arakawayao/digital-receiver/docs/engineering_design_v0.1.md

# 简易数字接收机初版工程设计说明

2026-10-04 源文件核对更正：当前 PLL 为 24 MHz ×5/÷3 / 40 MHz，根目录较新 EDA
放置 AD9235BRUZRL7-40；现有核心板桥接器为 USB 2.0 FX2。本文下列旧 10 MHz
实现描述失配，USB 3.0 仍是未落实的设计目标。当前事实和采样门槛以
[项目审阅结论](project_review_2026-10-04.md) 为准，未改变公共 IQ v1 契约或硬件工程。

版本：v0.3（两款 ADC 并列候选，型号与带通采样配置待定；沿用原文件路径）  
初版日期：2026-09-19；更新日期：2026-09-27  
架构确认日期：2026-09-27  
设计基线：SMA 单信号输入、12 位 ADC 射频带通采样（AD9235 或 ADC12020CIVYX/NOPB）、FPGA 数字下变频、USB 3.0 传输、上位机处理。

## 1. 目的、依据与设计状态

### 2026-09-29 实现增量

本次确定 FPGA 参考时钟为 24 MHz，计划 ADC 采样率为 10 MS/s。现有工程为
Quartus Prime 20.1.1 Lite / Cyclone IV E EP4CE6F17C8，替代下文早期 Artix 候选基线；
`adc_clk_gen` 使用 PLL ×5/÷12，尚未完成板级时钟验证。下文 19/20 MS/s 保留为数学算例。
10 MS/s 的实数采样折叠边界包括 90、95、100、105 MHz，完整占用频带须避开边界并留
保护带；固定此采样率不是已验证的全频段方案，也不能消除未知射频中心的歧义。

在当前计划速率下，原始 12 bit 数据为 120 Mbit/s（15 MB/s 紧凑排列，16 bit 容器为
20 MB/s），均未含协议开销；若后续保持 500 kS/s IQ，需总抽取 20 倍并先实现抗混叠滤波。
现有混频器在 10 MHz 捕获域工作，32 位 NCO，12 位实数输入，输出各 24 位/11 位小数的
I/Q 乘积。详细时序、数值范围和仿真入口见 [FPGA 模块说明](../main_project/fpga/README.md)。
仅采集和混频已通过独立 RTL 仿真，滤波/抽取、USB、上位机及综合上板仍未完成；
不修改既有归一化 IQ JSON 契约。下文未落实的模块继续作为设计计划。

### 方案背景

本文根据项目 README、项目规范及方案讨论，整理 PCB、FPGA、USB 传输和上位机设计。课程需求以根目录任务书为准；本文未重新核读原始 `.doc`，需求引用以 README 的整理为依据。ADC 保留两款并列候选，最终型号、原理图、RTL、软件及实物验证尚未完成。

2026-09-27 确认采用射频直接采样，每次从 SMA 输入单个 AM/FM 信号，使用带通采样降低速率。按最新更正，ADI `AD9235` 与 TI `ADC12020CIVYX/NOPB` 同时作为候选，撤回 ADC12020 单一选型结论；AD9235 的具体速率等级和封装尚未确定。输入经保护、预选滤波及驱动后进入 ADC，不设置模拟混频器或模拟中频；FPGA 数字下变频后经 USB 3.0 SuperSpeed 传输。10.7 MHz 模拟中频文档保留为未采用的历史备选，其中旧直采参数比较不代表本版。

本版采用带通采样，早期第一奈奎斯特区高速采样不是当前基线。ADC12020 最高 20 MS/s；AD9235 有 20/40/65 MSPS 速率等级，须按完整料号检查时钟范围。24/25 MS/s 不适用于 ADC12020 或 AD9235-20；对 AD9235-40/-65 也仅可在时钟、电气和带通采样条件验证后作为候选。单信号约束不自动解决未知 RF 中心频率的混叠歧义，需按第 3 节验证。

| 分类 | 内容 |
| --- | --- |
| 任务要求 | 88–108 MHz 输入；FPGA 采集、数字下变频和预处理后传输；上位机 AM/FM 识别、解调、放音、参数测量及结果管理；电路、PCB、3D 打印设计 |
| 已确定的方向 | SMA 每次单个信号、射频带通采样、12 位 ADC、核心板加扩展板、USB 3.0、SQL 记录管理 |
| 本版建议 | 可配置低抖动采样时钟、折叠频率映射与 I/Q 方向校正、USB 桥接控制器、IQ 文件加 SQL 元数据、电脑声卡输出 |
| 候选而非定型 | AD9235（速率等级/封装待定）与 ADC12020CIVYX/NOPB；Artix 核心板；19/20 MS/s 模型档位；500 kS/s IQ；每分量 16 bit；48 kHz 音频 |
| 待确认 | 实际时钟档位、调制带宽、射频频率识别策略、108 MHz 输入性能、其余器件、输入电平、工具版本及验收指标 |

器件资料来源：[ADI AD9235 产品页](https://www.analog.com/en/products/ad9235.html)、[TI ADC12020 产品页](https://www.ti.com/product/ADC12020)、[ADC12020 数据手册 Rev. B](https://www.ti.com/lit/ds/symlink/adc12020.pdf)。以下来自本对话已核对的官方产品信息，不代表已完成原理图设计或射频性能验证。

| 比较项 | AD9235 | ADC12020CIVYX/NOPB |
| --- | --- | --- |
| 状态 | 并列候选，完整料号待定 | 并列候选，料号明确但未定型 |
| 分辨率/通道 | 12 bit，单通道 | 12 bit，单通道 |
| 最高采样率 | 按等级为 20/40/65 MSPS，不是任意型号都能到 65 MSPS | 20 MS/s |
| 标称模拟输入带宽 | 500 MHz 差分输入带宽 | 100 MHz |
| 主供电 | 标称 3 V，官方范围 2.7–3.6 V | 5 V，容差和时序依手册 |
| 数字接口 | 并行输出，独立驱动电源支持 2.5/3.3 V 逻辑；码型依完整型号/配置核对 | 并行 CMOS/TTL，独立输出驱动电源，offset binary |
| 封装 | 28 引脚 TSSOP / 32 引脚 LFCSP 等选择，按料号确认 | 32 引脚 LQFP |
| 价格 | 用户反馈立创报价约 150 元起，未锁定等级和采购数量，不视为当前保证报价 | 以实际采购渠道、数量和报价为准，不预设更便宜 |
| 主要待验证项 | 具体等级、低采样率下 88–108 MHz 动态性能、驱动及成本 | 100–108 MHz 幅频/动态性能、供电与接口适配、成本 |

两者不默认引脚、封装、供电或时序兼容，也不要求首版 PCB 同时安装两颗 ADC。选型评审后按最终器件画板；如需兼容板，须另行明确需求和成本。各自的引脚、共模/满量程、最低时钟、占空比、输出延迟和建立保持须核对数据手册后再定。

**已知风险：ADC12020 标称 100 MHz 模拟带宽不是硬截止，也不保证 108 MHz 动态性能；AD9235 的 500 MHz 带宽同样不等于 108 MHz 有效精度保证。两者在 88–108 MHz 的幅频、SINAD、SFDR 及解调能力均待验证，不能用低输入频率 ENOB 代替。任务频段不自行缩减，不达标则记录并重新评审。**

目前已有离线 harness、IQ JSON 契约和合成样本，以及上文增量所列采集/混频 RTL；这些独立验证尚不能证明宽带 FM、硬件采集或实时音频可用，已有离线接口保持不变。

## 2. 系统总体架构

```text
单个受控 AM/FM 信号源（88–108 MHz）
      |
     SMA
      |
输入保护、匹配 -> 射频预选/抗混叠滤波 -> 衰减/增益 -> 差分 ADC 驱动
                                                            |
                                   候选 ADC（12 bit）<- 可配置低抖动采样时钟
                                                            |
                            FPGA：并行采集 -> 按折叠频率数字下变频
                                          -> 滤波/抽取、频谱方向校正
                                            -> FIFO/帧封装
                                                    |
                                      USB 3.0 桥接控制器及固件
                                                    |
                                                 USB 3.0
                                                    |
                       上位机接收、解析、连续性检查、有界队列分发
                              |               |               |
                         FFT/参数测量    AM/FM 识别与解调    IQ 分块文件
                              |               |               |
                         SQL 结果管理    音频重采样         SQL 文件索引
                                              |
                                           声卡 DAC
                                              |
                                         扬声器/耳机
```

示波器只作为可选调试测量设备，不在正式采集链路中；这是本版对早期“接示波器”表述的设计假设。若同时观察 SMA 信号，应使用适当功分器、耦合器或探测方式并计入损耗，避免直接并接两个 50 ohm 端接而改变负载。

本版只设计接收功能，原先“射频收发单元”收敛为射频接收前端。频段内的 AM 可由信号源产生；常见中波 AM 广播不在 88–108 MHz 范围内。FM 广播先实现单声道音频，立体声和 RDS 为扩展项。

本版正式输入假设是 SMA 每次一个目标信号。普通天线可能同时接收多个电台，不自动满足该假设；若恢复天线接收需求，必须重新验证模拟预选和混叠分离能力。

## 3. 采样、带宽与速率预算

### 3.1 单信号带通采样与频率歧义

采样率按单个信号的完整占用频带及折叠位置选取，不再要求高于两倍射频载波。ADC 模拟输入仍为 88–108 MHz，射频驱动、输入带宽与采样抖动要求不能按低基带频率替代。SMA 不会滤掉噪声或信号源谐波，模拟前端仍须控制其他可折叠输入。

设信号有效支撑区间为 `[fL, fH]`，包含调制边带与频率不确定性，`B = fH-fL`。理想带通采样区间可按 `2*fH/n <= Fs <= 2*fL/(n-1)`（整数 `n >= 2`）分析，并在两端留保护带。`Fs > 2*B` 只是必要的速率条件，不能保证频谱不会重叠。

折叠边界为 `k*Fs/2`。整个目标信号必须避开边界，不能只检查载波。定义 `m = floor(f_RF/Fs + 0.5)`、`f_signed = f_RF - m*Fs`，折叠后正频率为 `f_alias = abs(f_signed)`；在通带不跨边界时，`s = sign(f_signed)` 表示频谱方向。对有效半带宽 `H` 和保护余量 `G`，要求 `H+G < f_alias < Fs/2-H-G`。

以下只作模型算例，不是已选定硬件时钟。20 MS/s 是 ADC12020 与 AD9235-20 的规格上限示例，不是所有 AD9235 等级的上限。实际设定计入时钟容差；19 MS/s 也须按具体器件检查允许范围和时钟电气条件。

| RF 中心/MHz | Fs/MS/s | m | f_signed/MHz | f_alias/MHz | 处理 |
| --- | --- | --- | --- | --- | --- |
| 88 | 20 | 4 | +8 | 8 | 不翻转 |
| 95 | 20 | 5 | -5 | 5 | 校正频谱翻转 |
| 100 | 20 | 5 | 0 | 0 | 折叠边界，拒绝该配置 |
| 100 | 19 | 5 | +5 | 5 | 可进入带宽/保护带检查 |
| 108 | 20 | 5 | +8 | 8 | 映射可行，模拟性能仍待验证 |

固定 20 MS/s 无法保证任意 88–108 MHz 信号都可恢复；19/20 MS/s 两档也尚未被批准为全范围方案。需对实际信号带宽、频差、滤波过渡带和时钟误差扫描验证，非法配置明确拒绝，不使用有损折叠后的信号伪造有效解调。

**单信号仍有 RF 频率歧义。** 20 MS/s 时，88、92 和 108 MHz 均可映射到 8 MHz。已知粗略 RF 范围时，可由该范围确定候选区间，再测残余频偏；粗调输入不是测量结果。未知中心频率时，需不同采样率的测量交集、可调预选或其他独立信息判别，不能只凭单次 FFT 回填 RF 频率。

本版建议先评估多采样率候选集合匹配：按测得的别名频率和误差枚举 `m*Fs ± f_alias` 中落在 88–108 MHz 的候选，用其他采样率的结果筛选。只有唯一候选且稳定性检查通过，才输出有效中心频率；无候选/多候选均报告未确定。采样间信号频率和调制统计需足够稳定，不满足时该方法不能保证识别。19/20 MS/s 是否足以消歧须单独验证，不能把算法待实现当成系统已满足测频要求。

### 3.2 参数建议

| 参数 | 候选值/约定 | 定型条件 |
| --- | --- | --- |
| ADC 型号 | AD9235 或 ADC12020CIVYX/NOPB，并列候选 | 最终料号、封装、价格及 RF 性能待评审 |
| ADC 输入 | SMA 单个实数射频信号 | 输入电平、阻抗和保护门限待定 |
| ADC 采样率 | ADC12020 最高 20 MS/s；AD9235 依 20/40/65 等级 | 实际档位待定，19/20 MS/s 仅为模型算例 |
| ADC 分辨率/码型 | 两者均 12 bit；ADC12020 为 offset binary，AD9235 按型号配置核对 | 在采集入口统一补码；ENOB 和 108 MHz 性能待验证 |
| RF 调谐中心 | 88–108 MHz | 先明确折叠区间，NCO 使用别名频率而非直接填 RF |
| 复数基带采样率 | 候选 500 kS/s | 20/19 MS/s 示例分别抽取 40/38，系数待设计 |
| 初步基带通带 | 约 -100 至 +100 kHz | 仅作宽带 FM 预算起点，随频偏和测试信号调整 |
| 传输样本 | I、Q 各有符号 16 bit | 明确缩放、舍入及饱和 |
| 音频 | 48 kHz、单声道 | 需重采样和声卡时钟漂移处理 |

FM 带宽可先用 Carson 估计 `B ≈ 2 * (频偏 + 最高调制频率)` 并结合实测。例如 ±75 kHz 频偏和 15 kHz 调制对应约 180 kHz，只是论证示例，不是已确认指标。立体声复合基带、频率失配和滤波过渡带需要额外预算。

现有离线样本的 48 kS/s 复数基带和 2 kHz FM 频偏是算法小样本，不能直接验证这里的宽带 FM，也不能与候选 48 kHz 音频采样率混为一谈。

### 3.3 传输与存储预算

下表使用十进制 MB/GB，以 19/20 MS/s 模型档位举例，常规持续传输对象为抽取后的 IQ。20 MS/s 的预算不是所有 AD9235 等级的最坏情况；若选更高实际速率，按 `Fs*12/8`（紧凑码）或 `Fs*2`（16 bit 容器）重新计算原始字节率和缓存，并重算抽取，不能直接沿用本表。

| 数据 | 计算 | 有效负载速率 |
| --- | --- | --- |
| ADC 原始 12 bit，20 MS/s 示例 | 20e6 * 12 | 240 Mbit/s，即 30 MB/s |
| ADC 原始 16 bit 容器，20 MS/s 示例 | 20e6 * 16 | 320 Mbit/s，即 40 MB/s |
| ADC 原始 12 bit，19 MS/s 示例 | 19e6 * 12 | 228 Mbit/s，即 28.5 MB/s |
| 单通道复数 IQ | 500e3 * (16 + 16) | 16 Mbit/s，即 2 MB/s |
| IQ 连续一小时 | 2e6 * 3600 | 7.2 GB，不含帧头和文件开销 |
| 单声道 16 bit PCM | 48000 * 16 | 0.768 Mbit/s，即 96 kB/s |

USB 3.0 SuperSpeed 的 5 Gbit/s 是链路信号速率，8b/10b 编码后的理论上限为 4 Gbit/s，应用负载还受 USB 协议、桥接总线、固件、驱动和主机影响。降低 ADC 速率后，原始流仍需独立验证，不能只凭链路标称值保证持续上传。常规模式保持传输 IQ；原始快照/流的码型、协议和缓存未定义，不混入现有 IQ 帧。

每帧暂用 4096 个复数样本、16384 B 负载和 80 B 帧头，应用帧开销约 0.49%，数据速率约 2.010 MB/s，帧积累时间约 8.192 ms。建议实测持续吞吐至少留 25% 余量，即不低于约 2.513 MB/s，并单独测试停顿恢复。这是项目建议门槛，不是课程正式指标。

缓存按 `容量 >= 数据产生速率 * 允许停顿时间` 估算。2 MB/s 下吸收 100 ms 停顿至少需约 200 kB 样本空间，另加实现余量。约 256 KiB 可作为评估起点，但必须先核对 BRAM、桥接缓存和主机队列；更长停顿需更大缓存或明确丢样，不能靠平均吞吐掩盖。

## 4. PCB 与硬件设计

### 4.1 核心板与扩展板

核心板暂以 Artix 系列为候选，承担 FPGA、配置存储、JTAG 及已有电源；DDR 仅在缓存确有需要且核心板支持时采用。具体型号、封装、速度等级和工具版本未确定。

扩展板建议包括 SMA、射频前端、ADC、采样时钟、USB 桥接控制器、USB 连接器、局部供电、按键/开关和指示灯。若核心板已有其中部分功能，应调整归属避免重复设计。本版不配置以太网 PHY/RJ45、发射功放或模拟混频本振。

采购核心板前必须确认 ADC 的 12 路并行数据、时钟及控制信号能接入连接器，核对 Bank 电压、输入阈值、时钟引脚、板间延迟和走线条件。不能只按逻辑单元数量选板。

### 4.2 射频、ADC 与时钟

| 模块 | 设计要求 | 主要检查 |
| --- | --- | --- |
| SMA 与保护 | 候选 50 ohm 接口，评估保护器件寄生和限幅 | 输入匹配、最大安全输入、插损 |
| 预选/抗混叠滤波 | 覆盖目标及边带，抑制可混叠信号和强带外干扰 | 通带、阻带、端点及边带响应 |
| 衰减/增益 | SMA 单信号测试防过载，按输入范围决定增益；天线模式不作为当前基线 | 噪声、压缩、互调、削顶 |
| ADC 驱动 | 单端至差分、共模、满量程依器件资料设计 | 失真、摆幅、共模、带宽 |
| ADC | AD9235 / ADC12020CIVYX/NOPB 按候选分别核对等级、封装、接口及射频性能 | 外部已知输入、幅频、SINAD、SFDR、108 MHz 端点 |
| 采样时钟 | 可配置低抖动时钟、适当分配与端接，切换时禁止输出有效数据 | 实际档位、占空比、稳定、频率误差、杂散 |

ADC12020 使用 12 bit 并行 CMOS/TTL 输出，不采用 LVDS 或 JESD204 接口，也不假定存在 ADC 输出数据时钟或内建测试码。依据输入采样时钟、数据输出延迟和 FPGA 建立保持要求选择捕获边沿/相位，并建模 PCB 延迟。数字码测试由外部已知输入或仿真注入提供，具体校准方式待电路确定。

AD9235 也按并行接口评估，但单独核对其控制引脚、码型、输出时序和驱动电源，不能直接复制 ADC12020 的捕获约束。最终两种采集适配方案均向 DDC 提供统一有符号样本语义；未选型前可建立参数化模型，不制造未经核实的器件时序值。

ADC12020 按 5 V 主供电及独立 `V_DR` 设计；AD9235 按标称 3 V 主供电及其输出驱动电源设计。各自的电压范围、启动条件和 FPGA Bank 兼容性须依手册核对，不可混用，更不能把 5 V 数据直接接入 Artix。参考电压、差分满量程和共模分别核对，SMA 信号不能未经驱动/匹配直接套用 ADC 满量程。

抖动限制可用 `SNR_jitter = -20*log10(2*pi*f_in*t_jitter)` 估算。100 MHz 输入、1 ps 总 RMS 抖动对应约 64 dB，尚未计入 ADC 自身噪声；应分配时钟与 ADC 孔径抖动预算，不能用标称位数替代有效性能。

### 4.3 USB 3.0 子系统

建议独立 USB 3.0 桥接/设备控制器，FPGA 通过并行 FIFO 或等效本地接口发送数据。FX3 类方案可作为候选类别，尚未核实或指定型号。普通 FPGA GPIO 不能直接连接 SuperSpeed 差分线，USB 协议栈也不是 Artix 默认自带功能。

选型同步确认本地总线位宽/时钟/握手、电平、Bulk 端点、控制接口、固件及启动存储、主机驱动、合法 VID/PID 使用方式和持续吞吐。FPGA 至桥接器的本地带宽需要单独验算。

数据面采用 Bulk IN，控制面用控制传输或独立命令端点完成识别、配置、启停和状态回读；端点地址待器件确定。固件负责 DMA、缓冲、错误统计和 USB 复位处理，不能只完成设备枚举。

连接器待机械及供电方案确定。若用 USB-C，需正确设计 CC、角色、电流声明及插头翻转下的 SuperSpeed 走线/切换，不能简单并联双面高速引脚。线缆和连接器均需支持实际 SuperSpeed 链路。

### 4.4 电源、布线和结构

- 分别估算 FPGA、ADC、驱动、时钟、USB 控制器和前端功耗及启动时序。USB 总线或独立供电待定，不假定一个 USB 口足够供电；独立供电需处理 VBUS 检测和防倒灌。
- 射频、ADC 和时钟区域远离开关电源与 USB 高速区；保持连续参考平面，避免机械分割地平面导致高速回流跨缝。
- USB SuperSpeed 差分阻抗通常以 90 ohm 为目标，ADC 并行单端数据按器件要求；最终线宽、间距和时序容差由板厂叠层和器件指南计算，不猜定。
- ADC 采样时钟与并行数据、USB 差分对和板间连接分别设置约束，检查过孔、支路、参考层切换及连接器损耗。
- 按键建议用于复位及启停，开关用途待定；指示灯区分电源、配置就绪、USB、采集中和错误。控制模块统一处理防抖及主机命令优先关系。
- 预留测试点时避免高速长支路，执行原理图 ERC、PCB DRC，并记录豁免依据。
- 外壳核对 SMA/USB 插拔空间、核心板叠高、安装孔、散热和测试可达性，打印后实装验证。

## 5. FPGA 设计

### 5.1 模块划分

| 模块 | 主要职责 |
| --- | --- |
| 时钟与复位 | 各域时钟和同步释放复位，失锁时禁止输出有效数据 |
| ADC 采集 | 按候选的 12 路并行接口接收、捕获时序验证、流水线对齐及码型归一化 |
| 质量统计 | 过量程/削顶计数、采集错误及时钟状态 |
| NCO 与复数混频 | 别名频率调谐、相位推进、乘法、控制对齐及频谱方向校正 |
| 多级滤波抽取 | 抗混叠、带宽限制、速率降低和增益补偿 |
| 定点输出 | 缩放、舍入、16 bit 饱和及统计 |
| 缓冲与帧封装 | FIFO、样本索引、序号、状态和 CRC |
| USB 本地接口 | CDC、写入握手、流量控制和错误统计 |
| 控制寄存器 | 采样时钟配置、边界合法性、折叠区间/方向、启停、版本及状态回读 |

### 5.2 混频、滤波和定点

统一 `z[n] = I[n] + j*Q[n]`，正相位变化为正基带频率，与离线 IQ 契约一致。实数 ADC 输入采用：

```text
I_mix[n] =  x[n] * cos(phase[n])
Q_mix[n] = -x[n] * sin(phase[n])
phase[n+1] = phase[n] + 2*pi*f_NCO/Fs
```

NCO 使用目标 RF 的别名频率。正频率 DDC 后得到原始 I/Q，`s=+1` 时直接使用，`s=-1` 时在宽位宽域取共轭，再舍入/饱和，避免 int16 最小负数取负溢出。选择不跨折叠边界的整数 `m` 和方向 `s`，定义实际数字调谐对应的 `f_tuning = m*Fs + s*f_NCO`；校正后的频偏为 `f_RF - f_tuning`。不能将低速 NCO 值本身当作射频中心频率。

实数余弦混频的目标分量含 1/2 幅度因子，须纳入增益预算。I/Q 顺序、校正方向和缩放改变时同步模型与主机；频率区间未确定时不能把候选方向当成有效结果。

可先评估 32 bit 相位累加器，20 MS/s 示例的步进约 `Fs/2^32 = 0.00466 Hz`。这只是数字调谐分辨率，实际 RF 精度受折叠区间判别、时钟误差、校准及估计算法限制；RF 误差预算仍需考虑约 100 MHz 输入，不能按小的别名频率低估时钟影响。

若保持 500 kS/s IQ，20 MS/s 示例总抽取倍数为 40，19 MS/s 示例为 38；任意时钟不一定能用整数抽取得到相同输出率，需要约束档位或设计有理重采样。各档分别确定多级结构、通阻带、纹波、抑制度、位宽和滤波配置 ID，可比较 CIC、补偿 FIR 和多相 FIR，不能只验证倍率乘积。

CIC 的通带下垂、有限阻带和增长位宽需计算；每级抽取前抑制会折叠入最终有效通带的分量，末级滤波无法消除已经产生的混叠。滤波系数尚未确定。

ADC12020 输出为 12 bit offset binary：整数意义上 `signed_sample = unsigned_code - 2048`，范围为 -2048 至 2047；可翻转最高位后按有符号补码解释。AD9235 的实际码型在完整型号和配置明确后记录：若为 offset binary 则用相同转换；若为补码则直接有符号解释，不能重复偏移。两者在进入 DDC 前统一有符号语义，扩位明确符号扩展。乘法/累加器按最坏情况定宽，每个缩位点记录移位、舍入和饱和；USB I/Q 各 16 bit 是处理后容器，不表示 ADC 精度提高。

并行 ADC 按每个采样周期一个 12 bit 样本设计，DSP 时钟与流水线由资源/时序评估决定。不同采样档位均需独立检查时序约束、NCO 步进、抽取系数及样本索引，不继续沿用高速解串接口假设。性能以综合、实现时序及上板为准。

### 5.3 时钟域、反压和异常

采集域、DSP 域、USB 本地接口域依实际设计划分，多位数据跨域采用异步 FIFO 或握手，控制信号采用适当同步。流接口明确 `valid/ready`，停顿期间保持数据与控制稳定。

ADC 连续采样，不能因 USB 反压假定输入暂停。建议以完整 IQ 帧管理缓存，空间不足时丢弃新产生的完整帧，继续推进样本索引和生产序号并增加丢样计数；下一可交付帧报告间断/溢出。不能拼接部分新旧帧，桥接侧仅在确认有空间后接收数据。

时钟失锁、ADC 失步或严重采集错误时停止输出有效样本并保留状态，恢复后重新校准及建立新流。调谐、采样配置变化和重启也建立新 `stream_id`，滤波过渡期结束后再发送有效数据。

采样时钟切换顺序为停止旧流、修改时钟、确认稳定、复位/清空旧配置流水线和 FIFO、加载新 NCO/滤波/方向配置、回读后启动新流。时钟确认方式及等待时间依器件资料和实测确定。没有 ADC 内建锁定/错误指示的状态不得虚构为已检测，需说明由时钟芯片、FPGA 监测或软件判断的来源。

## 6. USB 应用协议草案

本节为待 FPGA/HOST 联合评审的线上协议提案，尚未实现。现有 `docs/iq_contract.md` 离线 JSON v1 不变。USB Bulk 读取边界不是应用帧边界，主机必须处理分片、合并和残留数据。

### 6.1 帧布局建议

固定 80 B 帧头，随后为 IQ 负载；多字节整数及浮点值采用小端，浮点采用 IEEE 754 binary64。负载为 `I0,Q0,I1,Q1,...`，每分量 `int16`，每复数样本 4 B。

| 偏移/B | 长度/B | 字段 | 语义 |
| --- | --- | --- | --- |
| 0 | 4 | magic | ASCII `IQS1` |
| 4 | 2 | version | 本草案为 1 |
| 6 | 2 | header_bytes | 本草案固定 80 |
| 8 | 4 | payload_bytes | 等于 `sample_count * 4` |
| 12 | 4 | flags | 间断、FIFO 溢出、削顶等，位定义待冻结 |
| 16 | 8 | stream_id | 主机分配，会话内不重复；新流重新开始索引 |
| 24 | 8 | sequence | 从 0 起的生产帧序号，被丢弃帧同样消耗序号 |
| 32 | 8 | first_sample_index | 首个样本的流内计划输出索引，丢样仍推进 |
| 40 | 8 | sample_rate_hz | 正有限 binary64，复数基带采样率，标称/校准来源另存配置 |
| 48 | 8 | tuning_center_hz | 有限 binary64，已确定折叠区间下的 RF 调谐中心，不是别名频率或测量结果 |
| 56 | 4 | config_id | 与该流不可变配置记录关联 |
| 60 | 2 | sample_format | 候选编码 1 表示归一化有符号 16 bit I/Q |
| 62 | 2 | channel_count | 本版固定 1 |
| 64 | 4 | sample_count | 正常 4096，停止时可发送非零短帧 |
| 68 | 4 | reserved | 置 0 |
| 72 | 4 | header_crc32 | 覆盖帧头字节 0–71 |
| 76 | 4 | payload_crc32 | 覆盖完整 IQ 负载 |

CRC 建议使用 CRC-32/ISO-HDLC，反射多项式 0xEDB88320，初值和最终异或均为 0xFFFFFFFF，`123456789` 检验值为 0xCBF43926。USB 已有链路检错，应用 CRC 用于封装、保存和回放检查；实现前冻结共用测试向量。

接收端限制最大 4096 个复数样本，先检查头部和长度，再接收/分配负载；拒绝未知版本、格式、非有限或非法数值。CRC 错误、帧序号或样本索引不连续均产生可见事件，重新同步不伪造连续数据。

16 bit 分量转离线浮点时采用 `value / 32768`，范围为 `[-1, 1)`，仅为数字归一化幅度；电压/功率解释需要模拟增益、满量程和校准信息。离线 JSON v1 只导出连续片段，不能把有缺口样本直接拼成一个 capture。

### 6.2 控制与生命周期

建议命令为 `GET_INFO`、`GET_STATUS`、`SET_CONFIG`、`START`、`STOP`，请求标识和明确应答用于确认执行结果。实际 NCO 频率、采样率、滤波、缩放、固件版本和错误计数可回读；本版不冻结端点地址和寄存器位定义。

控制面和持久化配置补充 ADC 完整型号/速率等级、输入码型、实际/标称 ADC 时钟及来源、RF 搜索范围、折叠整数 `m`、方向 `s`、别名 NCO、方向已校正标记、频率候选/确定状态和滤波配置 ID。80 B 帧布局与离线 JSON v1 不变；`sample_rate_hz` 仍是 IQ 速率，`tuning_center_hz` 仍是 RF 调谐中心。主机不得二次取共轭。未知 RF 的探测阶段数据另作待定分析，正式连续 IQ/JSON 输出前必须有明确 RF 映射；原始实数探测数据协议另行定义，不伪装成已确定 RF 的 IQ 帧。

先保存配置再启动采集；配置变化先结束旧流，新配置生效后建立新流。主机保存启动 UTC 时间和单调时钟参考，样本索引用于相对采集时间，不能把 USB 到达时间当作精确采样时刻。新流索引零点为滤波稳定后的首个计划有效样本。

USB 断连时结束当前流、取消传输并记录原因；重连重新核对设备和配置。检测实际协商速度，本版要求 SuperSpeed，降为 USB 2.0 默认拒绝启动并提示；后续如支持降级，需独立预算和验证。

## 7. 上位机设计

### 7.1 模块与技术栈候选

首版可评估 Python + NumPy/SciPy 算法、Qt/PySide 界面、SQLite 本地 SQL、USB 库或厂商 SDK 异步传输和成熟音频库。它们是候选依赖，尚未安装或写入项目；确认主机系统、驱动、许可证、分发和性能后再确定。现有标准库 harness 不因此增加依赖，PyTorch 不是必需条件。

| 模块 | 职责 |
| --- | --- |
| 设备接入 | 枚举、版本检查、配置、异步接收、取消及重连 |
| 协议解析 | 分片缓存、CRC/字段校验、流与缺口识别、I/Q 转换 |
| 数据分发 | 有界队列、DSP/记录/显示分发、水位和延迟统计 |
| 信号处理 | 通道滤波、FFT/PSD、识别、测频、解调和重采样 |
| 音频 | 回调、音量、静音、缓冲和时钟漂移控制 |
| 记录管理 | IQ 文件、SQL 事务、查询、分类、回放及导出 |
| 界面 | 设备状态、调谐、频谱、结果、录制和历史记录 |

USB、磁盘、DSP 和界面刷新分开调度，不能相互无限阻塞。音频回调避免访问数据库、磁盘和耗时计算，信号按块处理，不在 Python 层逐样本循环处理高速流。

### 7.2 FFT、中心频率与识别

FFT 使用窗函数、幅度归一化和可选平均，显示当前接收通道频谱。bin 间隔 `Fs_IQ/N` 不等于测量准确度。全频段同时显示/扫频属于扩展，不能把单通道频谱标成完整 88–108 MHz 实时频谱。

仅在折叠区间已确定且 FPGA 完成方向校正后，中心频率采用 `f_center_est = f_tuning + f_offset_est`。载波明显的 AM 可评估峰值插值或载波跟踪；FM 可结合占用频带中心、鉴频均值及观测条件估计。不能把最大 FFT 峰或用户粗调值直接当作 RF 测量结果。未消除歧义时报告未确定并保留候选，不强制生成有效 RF 数值；测量记录包含方法、输入先验、观察时长、有效性及校准信息。

先判断有无有效信号、削顶和带宽，再根据包络变化、瞬时频率变化及谱特征识别，允许 `AM`、`FM`、`unknown`、`no_signal`。低信噪比、未调制载波及混合信号可能无法可靠区分；保留不确定状态，不能读取样本真值标签完成判别。

### 7.3 解调与放音

- AM：常规带载波 AM 采用包络检测、去直流、音频低通和电平控制；抑制载波 AM、SSB 不在首版保证范围。
- FM：可用 `arg(z[n]*conj(z[n-1])) * Fs_IQ/(2*pi)` 鉴频，频偏加残余频差必须满足相位差不混叠条件；低幅度和无信号时抑制异常音频。
- 广播 FM 去加重常数依接收标准选择并保存，不能对所有信号无条件使用同一常数。单声道输出需滤除无用复合基带分量。
- 500 kS/s 至 48 kHz 可用分阶段或有理重采样，总比例 12/125，满足抗混叠；AM/FM 各自设置合适音频带宽。
- ADC 和声卡时钟独立，会造成长期缓冲漂移，应根据水位反馈做小幅自适应重采样或其他经验证的速率匹配，不能只设置相同名义采样率。
- 丢样、重调谐或无信号时重置相关滤波/鉴频状态，静音或淡入淡出，并保留事件，不能跨缺口按相邻样本鉴频。

数字音频交给电脑声卡 DAC 转为模拟信号，由扬声器、耳机或有源音箱输出。麦克风是输入器件；扩展板本版无需额外音频 DAC。

### 7.4 IQ 文件与 SQL 记录

采用“按块保存 IQ 二进制文件 + SQLite 元数据及索引”，保留 SQL 需求，但不逐样本写 SQL 行，以减少事务开销和存储放大。波形文件可保存带版本、索引和 CRC 的应用帧，另存完整配置，并支持离线回放。

| 逻辑表 | 建议字段内容 |
| --- | --- |
| captures | 采集 ID、UTC 起止时间、设备/固件/软件版本、结束原因 |
| stream_configs | 流标识、ADC 型号、ADC/IQ 速率、RF 调谐、折叠区间/方向、NCO、先验/确定状态、滤波、位宽、缩放、增益、校准 |
| segments | 文件位置、字节偏移、起止样本索引、样本数、连续性与校验 |
| measurements | 流及样本区间、中心频率及单位、调制类型、有效性、算法版本 |
| events | 断连、丢样、FIFO 溢出、削顶、磁盘异常及对应索引/时间 |

按时间、中心频率、调制类型检索分类，支持测量结果和音频导出。SQL 使用参数化查询，旧记录保留原配置；实际表结构、外键、索引和迁移版本待实现时定义。

按大小或时间切文件，写入成功后提交对应索引，关闭时执行必要持久化；崩溃恢复检查未完成片段和数据库/文件一致性。录制前检查空间并配置保留策略，默认不自动删除历史数据。

显示队列满可丢过时刷新；DSP 为恢复实时性丢积压数据时需报告缺口并重置状态；录制队列或磁盘异常时停止该次录制并记录原因，不能静默丢块仍称完整波形。严格无丢样模式中，任一丢样应使该次采集失败。

## 8. 验证计划与交付门槛

以下均待执行，本次文档编写没有完成相应功能验证。

| 阶段 | 验证内容 | 证据 |
| --- | --- | --- |
| 需求/预算 | 带宽、电平、干扰、成本及功耗 | 器件资料、预算、未决项 |
| 浮点模型 | 单个 RF AM/FM 的带通采样、正负频偏、边界碰撞、不同采样率及 RF 消歧，另测噪声/谐波 | 频率映射、共轭校正、非法配置拒绝和有效测频结果 |
| 定点模型 | 按候选码型配置检查 12 bit 转换、符号扩展、最小负数共轭、量化和饱和 | ADC12020 的 offset binary 边界及 AD9235 实际配置对应向量 |
| RTL 仿真 | 并行 ADC 模型、复位、有效间断、反压、FIFO 满空、时钟/滤波配置切换 | 捕获时序、流水线对齐、丢帧/索引结果 |
| USB/主机 | 分片/合帧、非法长度、CRC、断连、复位、慢消费者 | 协议向量、持续吞吐、水位、恢复日志 |
| 综合实现 | 真实器件、时钟和接口约束 | 工具/IP 版本、资源、CDC 与时序报告 |
| PCB | ERC/DRC、叠层、阻抗、供电和连接器 | 源工程、BOM、制造输出及豁免依据 |
| 上板 | 按最终候选核对主/输出供电、FPGA 电平、时钟、已知 ADC 输入、USB 和采样 | 电压/电流、幅频、捕获时序、SINAD/SFDR，重点记录 100–108 MHz |
| 系统 | SMA 单个信号覆盖 88/108 MHz 及代表点 AM/FM，含未知 RF 和折叠边界 | RF 消歧、测量、音频、丢样、回放及 SQL 查询记录 |
| 长时运行 | USB/磁盘停顿、声卡漂移、热稳定、断连恢复 | 延迟、水位、错误、运行时长和温度 |
| 结构 | PCB、线缆与打印件实装 | 间隙、可达性、散热检查 |

频率精度、最低输入电平、最大无损输入、识别准确率、音频质量、延迟和连续运行时间尚无正式阈值，应在采购前补齐。能发声不等于参数验收完成，离线 harness 通过不能替代 RTL、时序或系统验证。

现有入口为 `python -B -m harness.runner run --jobs 3`；后续只有真实可运行的检查才加入 `harness/tasks.json`。当前协议草案不改变离线 JSON v1 和已有样本参数。

## 9. 实施顺序与未决事项

1. 确认预算、可用仪器、输入电平和 AM/FM 测试范围，评审候选参数。
2. 比较 AD9235 完整料号与 ADC12020CIVYX/NOPB 的报价和 RF 性能，再联合选择 ADC、Artix 核心板、时钟及 USB 桥接器，核对供电/时序。
3. 建立单信号带通采样、边界拒绝、方向校正和 RF 消歧模型，再冻结时钟档位、滤波、定点及 USB 应用协议。
4. 用模拟数据贯通 FPGA 封装、USB 固件、主机接收及回放，再接 ADC/DDC，各阶段独立留证。
5. 完成原理图、PCB、供电/时钟/采集联调，接入识别、解调、音频和记录管理。
6. 完成外壳、系统测试及课程交付，按实测修订设计。

五人分工沿用工作计划：HW 负责选型/原理图/PCB；FPGA-A 负责采集、CDC、封装及 USB 桥接固件集成；FPGA-B 负责 DDC 和定点参考模型；HOST 负责上位机；INT 负责公共契约、结构和验收协调。人员待指定，目录归属继续遵循 `docs/work_plan.md`，USB 固件文件归属在实际建目录前由 INT 与 FPGA-A 明确。

| 未决事项 | 影响 | 决策依据 |
| --- | --- | --- |
| 两款 ADC 的最终选型与核心板型号 | 108 MHz 性能、速率等级、供电/并行时序、成本 | AD9235/ADC12020 资料与实测、实际报价、核心板原理图 |
| 输入范围和干扰条件 | 保护、增益、衰减、滤波 | 信号源、天线环境及验收条件 |
| USB 桥接器/连接器/主机平台 | 驱动、固件、电平、供电、布线 | SDK/接口资料和持续吞吐实测 |
| 采样档位、RF 消歧和校准 | 是否可恢复完整边带、是否可唯一测频 | 带宽/边界扫描、多率候选集合、时钟及高频实测 |
| 通道带宽和滤波 | 资源、音质、邻道抑制 | 调制参数及模型 |
| 缓存和记录策略 | 丢样、成本、时延 | 停顿测试、BRAM/存储预算 |
| 叠层、散热和供电 | 可制造性、完整性、便携性 | 板厂参数、功耗、结构 |
| 正式指标与交付格式 | 课程验收 | 补充规范及评审结论 |

后续调整采样率、I/Q 格式或协议时，同步更新 FPGA、USB 固件、上位机、参考向量和文档，不仅修改单端。

## 10. 后续 Harness 工作入口

后续对话先读取本方案、`docs/work_plan.md`、`docs/iq_contract.md` 和 `harness/tasks.json`。AD9235 与 ADC12020CIVYX/NOPB 均为候选，W-009 未完成，W-005 需分别核对接口时序。模型的器件身份、速率等级/上限、实际时钟和码型应参数化，不能把 ADC12020 当唯一硬件。现有 JSON 描述连续归一化基带 IQ，不是原始 RF 数据，不静默修改该契约。

建议优先补充以下真实模型/测试，完成后再按已有工作包和 writes 规则注册 harness；本次未新增可执行检查，也未运行硬件验证：

1. 参数化 RF 合成与带通采样，检查完整边带、保护带及候选器件/等级的时钟上限。19/20 MS/s 仅为样例；ADC12020 和 AD9235-20 拒绝超过 20 MS/s，AD9235-40/-65 按对应等级独立校验，不全局禁止或允许 24/25 MS/s。最低频率/占空比等未核实参数标待定。
2. 同别名不同 RF 的歧义用例、多采样率匹配、频率不稳定及不能唯一判定的错误路径；频率识别不得读取样本真值标签。
3. 上下折叠方向、正负频偏、AM/FM 解调极性与 RF 元数据；覆盖折叠到直流/Nyquist 附近必须拒绝的情况。
4. ADC12020 的 12 bit offset binary 0/2047/2048/4095 边界，以及 AD9235 最终码型配置对应转换；共同检查符号扩展、共轭、饱和和按实际档位的抽取/重采样，不把未确认 AD9235 码型写成器件事实。
5. 时钟切换的新流/配置同步、USB 反压/缺口和上位机回放，实际 RTL/USB 入口就绪后再注册对应检查。

离线模型只能验证数学和接口逻辑，不能证明任一候选在 108 MHz 的实际性能，也不能替代时钟、PCB 和实时音频验证。正式验收指标仍待确认。
