arakawayao/digital-receiver/main_project/host/docs/FM_ANTENNA_AUDIO.md

# 天线 FM 播放诊断

后续用户排查：停止接收后播放视频也有嗡声，Windows 24 位输出有杂音、16 位无此现象。
因此下文 WAV 听感不能单独作为射频干扰证据；不依据该听感判定 LNA 故障或增加陷波器。

2026-10-26。对象：手动 103.7 MHz，天线经 88–108 MHz 滤波器与约 46 dB LNA 接入 ADC。
用户另报告 93.4 MHz 类似现象，但本次没有收到该频道的数据。

## 实际采集证据

用户采集位于 `D:/class_project/main_project/`，目录分别为：

- `capture_20261026_164238_735271`，去加重关闭，约 3.976 秒。
- `capture_20261026_165140_813586`，75 µs，约 4.015 秒。
- `capture_20261026_165226_885213`，50 µs，约 4.016 秒。

三份均为 USB 手动 103.7 MHz，用户确认都经过 LNA、停止后保存；去加重改变后仍听到嗡声。
保存时间与最后有效帧时间的差异不能当作运行中断流证据。

三份保存的 I/Q 索引连续，元数据记录 CRC、序号间断、FPGA/主机丢样和削顶帧均为 0；
独立按 40 ms 分块识别分别有 99/100/100 块，全部 FM。保存音频未发现反复长段静音。
这些结论只覆盖已保存窗口，不排除其他时刻识别跳变或模拟前端过载。

第一份主要音频峰约 196/330 Hz，随时间变化，不能认定为 50/100 Hz 工频。
50/75 µs 两份录到不同时刻节目，不能用相互频谱差异作去加重的受控比较。
用户确认 WAV 也有嗡声，说明该现象不只发生在实时扬声器缓冲。
在没有节目参照或前端对照前，不强制滤掉这些频率，以免损伤语音和音乐。

旧进程音频计数跨采集累计；例如 1816 欠载、999 溢出不能写成本次 48 秒内的次数。
元数据中的音频设备异常也需通过新会话的具体回调状态复核。

摘要与同一份 I/Q 解调的 0/50 µs WAV 对照在 `evidence/fm_audio_20261026/`。

## 音频长时间播放修正（2026-10-27）

用户实测日志显示仅音频欠载/溢出增长，USB CRC、I/Q 连续性和 DSP 丢弃没有增长。
这将问题范围收敛到输出设备回调调度和音频有界队列，不归因于 RF 或 USB。

Windows 默认 MME 设备实测回调可能约每 40 ms 成批到达，虽然程序按 20 ms 请求 960 点；
旧 120 ms 预缓冲和 250 ms 容量遇到长时间调度抖动时可能先回调空窗欠载，再在处理线程追赶时溢出。
新版默认设备选择优先使用与系统默认输出同名且支持 48 kHz 的 Windows WASAPI，
打开失败才回退系统默认设备；用户在设备下拉框中明确选择的设备不自动替换。
队列会按实际设备 latency 配置预缓冲 `max(120 ms, latency+80 ms)`，容量为预缓冲加
`max(250 ms, latency+120 ms)`；仍是有界队列，不伪造样本。

日志新增实际设备、Host API、延迟、预缓冲/容量，以及交付最大间隔、回调最大间隔、
回调耗时、丢弃点数、欠缺点数和清空原因。保存的 integrity.stats.audio_diagnostics 同样保留这些字段。
因此后续长测可区分设备回调批处理、DSP 交付停顿、分类切换清空与真实输出欠载。

## 原有软件修改

- 音频预缓冲曾从 40 ms 改为 120 ms；当前按输出设备延迟动态配置，容量保持有界。
  40 ms 原门限只有一个 DSP 批次，容易受调度抖动影响。真实断流仍计欠载，未补造音频。
- 每次采集开始重置音频计数；数据间断清缓存时仍保留本次计数。
- 元数据记录预缓冲、计数范围、扬声器启用状态与设备回调原始状态。
- 异常时限频记录欠载、溢出、设备状态、剩余缓冲和队列/回调诊断；GUI 不执行 USB/音频阻塞操作。
- 不修改 FPGA、射频链路、分类门限或解调音频频率响应。

针对确定性 60 ms 音频交付停顿，动态缓冲压力测试无欠载/溢出；
测试同时检查真实长断流仍触发欠载和重新预缓冲。完整上位机回归需以当前测试结果为准；
离线通过不代表实机播放已修复。

## 待实测

完全退出旧进程，从 `start_host.bat` 重启，日志应包含“音频缓冲 r2”。
先用手动 103.7 MHz、50 µs 去加重连续接收，运行中保存并比较本次音频计数及听感。
再旁路 LNA 或降低增益，保持频道及其他条件，记录电平、是否能听清语音与嗡声变化。
旁路后若信号过弱，不应据此直接判定 LNA 过载。
补采 93.4 MHz。嗡声根因、两频道实际连续放音和全频段验收仍未完成。
