arakawayao/digital-receiver/main_project/host/ads807/assets/receiver.png

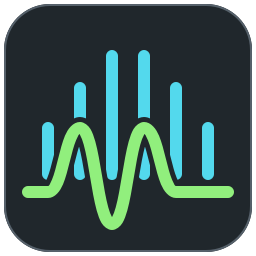
main_project/host/ads807/assets/receiver.png
