arakawayao/digital-receiver/(list of files, cad)

Other CAD files:
main_project/fpga/receiver/stp3.stp
main_project/fpga/receiver/receiver56.stp
