arakawayao/digital-receiver/main_project/host/tools/requirements-build.txt

# Build-time only; the receiver runtime dependencies remain unchanged.
pyinstaller==6.16.0
pyinstaller-hooks-contrib==2026.9
altgraph==0.17.5
packaging==26.3
pefile==2023.2.7
pywin32-ctypes==0.2.3
setuptools==84.2.1
