arakawayao/digital-receiver/main_project/fpga/receiver/validation/live_adc/receiver56_live_20261015_212018.csv

sample_index | time_from_window_start_s | i | q | envelope | recovered_message_normalized | rf_estimate_hz
145441650 | 0.000000000 | 6493 | 9525 | 11527.561494 | 0.86530463 | 93000000
145441660 | 0.000020000 | 4943 | 7127 | 8673.371778 | -0.32375937 | 93000000
145441670 | 0.000040000 | 5508 | 8663 | 10265.750484 | 0.33963037 | 93000000
145441680 | 0.000060000 | 3286 | 5065 | 6037.550911 | -1.42185025 | 93000000
145441690 | 0.000080000 | 4236 | 6389 | 7665.703947 | -0.74355681 | 93000000
145441700 | 0.000100000 | 3303 | 4901 | 5910.127748 | -1.47493513 | 93000000
145441710 | 0.000120000 | 5605 | 8138 | 9881.450754 | 0.17952995 | 93000000
145441720 | 0.000140000 | 7205 | 10326 | 12591.199347 | 1.30841935 | 93000000
145441730 | 0.000160000 | 5896 | 8693 | 10503.859529 | 0.43882732 | 93000000
145441740 | 0.000180000 | 6857 | 9731 | 11904.234961 | 1.02222792 | 93000000
145441750 | 0.000200000 | 6473 | 9626 | 11599.982974 | 0.89547563 | 93000000
145441760 | 0.000220000 | 4966 | 7449 | 8952.583817 | -0.20743880 | 93000000
145441770 | 0.000240000 | 5640 | 8650 | 10326.282003 | 0.36484799 | 93000000
145441780 | 0.000260000 | 3338 | 4984 | 5998.541489 | -1.43810170 | 93000000
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
