arakawayao/digital-receiver/docs/project_history.md

# 历史 README 归档

归档日期：2026-10-28。以下保存整理前的根 README，包含本地已有的历史标记。
其中的“当前”、路径、器件候选和验证结果只代表各条目的记录时点，不作为现行配置。
正文内链接沿用当时相对根目录的写法；当前入口与状态以仓库根 README 为准。

# 简易数字接收机

本项目对应 2026 年秋季“工程教育（高级）”课程的简易数字接收机课题。目标是基于软件无线电架构，用 FPGA 完成信号采集、数字下变频和预处理后的数据传输，在上位机完成 AM/FM 识别、解调、实时放音及测量结果管理，并完成相关电路和结构设计。

## GitHub 源码交付入口（2026-10-28）

- 当前 FPGA 工程：[ADS807E 两模式工程](main_project/fpga/receiver_ads807_dual/README.md)，入口为 `receiver_ads807_dual.qpf`。
- 当前上位机：[独立上位机工程](main_project/host/README.md)，从其目录运行 `python -B -m ads807`。
- PCB 可编辑工程位于 `main_project/pcb/`；保留现有两份源工程，最终硬件基线需由设计者核对。
- 源码仓库排除本机缓存、编译数据库、发布程序、原始采集数据和大体积运行产物；保留 RTL、必要 IP 文件、约束、脚本、测试、接口文档及关键验证摘要。
- 部分旧源码仍被参考模型、回放或历史测试引用，因此保留必要依赖。交付范围、环境要求和已知历史缺项见 [源码交付说明](docs/source_delivery.md)。

下方进展与早期方案包含历史记录；与上述入口冲突的旧路径不作为当前启动入口。已有仿真或联调记录不代表完成系统验收。

设计应兼顾价格低廉和便于携带。需求来源为项目根目录的 `工程教育（高级）任务书（2026秋).doc`；本说明用于整理项目要求和开发入口，不替代原始任务书。

## 当前状态(历史记录)

2026-10-20 上位机工程已集中到 [host目录](host/README.md)：应用、共享Python协议、历史工具、
测试和默认产物均在目录内；从host执行 `python -B -m ads807`，可单独复制交付。
FPGA旧Python位置保留兼容转发，实际实现只维护在host，外层harness已更新测试与产物路径。

2026-10-20 当前新增独立 [ADS807E两模式工程](main_project/fpga/receiver_ads807_dual/README.md)，
直接复用 `receiver_ads807` 原工程采集/DSP，器件为用户确认的EP4CE6F17C8。
只保留FPGA自动估频（默认）和上位机手动载频；不包含主机快照搜索。
43.5MS/s采样、500kS/s I/Q；根目录桌面上位机已切换新工程协议模块。
补齐ADC12位/OTR/CLK物理引脚后Quartus map/fit/已约束路径多工况STA通过，6178/6272 LE、
169002/276480 RAM位，逻辑余量仅94 LE；ADC板级I/O时序仍待验证。
上位机78项回归与4种合成GUI场景通过；ADC12位、OTR和时钟已按用户P3接线顺序
配齐物理引脚，无ADC虚拟端口。已下载新工程SOF，ADC未接入时完成60秒USB控制测试：
440条命令ACK符合预期，无回传CRC错误或帧序号间断；未进行真实射频或持续数据吞吐验证。
当前验证与重建入口以新工程文档为准；下列三模式及ROM实板测试为历史独立流程。

2026-10-20 新增 [EP4CE6 三模式可视化实板测试](main_project/fpga/receiver_ads807/TRI_BOARD_TEST.md)：
自动搜索、FPGA 自主和手动模式分别配置，计划覆盖 AM/FM、800/80 码幅度及每组 30 秒接收。
自动/手动的 EP4CE6 构建、时序及引脚级仿真已通过；上位机页面已接入真实 USB 测试入口。
重新上电恢复后继续测试，已修复空 FIFO 触发提前封帧并增加可选异步 USB 接收。
一轮矩阵 11/12 组各 30 秒通过，末组因上位机队列溢出失败；调整测量/FFT 更新率后，
手动 FM/80 完成 60 秒零异常复测。最新矩阵自动 AM/800、FM/800 各 60 秒通过，
第三组烧录前数据 USB 再次无法枚举，已立即停测等待重新上电；长期稳定性尚未确认。

2026-10-19 用户确认测试板 FPGA 为 **EP4CE6F17C8**，ADC 尚未焊好，先进行内部 RAM
回放的 USB→FPGA DSP→USB 测试。新增独立 [43.5 MHz 回放工程与操作说明](main_project/fpga/receiver_ads807/USB_REPLAY.md)，
复用 ADS807 单模式 DSP，输出 FCR1 v2，可由现有桌面上位机文件回放分析。
三模式工程此前占用 7535 LE，超过 EP4CE6 的 6272 LE，不能直接用于本板；
下列 EP4CE10 工程目标不再视为已确认实物型号。已通过USB-Blaster下载新SOF，
AM/FM实板每轮512帧、57344对I/Q、CRC和丢样均为0；重新上电后FM→AM→FM连续三轮通过。
此前曾有首条STOP等待ACK超时，重新下载SOF未恢复，重新上电后恢复，根因仍待查。
构建/仿真与实际USB结果分别记录，短时采集不代表长期稳定性验收。
该回放工程 AM/FM 引脚级仿真、9项软件检查、EP4CE6 完整编译及已约束时序已通过，
具体证据与未通过的技能样式门禁见 [回放验证记录](main_project/fpga/receiver_ads807/REPLAY_VALIDATION.md)。

2026-10-18 本轮工作入口为 [ADS807E 三模式 FPGA 工程](main_project/fpga/receiver_ads807_tri/README.md)
与根目录 [PyQt6 上位机](host/ads807/README.md)。采样率 43.5 MS/s，I/Q 500 kS/s；
支持上位机快照自动搜索、原 FPGA 自主估频和手动载频三种模式，使用 TCM1/TRI1 双向协议。
现有桌面工作台已适配并保留识别、解调、音频和记录功能；旧 FCR1 文件可回放。
新工程 ADC 引脚仍为虚拟，FPGA 目标器件和新 ADC 板级时序待实物核对；
离线仿真、软件回归和已有 FPGA 构建记录不代表真实 USB、射频或端到端系统验收通过。
以下 56 MHz 工程及更早方案为历史记录，不作为 ADS807E 新工程的配置依据。

2026-10-04用户最新更正已优先应用于FPGA：**ADC固定56MHz，由FPGA PLL提供；
FPGA自主估计载波并设置DDC，上位机不下发调频配置，接收I/Q后仍识别AM/FM、
解调和放音。** 当前工程为`main_project/fpga/receiver/receiver56.qpf`，说明及最新
验证见[FPGA当前工程](main_project/fpga/receiver/README.md)。旧32/40MHz及上位机
RCF1调频方案移入`receiver/legacy_32_40/`，下文旧采样方案属于历史记录。
自主检测器和56MHz模块ModelSim已通过；Quartus56综合/布局布线/已约束路径多角
时序通过；自动ADC→USB全链路68完整帧的载荷/CRC及恢复检查通过。ADC完整料号/接线与上板仍未确认，
旧AD9235-40记录不能直接作为56MHz硬件定案。新增56MHz验证任务已注册至harness。
旧adc-capture-tests/ddc-mixer-tests因依赖已退役源码，已从当前harness任务清单退出；
历史记录保留，其验证职责由receiver56-module-tests及自主全链路任务承担。

用户补充的实时要求为锁定后持续处理、USB正常接收时不丢样；新增
`receiver56-realtime-tests`逐拍检查ADC、混频、抽取和正常USB连续性。
实际连续6ms正常接收仿真：335990个ADC时钟全部采集/混频，26完整帧载荷/CRC一致，零丢样。
此前全链故障测试的预期丢样不能作为无丢样通过。2231μs波形是首次未锁定时的
复位零值；实际混频乘积和频谱独立复核通过，对照图及结果见当前FPGA验证记录。

2026-10-04 已核读任务书、实际源码/配置和主要板卡资料，结论见
[项目方案与文件审阅](docs/project_review_2026-10-04.md)。新增
`python -B -m harness.dialog` 验证对话框，支持任务选择、依赖、后台执行、取消、
日志及历史摘要。本次完整 harness 为 5 项通过、2 项因仿真器不在 PATH 而失败；
整机仍未完成。实际 PLL 文件已为 24 MHz ×5/÷3 / 40 MHz，根目录最新 EDA ADC
页放置 AD9235BRUZRL7-40；均未实测。现有核心板 FX2 是 USB 2.0，与 USB 3.0
设计目标有差距。固定 40 MS/s 在 100 MHz 仍有折叠边界，双档采样模型待验证。
本次审阅优先于下列历史记录，保留候选器件与硬件验证的未定状态。

以下为 2026-09-29 及之前的历史进展，其中 10 MHz PLL 描述已被上述源文件核对更正。

2026-09-29 DDC 增量：参考时钟确定为 24 MHz，计划 ADC 采样率为 10 MS/s；
现有 `adc_clk_gen` PLL 配置为 ×5/÷12。新增 `ddc_mixer`（32 位 NCO、12 位输入、
24 位 I/Q 乘积），通过独立 RTL 数值及时序仿真，入口为 harness 的 `ddc-mixer-tests`。
采集和混频计划共用 10 MHz 捕获域，低通/抽取与顶层集成未完成。固定 10 MS/s 在
90、95、100、105 MHz 有折叠边界，完整信号频带需避开并留保护带；全频段可恢复性尚未解决。

项目已有离线 harness、IQ 数据契约和确定性 AM/FM/静默样本。2026-09-29 新增 `main_project/fpga/srcs/adc_capture.v`，完成并行采集及码型转换的独立 RTL 仿真，接口与运行入口见 [FPGA 模块说明](main_project/fpga/README.md)。当前 Quartus 工程配置为 Cyclone IV E EP4CE6F17C8，与早期 Artix 候选不同；完整接收机、时钟/引脚约束和系统联调尚未完成。已确定 SMA 单信号带通采样及 USB 3.0，12 位 ADC 保留 AD9235 和 ADC12020CIVYX/NOPB 两款候选，最终硬件配套仍待确认。

当前方案见 [工程设计说明 v0.3](docs/engineering_design_v0.1.md)（沿用原文件路径），覆盖 PCB、FPGA、USB 与上位机。AD9235 的速率等级为 20/40/65 MSPS，具体等级和封装待定；ADC12020CIVYX/NOPB 最高 20 MS/s。两者的实际时钟、输入动态性能、码型/接口和采购成本需分别评估。ADC12020 标称模拟带宽为 100 MHz，AD9235 为 500 MHz；均不能用标称带宽代替 108 MHz 动态性能验证。

2026-09-27 已确认单信号射频带通采样，按最新更正撤回 ADC12020 单一选型，两款 ADC 并列比较。实际采样率按候选完整料号校验：24/25 MS/s 不适用于 ADC12020 或 AD9235-20，对 AD9235-40/-65 也须通过时钟和采样条件论证。[10.7 MHz 模拟中频设计说明 v0.1](docs/engineering_design_if10_7_v0.1.md) 保留为未采用的历史备选。

早期记录中的 `test.py` 是尚不完整的 PyTorch 脚本，与本课题关系未确认；2026-10-04
目录索引未发现该文件。不能据旧记录引入 PyTorch 或将其作为接收机入口。

编写本说明时，当前目录尚未初始化为 Git 仓库。

## 任务要求与验收方向

下表“任务书要求”为原文内容的整理，“后续验证方向”为项目建议，具体指标与验收条件仍需细化。

| 项目 | 任务书要求 | 后续验证方向 |
| --- | --- | --- |
| 接收频段 | 信号载频输入频率范围 88 MHz 至 108 MHz | 覆盖频段端点及代表性频点，检查采集和调谐结果 |
| FPGA 处理 | 信号采集、数字下变频及预处理后的数据传输 | 检查采样、频率搬移、滤波/抽取及传输连续性 |
| 调制处理 | 上位机支持 AM、FM 等类型的识别和解调，实时放音 | 输入已知 AM/FM 信号，核对识别结果并验证持续音频输出 |
| 参数测量 | 测量信号中心频率、AM/FM 调制方式等参数 | 与信号源设定值或可靠参考结果比较 |
| 结果管理 | 便于查找与分类 | 验证测量记录的保存、检索和分类 |
| 工程设计 | 按规范设计 3D 打印、电路原理图、PCB | 核对源工程、规则检查、制造输出与样机装配 |
| 设计取向 | 价格低廉、便于携带 | 结合 BOM、样机尺寸、供电和装配情况说明 |

扩展功能可自由发挥，任务书说明将根据复杂和难易程度评分。基本功能优先，扩展范围应另行明确。

## 系统职责

当前设计方向及功能分工如下，器件和具体实现参数待定：

```text
SMA 输入单个 88 MHz 至 108 MHz AM/FM 信号
    -> 射频预选滤波/驱动 -> AD9235 或 ADC12020（带通采样，不设模拟混频）
    -> FPGA：并行采集 -> 别名频率数字下变频 -> 滤波/抽取、方向校正 -> 帧封装
    -> USB 3.0 桥接与数据传输
    -> 上位机：AM/FM 识别与解调 -> 实时音频输出
              中心频率等参数测量 -> 测量结果管理
```

当前不要求同时接收整个 20 MHz 频段。带通采样需让单个信号的完整边带避开折叠边界；固定 20 MS/s 对 100 MHz 中心信号存在边带重叠，不能作为全范围通用配置。未知 RF 中心频率还需多采样率或其他信息消歧，单次 FFT 的别名频率不是唯一 RF 测量结果。19/20 MS/s 仅为模型档位示例，前端、时钟和性能均需验证。

## 当前目录

```text
class_project/
    工程教育（高级）任务书（2026秋).doc   原始任务书
    AGENTS.md                              项目工作规范
    README.md                              项目说明
    harness/                               DAG 命令调度器、验证清单与 Tkinter 对话框
    reference/                             离线 IQ 契约与合成信号样本
    tests/                                 Harness、契约和信号样本测试
    docs/                                  工作包拆解和接口说明
    .gitignore                             本地运行产物忽略规则
    main_project/fpga/                     现有 Quartus、采集/混频 RTL 和 PLL
    main_project/circuit/                  ADS 工程骨架
    main_project/pcb/                      早期 EDA 工程
    ProPrj_*.epro2                         根目录较新 EDA 设计实例
    ETree_FCore2S_Board/                   板卡资料、USB2.0 示例与工具
    .vscode/                               编辑器配置
```

后续按工作包建立 `host/`、`hardware/` 和 `mechanical/`；现有 FPGA 源文件保留在
`main_project/fpga/`，新增模块先明确独占文件归属。规划目录不代表已实现。

## 待确认事项

- 课程正式工程规范及报告、源工程、制造文件和样机的提交要求。
- AD9235（等级/封装待定）与 ADC12020CIVYX/NOPB 的最终选型、报价、各自驱动/供电/码型/接口，以及 FPGA、前端、设备和预算。
- SMA 单个 AM/FM 信号的来源、输入电平、调制参数、有效带宽，以及 RF 中心频率先验/自动消歧要求。
- 两款候选在 88–108 MHz 的实际幅频和动态性能，尤其 ADC12020 超过标称 100 MHz 模拟带宽的端点；按速率等级确定时钟档位及容差。
- 采样率、抽取配置、定点位宽、USB 3.0 桥接接口、应用帧协议及实测吞吐预算。
- 中心频率测量精度、调制识别评价条件、音频质量、实时延迟与连续运行时长等验收指标。
- 上位机运行平台、技术栈、音频输出方式和记录存储方式。
- PCB 制造约束、外壳尺寸、打印与装配条件，以及开发工具版本。

任务书未给出这些具体数值或选型，不应将假定方案作为已确认要求。

## 开发与运行

目前没有可直接运行的接收机应用。离线 harness 使用 Python 3.11 或更新版本，仅依赖标准库，无需安装 PyTorch。不要以运行 `test.py` 作为项目功能验收。

在项目根目录执行：

```powershell
python -B -m harness.runner list
python -B -m harness.dialog
python -B -m harness.runner run --jobs 3
python -B -m harness.runner run --jobs 2 --task generate-fixtures
```

`--task` 可重复指定，自动包含所需依赖。运行器执行任务清单中的本地命令，不会启动新的 AI 会话。无前置依赖的检查可并行运行，样本生成等待 IQ 契约和信号测试成功；失败会阻止依赖任务，同时保留无关任务的执行结果。

日志和每次运行的 `summary.json` 保存至 `.harness/runs/` 下的独立目录，合成数据保存至 `.harness/fixtures/`。退出码 0 表示所选任务全部通过，1 表示运行失败或被依赖阻塞，2 表示参数或配置错误，130 表示用户中断。文件归属声明用于提前检查写入冲突，不是安全沙箱。

每个项目同时允许一个 harness 运行，由该运行内部的 `--jobs` 控制并发，避免两个调度器同时覆盖共享样本。`--output-dir` 只能指向项目 `.harness/` 下的子目录。异常断电或强制结束调度器可能留下 `.harness/run.lock`；先确认旧调度器及其子进程均已结束，再删除空锁目录恢复运行，不要在运行期间清锁。

并行工作包及交付门槛见 `docs/work_plan.md`，IQ 格式和测试参数见 `docs/iq_contract.md`。离线 JSON 格式只是模块协作基线，不是已确定的 FPGA 硬件传输协议。

后续 harness 工作先读取工程设计说明第 10 节，按两款候选及速率等级配置采样上限、实际时钟和码型，补充带通采样、折叠边界、RF 消歧、方向校正及 12 bit 转换测试。上述检查尚未实现或注册，本次文档更新不改变已有 harness 和离线 IQ 契约。

建立实际工程时，应在对应目录说明工具版本、依赖、入口、构建或仿真步骤、测试数据和结果位置，并同步更新本节。开发前阅读 `AGENTS.md`，遵循全局及项目级规范。

项目推进流程：

1. 补齐课程规范和验收指标，完成器件与采样方案论证。
2. 定义采样率、数据格式、处理链路和传输协议，建立 AM/FM 算法参考模型。
3. 实现并验证 FPGA 采集、数字下变频、预处理和传输模块。
4. 实现上位机接收、识别、解调、放音和测量记录管理。
5. 完成电路、PCB 与结构设计，开展硬件联调、系统验收和报告整理。

以上是后续工作顺序建议，不表示相关功能已实现；硬件与算法工作可在接口明确后并行开展。

## 团队分工

任务书要求团队人数为 5 人，参考分工如下，实际人员尚未指定。

| 工作 | 人数 |
| --- | --- |
| 硬件电路设计制作 | 1 |
| FPGA 软件编程 | 2 |
| 计算机软件编程 | 1 |
| 报告及系统集成样机制作 | 1 |

## 验证与交付记录

当前验证范围包括调度器、验证对话框后端、离线 IQ 和合成样本；采集/混频已有历史
独立 RTL 仿真记录，本次因 PATH 缺仿真器未能重验。每次结果以日志和 `summary.json`
为准。生产解调算法、综合实现时序、硬件测量、实时音频和系统验收尚未完成。

后续验证应记录配置、输入信号、操作步骤、预期与实际结果，并保留必要的日志、波形、测量记录和音频证据。仿真通过、时序通过和实物实时放音应分别说明。

预期需形成 FPGA 与上位机源工程、原理图与 PCB 源工程、3D 打印设计、系统测试记录及课程报告；具体交付格式和清单以补充取得的课程正式规范为准。
