arakawayao/digital-receiver/main_project/fpga/receiver/legacy_32_40/HISTORY.md

# 已退役的32/40MHz与上位机调频方案

本目录仅保存历史入口和说明，不能直接作为当前工程构建。
2026-10-04用户明确ADC固定56MHz由FPGA PLL提供，且频率识别/DDC配置由FPGA自主完成。
旧RCF1/EP6调谐路径与32/40档均被取代。当前工程入口是上级receiver56.qpf；
当前测试、构建和已完成状态以上级README.md、VALIDATION.md为准。
本目录历史README/VALIDATION中的“通过”不表示56MHz自主接收机已通过。
