arakawayao/digital-receiver/main_project/fpga/receiver/ip/rx_fifo.v

//dcfifo_mixed_widths CBX_SINGLE_OUTPUT_FILE="ON" DEVICE_FAMILY="Cyclone IV E" LPM_NUMWORDS=512 LPM_SHOWAHEAD="ON" LPM_WIDTH=97 LPM_WIDTH_R=97 LPM_WIDTHU=9 LPM_WIDTHU_R=9 OVERFLOW_CHECKING="ON" RDSYNC_DELAYPIPE=4 READ_ACLR_SYNCH="ON" UNDERFLOW_CHECKING="ON" USE_EAB="ON" WRITE_ACLR_SYNCH="ON" WRSYNC_DELAYPIPE=4 aclr data q rdclk rdempty rdreq wrclk wrfull wrreq ALTERA_INTERNAL_OPTIONS=AUTO_SHIFT_REGISTER_RECOGNITION=OFF
//VERSION_BEGIN 18.1 cbx_a_gray2bin 2018:09:12:13:04:24:SJ cbx_a_graycounter 2018:09:12:13:04:24:SJ cbx_altdpram 2018:09:12:13:04:24:SJ cbx_altera_counter 2018:09:12:13:04:24:SJ cbx_altera_gray_counter 2018:09:12:13:04:24:SJ cbx_altera_syncram 2018:09:12:13:04:24:SJ cbx_altera_syncram_nd_impl 2018:09:12:13:04:24:SJ cbx_altsyncram 2018:09:12:13:04:24:SJ cbx_cycloneii 2018:09:12:13:04:24:SJ cbx_dcfifo 2018:09:12:13:04:24:SJ cbx_fifo_common 2018:09:12:13:04:24:SJ cbx_lpm_add_sub 2018:09:12:13:04:24:SJ cbx_lpm_compare 2018:09:12:13:04:24:SJ cbx_lpm_counter 2018:09:12:13:04:24:SJ cbx_lpm_decode 2018:09:12:13:04:24:SJ cbx_lpm_mux 2018:09:12:13:04:24:SJ cbx_mgl 2018:09:12:13:10:36:SJ cbx_nadder 2018:09:12:13:04:24:SJ cbx_scfifo 2018:09:12:13:04:24:SJ cbx_stratix 2018:09:12:13:04:24:SJ cbx_stratixii 2018:09:12:13:04:24:SJ cbx_stratixiii 2018:09:12:13:04:24:SJ cbx_stratixv 2018:09:12:13:04:24:SJ cbx_util_mgl 2018:09:12:13:04:24:SJ  VERSION_END
// synthesis VERILOG_INPUT_VERSION VERILOG_2001
// altera message_off 10463



// Copyright (C) 2018  Intel Corporation. All rights reserved.
//  Your use of Intel Corporation's design tools, logic functions 
//  and other software and tools, and its AMPP partner logic 
//  functions, and any output files from any of the foregoing 
//  (including device programming or simulation files), and any 
//  associated documentation or information are expressly subject 
//  to the terms and conditions of the Intel Program License 
//  Subscription Agreement, the Intel Quartus Prime License Agreement,
//  the Intel FPGA IP License Agreement, or other applicable license
//  agreement, including, without limitation, that your use is for
//  the sole purpose of programming logic devices manufactured by
//  Intel and sold by Intel or its authorized distributors.  Please
//  refer to the applicable agreement for further details.




//a_graycounter CBX_SINGLE_OUTPUT_FILE="ON" DEVICE_FAMILY="Cyclone IV E" PVALUE=1 WIDTH=10 aclr clock cnt_en q
//VERSION_BEGIN 18.1 cbx_a_gray2bin 2018:09:12:13:04:24:SJ cbx_a_graycounter 2018:09:12:13:04:24:SJ cbx_cycloneii 2018:09:12:13:04:24:SJ cbx_mgl 2018:09:12:13:10:36:SJ cbx_stratix 2018:09:12:13:04:24:SJ cbx_stratixii 2018:09:12:13:04:24:SJ  VERSION_END

//synthesis_resources = reg 14 
//synopsys translate_off
`timescale 1 ps / 1 ps
//synopsys translate_on
(* ALTERA_ATTRIBUTE = {"{-to counter5a[0]} POWER_UP_LEVEL=HIGH"} *)
module  rx_fifo_a_graycounter_gs9
	( 
	aclr,
	clock,
	cnt_en,
	q) /* synthesis synthesis_clearbox=1 */;
	input   aclr;
	input   clock;
	input   cnt_en;
	output   [9:0]  q;
`ifndef ALTERA_RESERVED_QIS
// synopsys translate_off
`endif
	tri0   aclr;
	tri1   cnt_en;
`ifndef ALTERA_RESERVED_QIS
// synopsys translate_on
`endif

	reg	[9:0]	counter5a;
	(* ALTERA_ATTRIBUTE = {"POWER_UP_LEVEL=HIGH"} *)
	reg	parity6;
	reg	[2:0]	sub_parity7a;
	wire  [9:0]  cntr_cout;
	wire  parity_cout;
	wire sclr;
	wire updown;

	// synopsys translate_off
	initial
		counter5a[0:0] = {1{1'b1}};
	// synopsys translate_on
	always @ ( posedge clock or  posedge aclr)
		if (aclr == 1'b1) counter5a[0:0] <= {1{1'b1}};
		else
			if (sclr == 1'b1) counter5a[0:0] <= 1'b0;
			else  counter5a[0:0] <= ((cnt_en & (counter5a[0:0] ^ (~ parity_cout))) | ((~ cnt_en) & counter5a[0:0]));
	// synopsys translate_off
	initial
		counter5a[1:1] = 0;
	// synopsys translate_on
	always @ ( posedge clock or  posedge aclr)
		if (aclr == 1'b1) counter5a[1:1] <= 1'b0;
		else
			if (sclr == 1'b1) counter5a[1:1] <= 1'b0;
			else  counter5a[1:1] <= (counter5a[1:1] ^ (counter5a[0:0] & cntr_cout[0]));
	// synopsys translate_off
	initial
		counter5a[2:2] = 0;
	// synopsys translate_on
	always @ ( posedge clock or  posedge aclr)
		if (aclr == 1'b1) counter5a[2:2] <= 1'b0;
		else
			if (sclr == 1'b1) counter5a[2:2] <= 1'b0;
			else  counter5a[2:2] <= (counter5a[2:2] ^ (counter5a[1:1] & cntr_cout[1]));
	// synopsys translate_off
	initial
		counter5a[3:3] = 0;
	// synopsys translate_on
	always @ ( posedge clock or  posedge aclr)
		if (aclr == 1'b1) counter5a[3:3] <= 1'b0;
		else
			if (sclr == 1'b1) counter5a[3:3] <= 1'b0;
			else  counter5a[3:3] <= (counter5a[3:3] ^ (counter5a[2:2] & cntr_cout[2]));
	// synopsys translate_off
	initial
		counter5a[4:4] = 0;
	// synopsys translate_on
	always @ ( posedge clock or  posedge aclr)
		if (aclr == 1'b1) counter5a[4:4] <= 1'b0;
		else
			if (sclr == 1'b1) counter5a[4:4] <= 1'b0;
			else  counter5a[4:4] <= (counter5a[4:4] ^ (counter5a[3:3] & cntr_cout[3]));
	// synopsys translate_off
	initial
		counter5a[5:5] = 0;
	// synopsys translate_on
	always @ ( posedge clock or  posedge aclr)
		if (aclr == 1'b1) counter5a[5:5] <= 1'b0;
		else
			if (sclr == 1'b1) counter5a[5:5] <= 1'b0;
			else  counter5a[5:5] <= (counter5a[5:5] ^ (counter5a[4:4] & cntr_cout[4]));
	// synopsys translate_off
	initial
		counter5a[6:6] = 0;
	// synopsys translate_on
	always @ ( posedge clock or  posedge aclr)
		if (aclr == 1'b1) counter5a[6:6] <= 1'b0;
		else
			if (sclr == 1'b1) counter5a[6:6] <= 1'b0;
			else  counter5a[6:6] <= (counter5a[6:6] ^ (counter5a[5:5] & cntr_cout[5]));
	// synopsys translate_off
	initial
		counter5a[7:7] = 0;
	// synopsys translate_on
	always @ ( posedge clock or  posedge aclr)
		if (aclr == 1'b1) counter5a[7:7] <= 1'b0;
		else
			if (sclr == 1'b1) counter5a[7:7] <= 1'b0;
			else  counter5a[7:7] <= (counter5a[7:7] ^ (counter5a[6:6] & cntr_cout[6]));
	// synopsys translate_off
	initial
		counter5a[8:8] = 0;
	// synopsys translate_on
	always @ ( posedge clock or  posedge aclr)
		if (aclr == 1'b1) counter5a[8:8] <= 1'b0;
		else
			if (sclr == 1'b1) counter5a[8:8] <= 1'b0;
			else  counter5a[8:8] <= (counter5a[8:8] ^ (counter5a[7:7] & cntr_cout[7]));
	// synopsys translate_off
	initial
		counter5a[9:9] = 0;
	// synopsys translate_on
	always @ ( posedge clock or  posedge aclr)
		if (aclr == 1'b1) counter5a[9:9] <= 1'b0;
		else
			if (sclr == 1'b1) counter5a[9:9] <= 1'b0;
			else  counter5a[9:9] <= (counter5a[9:9] ^ cntr_cout[8]);
	// synopsys translate_off
	initial
		parity6 = {1{1'b1}};
	// synopsys translate_on
	always @ ( posedge clock or  posedge aclr)
		if (aclr == 1'b1) parity6 <= {1{1'b1}};
		else
			if (sclr == 1'b1) parity6 <= 1'b0;
			else  parity6 <= ((cnt_en & ((sub_parity7a[0] ^ sub_parity7a[1]) ^ sub_parity7a[2])) | ((~ cnt_en) & parity6));
	// synopsys translate_off
	initial
		sub_parity7a[0:0] = 0;
	// synopsys translate_on
	always @ ( posedge clock or  posedge aclr)
		if (aclr == 1'b1) sub_parity7a[0:0] <= 1'b0;
		else
			if (sclr == 1'b1) sub_parity7a[0:0] <= 1'b0;
			else  sub_parity7a[0:0] <= ((cnt_en & (((counter5a[0] ^ counter5a[1]) ^ counter5a[2]) ^ counter5a[3])) | ((~ cnt_en) & sub_parity7a[0:0]));
	// synopsys translate_off
	initial
		sub_parity7a[1:1] = 0;
	// synopsys translate_on
	always @ ( posedge clock or  posedge aclr)
		if (aclr == 1'b1) sub_parity7a[1:1] <= 1'b0;
		else
			if (sclr == 1'b1) sub_parity7a[1:1] <= 1'b0;
			else  sub_parity7a[1:1] <= ((cnt_en & (((counter5a[4] ^ counter5a[5]) ^ counter5a[6]) ^ counter5a[7])) | ((~ cnt_en) & sub_parity7a[1:1]));
	// synopsys translate_off
	initial
		sub_parity7a[2:2] = 0;
	// synopsys translate_on
	always @ ( posedge clock or  posedge aclr)
		if (aclr == 1'b1) sub_parity7a[2:2] <= 1'b0;
		else
			if (sclr == 1'b1) sub_parity7a[2:2] <= 1'b0;
			else  sub_parity7a[2:2] <= ((cnt_en & (counter5a[8] ^ counter5a[9])) | ((~ cnt_en) & sub_parity7a[2:2]));
	assign
		cntr_cout = {1'b0, (cntr_cout[7] & (~ counter5a[7:7])), (cntr_cout[6] & (~ counter5a[6:6])), (cntr_cout[5] & (~ counter5a[5:5])), (cntr_cout[4] & (~ counter5a[4:4])), (cntr_cout[3] & (~ counter5a[3:3])), (cntr_cout[2] & (~ counter5a[2:2])), (cntr_cout[1] & (~ counter5a[1:1])), (cntr_cout[0] & (~ counter5a[0:0])), (cnt_en & parity_cout)},
		parity_cout = (((~ parity6) ^ updown) & cnt_en),
		q = counter5a,
		sclr = 1'b0,
		updown = 1'b1;
endmodule //rx_fifo_a_graycounter_gs9


//a_graycounter CBX_SINGLE_OUTPUT_FILE="ON" DEVICE_FAMILY="Cyclone IV E" PVALUE=1 WIDTH=10 aclr clock cnt_en q ALTERA_INTERNAL_OPTIONS=suppress_da_rule_internal=S102
//VERSION_BEGIN 18.1 cbx_a_gray2bin 2018:09:12:13:04:24:SJ cbx_a_graycounter 2018:09:12:13:04:24:SJ cbx_cycloneii 2018:09:12:13:04:24:SJ cbx_mgl 2018:09:12:13:10:36:SJ cbx_stratix 2018:09:12:13:04:24:SJ cbx_stratixii 2018:09:12:13:04:24:SJ  VERSION_END

//synthesis_resources = reg 14 
//synopsys translate_off
`timescale 1 ps / 1 ps
//synopsys translate_on
(* ALTERA_ATTRIBUTE = {"suppress_da_rule_internal=S102;{-to counter8a[0]} POWER_UP_LEVEL=HIGH"} *)
module  rx_fifo_a_graycounter_caf
	( 
	aclr,
	clock,
	cnt_en,
	q) /* synthesis synthesis_clearbox=1 */;
	input   aclr;
	input   clock;
	input   cnt_en;
	output   [9:0]  q;
`ifndef ALTERA_RESERVED_QIS
// synopsys translate_off
`endif
	tri0   aclr;
	tri1   cnt_en;
`ifndef ALTERA_RESERVED_QIS
// synopsys translate_on
`endif

	reg	[9:0]	counter8a;
	(* ALTERA_ATTRIBUTE = {"POWER_UP_LEVEL=HIGH"} *)
	reg	parity9;
	reg	[2:0]	sub_parity10a;
	wire  [9:0]  cntr_cout;
	wire  parity_cout;
	wire sclr;
	wire updown;

	// synopsys translate_off
	initial
		counter8a[0:0] = {1{1'b1}};
	// synopsys translate_on
	always @ ( posedge clock or  posedge aclr)
		if (aclr == 1'b1) counter8a[0:0] <= {1{1'b1}};
		else
			if (sclr == 1'b1) counter8a[0:0] <= 1'b0;
			else  counter8a[0:0] <= ((cnt_en & (counter8a[0:0] ^ (~ parity_cout))) | ((~ cnt_en) & counter8a[0:0]));
	// synopsys translate_off
	initial
		counter8a[1:1] = 0;
	// synopsys translate_on
	always @ ( posedge clock or  posedge aclr)
		if (aclr == 1'b1) counter8a[1:1] <= 1'b0;
		else
			if (sclr == 1'b1) counter8a[1:1] <= 1'b0;
			else  counter8a[1:1] <= (counter8a[1:1] ^ (counter8a[0:0] & cntr_cout[0]));
	// synopsys translate_off
	initial
		counter8a[2:2] = 0;
	// synopsys translate_on
	always @ ( posedge clock or  posedge aclr)
		if (aclr == 1'b1) counter8a[2:2] <= 1'b0;
		else
			if (sclr == 1'b1) counter8a[2:2] <= 1'b0;
			else  counter8a[2:2] <= (counter8a[2:2] ^ (counter8a[1:1] & cntr_cout[1]));
	// synopsys translate_off
	initial
		counter8a[3:3] = 0;
	// synopsys translate_on
	always @ ( posedge clock or  posedge aclr)
		if (aclr == 1'b1) counter8a[3:3] <= 1'b0;
		else
			if (sclr == 1'b1) counter8a[3:3] <= 1'b0;
			else  counter8a[3:3] <= (counter8a[3:3] ^ (counter8a[2:2] & cntr_cout[2]));
	// synopsys translate_off
	initial
		counter8a[4:4] = 0;
	// synopsys translate_on
	always @ ( posedge clock or  posedge aclr)
		if (aclr == 1'b1) counter8a[4:4] <= 1'b0;
		else
			if (sclr == 1'b1) counter8a[4:4] <= 1'b0;
			else  counter8a[4:4] <= (counter8a[4:4] ^ (counter8a[3:3] & cntr_cout[3]));
	// synopsys translate_off
	initial
		counter8a[5:5] = 0;
	// synopsys translate_on
	always @ ( posedge clock or  posedge aclr)
		if (aclr == 1'b1) counter8a[5:5] <= 1'b0;
		else
			if (sclr == 1'b1) counter8a[5:5] <= 1'b0;
			else  counter8a[5:5] <= (counter8a[5:5] ^ (counter8a[4:4] & cntr_cout[4]));
	// synopsys translate_off
	initial
		counter8a[6:6] = 0;
	// synopsys translate_on
	always @ ( posedge clock or  posedge aclr)
		if (aclr == 1'b1) counter8a[6:6] <= 1'b0;
		else
			if (sclr == 1'b1) counter8a[6:6] <= 1'b0;
			else  counter8a[6:6] <= (counter8a[6:6] ^ (counter8a[5:5] & cntr_cout[5]));
	// synopsys translate_off
	initial
		counter8a[7:7] = 0;
	// synopsys translate_on
	always @ ( posedge clock or  posedge aclr)
		if (aclr == 1'b1) counter8a[7:7] <= 1'b0;
		else
			if (sclr == 1'b1) counter8a[7:7] <= 1'b0;
			else  counter8a[7:7] <= (counter8a[7:7] ^ (counter8a[6:6] & cntr_cout[6]));
	// synopsys translate_off
	initial
		counter8a[8:8] = 0;
	// synopsys translate_on
	always @ ( posedge clock or  posedge aclr)
		if (aclr == 1'b1) counter8a[8:8] <= 1'b0;
		else
			if (sclr == 1'b1) counter8a[8:8] <= 1'b0;
			else  counter8a[8:8] <= (counter8a[8:8] ^ (counter8a[7:7] & cntr_cout[7]));
	// synopsys translate_off
	initial
		counter8a[9:9] = 0;
	// synopsys translate_on
	always @ ( posedge clock or  posedge aclr)
		if (aclr == 1'b1) counter8a[9:9] <= 1'b0;
		else
			if (sclr == 1'b1) counter8a[9:9] <= 1'b0;
			else  counter8a[9:9] <= (counter8a[9:9] ^ cntr_cout[8]);
	// synopsys translate_off
	initial
		parity9 = {1{1'b1}};
	// synopsys translate_on
	always @ ( posedge clock or  posedge aclr)
		if (aclr == 1'b1) parity9 <= {1{1'b1}};
		else
			if (sclr == 1'b1) parity9 <= 1'b0;
			else  parity9 <= ((cnt_en & ((sub_parity10a[0] ^ sub_parity10a[1]) ^ sub_parity10a[2])) | ((~ cnt_en) & parity9));
	// synopsys translate_off
	initial
		sub_parity10a[0:0] = 0;
	// synopsys translate_on
	always @ ( posedge clock or  posedge aclr)
		if (aclr == 1'b1) sub_parity10a[0:0] <= 1'b0;
		else
			if (sclr == 1'b1) sub_parity10a[0:0] <= 1'b0;
			else  sub_parity10a[0:0] <= ((cnt_en & (((counter8a[0] ^ counter8a[1]) ^ counter8a[2]) ^ counter8a[3])) | ((~ cnt_en) & sub_parity10a[0:0]));
	// synopsys translate_off
	initial
		sub_parity10a[1:1] = 0;
	// synopsys translate_on
	always @ ( posedge clock or  posedge aclr)
		if (aclr == 1'b1) sub_parity10a[1:1] <= 1'b0;
		else
			if (sclr == 1'b1) sub_parity10a[1:1] <= 1'b0;
			else  sub_parity10a[1:1] <= ((cnt_en & (((counter8a[4] ^ counter8a[5]) ^ counter8a[6]) ^ counter8a[7])) | ((~ cnt_en) & sub_parity10a[1:1]));
	// synopsys translate_off
	initial
		sub_parity10a[2:2] = 0;
	// synopsys translate_on
	always @ ( posedge clock or  posedge aclr)
		if (aclr == 1'b1) sub_parity10a[2:2] <= 1'b0;
		else
			if (sclr == 1'b1) sub_parity10a[2:2] <= 1'b0;
			else  sub_parity10a[2:2] <= ((cnt_en & (counter8a[8] ^ counter8a[9])) | ((~ cnt_en) & sub_parity10a[2:2]));
	assign
		cntr_cout = {1'b0, (cntr_cout[7] & (~ counter8a[7:7])), (cntr_cout[6] & (~ counter8a[6:6])), (cntr_cout[5] & (~ counter8a[5:5])), (cntr_cout[4] & (~ counter8a[4:4])), (cntr_cout[3] & (~ counter8a[3:3])), (cntr_cout[2] & (~ counter8a[2:2])), (cntr_cout[1] & (~ counter8a[1:1])), (cntr_cout[0] & (~ counter8a[0:0])), (cnt_en & parity_cout)},
		parity_cout = (((~ parity9) ^ updown) & cnt_en),
		q = counter8a,
		sclr = 1'b0,
		updown = 1'b1;
endmodule //rx_fifo_a_graycounter_caf


//altsyncram ADDRESS_ACLR_B="CLEAR1" ADDRESS_REG_B="CLOCK1" CBX_SINGLE_OUTPUT_FILE="ON" CLOCK_ENABLE_INPUT_B="BYPASS" DEVICE_FAMILY="Cyclone IV E" ENABLE_ECC="FALSE" OPERATION_MODE="DUAL_PORT" OUTDATA_REG_B="UNREGISTERED" WIDTH_A=97 WIDTH_B=97 WIDTH_BYTEENA_A=1 WIDTH_ECCSTATUS=2 WIDTHAD_A=9 WIDTHAD_B=9 aclr1 address_a address_b addressstall_b clock0 clock1 data_a q_b wren_a
//VERSION_BEGIN 18.1 cbx_altera_syncram_nd_impl 2018:09:12:13:04:24:SJ cbx_altsyncram 2018:09:12:13:04:24:SJ cbx_cycloneii 2018:09:12:13:04:24:SJ cbx_lpm_add_sub 2018:09:12:13:04:24:SJ cbx_lpm_compare 2018:09:12:13:04:24:SJ cbx_lpm_decode 2018:09:12:13:04:24:SJ cbx_lpm_mux 2018:09:12:13:04:24:SJ cbx_mgl 2018:09:12:13:10:36:SJ cbx_nadder 2018:09:12:13:04:24:SJ cbx_stratix 2018:09:12:13:04:24:SJ cbx_stratixii 2018:09:12:13:04:24:SJ cbx_stratixiii 2018:09:12:13:04:24:SJ cbx_stratixv 2018:09:12:13:04:24:SJ cbx_util_mgl 2018:09:12:13:04:24:SJ  VERSION_END

//synthesis_resources = M9K 6 
//synopsys translate_off
`timescale 1 ps / 1 ps
//synopsys translate_on
(* ALTERA_ATTRIBUTE = {"OPTIMIZE_POWER_DURING_SYNTHESIS=NORMAL_COMPILATION"} *)
module  rx_fifo_altsyncram_f821
	( 
	aclr1,
	address_a,
	address_b,
	addressstall_b,
	clock0,
	clock1,
	data_a,
	q_b,
	wren_a) /* synthesis synthesis_clearbox=1 */;
	input   aclr1;
	input   [8:0]  address_a;
	input   [8:0]  address_b;
	input   addressstall_b;
	input   clock0;
	input   clock1;
	input   [96:0]  data_a;
	output   [96:0]  q_b;
	input   wren_a;
`ifndef ALTERA_RESERVED_QIS
// synopsys translate_off
`endif
	tri0   aclr1;
	tri1   [8:0]  address_b;
	tri0   addressstall_b;
	tri1   clock0;
	tri1   clock1;
	tri1   [96:0]  data_a;
	tri0   wren_a;
`ifndef ALTERA_RESERVED_QIS
// synopsys translate_on
`endif

	wire  [0:0]   wire_ram_block11a_0portbdataout;
	wire  [0:0]   wire_ram_block11a_1portbdataout;
	wire  [0:0]   wire_ram_block11a_2portbdataout;
	wire  [0:0]   wire_ram_block11a_3portbdataout;
	wire  [0:0]   wire_ram_block11a_4portbdataout;
	wire  [0:0]   wire_ram_block11a_5portbdataout;
	wire  [0:0]   wire_ram_block11a_6portbdataout;
	wire  [0:0]   wire_ram_block11a_7portbdataout;
	wire  [0:0]   wire_ram_block11a_8portbdataout;
	wire  [0:0]   wire_ram_block11a_9portbdataout;
	wire  [0:0]   wire_ram_block11a_10portbdataout;
	wire  [0:0]   wire_ram_block11a_11portbdataout;
	wire  [0:0]   wire_ram_block11a_12portbdataout;
	wire  [0:0]   wire_ram_block11a_13portbdataout;
	wire  [0:0]   wire_ram_block11a_14portbdataout;
	wire  [0:0]   wire_ram_block11a_15portbdataout;
	wire  [0:0]   wire_ram_block11a_16portbdataout;
	wire  [0:0]   wire_ram_block11a_17portbdataout;
	wire  [0:0]   wire_ram_block11a_18portbdataout;
	wire  [0:0]   wire_ram_block11a_19portbdataout;
	wire  [0:0]   wire_ram_block11a_20portbdataout;
	wire  [0:0]   wire_ram_block11a_21portbdataout;
	wire  [0:0]   wire_ram_block11a_22portbdataout;
	wire  [0:0]   wire_ram_block11a_23portbdataout;
	wire  [0:0]   wire_ram_block11a_24portbdataout;
	wire  [0:0]   wire_ram_block11a_25portbdataout;
	wire  [0:0]   wire_ram_block11a_26portbdataout;
	wire  [0:0]   wire_ram_block11a_27portbdataout;
	wire  [0:0]   wire_ram_block11a_28portbdataout;
	wire  [0:0]   wire_ram_block11a_29portbdataout;
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
	wire  [0:0]   wire_ram_block11a_93portbdataout;
	wire  [0:0]   wire_ram_block11a_94portbdataout;
	wire  [0:0]   wire_ram_block11a_95portbdataout;
	wire  [0:0]   wire_ram_block11a_96portbdataout;
	wire  [8:0]  address_a_wire;
	wire  [8:0]  address_b_wire;

	cycloneive_ram_block   ram_block11a_0
	( 
	.clk0(clock0),
	.clk1(clock1),
	.clr1(aclr1),
	.ena0(wren_a),
	.portaaddr({address_a_wire[8:0]}),
	.portadatain({data_a[0]}),
	.portadataout(),
	.portawe(wren_a),
	.portbaddr({address_b_wire[8:0]}),
	.portbaddrstall(addressstall_b),
	.portbdataout(wire_ram_block11a_0portbdataout[0:0]),
	.portbre(1'b1)
	`ifndef FORMAL_VERIFICATION
	// synopsys translate_off
	`endif
	,
	.clr0(1'b0),
	.ena1(1'b1),
	.ena2(1'b1),
	.ena3(1'b1),
	.portaaddrstall(1'b0),
	.portabyteenamasks({1{1'b1}}),
	.portare(1'b1),
	.portbbyteenamasks({1{1'b1}}),
	.portbdatain({1{1'b0}}),
	.portbwe(1'b0)
	`ifndef FORMAL_VERIFICATION
	// synopsys translate_on
	`endif
	// synopsys translate_off
	,
	.devclrn(1'b1),
	.devpor(1'b1)
	// synopsys translate_on
	);
	defparam
		ram_block11a_0.clk0_core_clock_enable = "ena0",
		ram_block11a_0.clk0_input_clock_enable = "none",
		ram_block11a_0.clk1_core_clock_enable = "none",
		ram_block11a_0.clk1_input_clock_enable = "none",
		ram_block11a_0.connectivity_checking = "OFF",
		ram_block11a_0.logical_ram_name = "ALTSYNCRAM",
		ram_block11a_0.mixed_port_feed_through_mode = "dont_care",
		ram_block11a_0.operation_mode = "dual_port",
		ram_block11a_0.port_a_address_width = 9,
		ram_block11a_0.port_a_data_width = 1,
		ram_block11a_0.port_a_first_address = 0,
		ram_block11a_0.port_a_first_bit_number = 0,
		ram_block11a_0.port_a_last_address = 511,
		ram_block11a_0.port_a_logical_ram_depth = 512,
		ram_block11a_0.port_a_logical_ram_width = 97,
		ram_block11a_0.port_b_address_clear = "clear1",
		ram_block11a_0.port_b_address_clock = "clock1",
		ram_block11a_0.port_b_address_width = 9,
		ram_block11a_0.port_b_data_out_clear = "none",
		ram_block11a_0.port_b_data_width = 1,
		ram_block11a_0.port_b_first_address = 0,
		ram_block11a_0.port_b_first_bit_number = 0,
		ram_block11a_0.port_b_last_address = 511,
		ram_block11a_0.port_b_logical_ram_depth = 512,
		ram_block11a_0.port_b_logical_ram_width = 97,
		ram_block11a_0.port_b_read_enable_clock = "clock1",
		ram_block11a_0.ram_block_type = "AUTO",
		ram_block11a_0.lpm_type = "cycloneive_ram_block";
	cycloneive_ram_block   ram_block11a_1
	( 
	.clk0(clock0),
	.clk1(clock1),
	.clr1(aclr1),
	.ena0(wren_a),
	.portaaddr({address_a_wire[8:0]}),
	.portadatain({data_a[1]}),
	.portadataout(),
	.portawe(wren_a),
	.portbaddr({address_b_wire[8:0]}),
	.portbaddrstall(addressstall_b),
	.portbdataout(wire_ram_block11a_1portbdataout[0:0]),
	.portbre(1'b1)
	`ifndef FORMAL_VERIFICATION
	// synopsys translate_off
	`endif
	,
	.clr0(1'b0),
	.ena1(1'b1),
	.ena2(1'b1),
	.ena3(1'b1),
	.portaaddrstall(1'b0),
	.portabyteenamasks({1{1'b1}}),
	.portare(1'b1),
	.portbbyteenamasks({1{1'b1}}),
	.portbdatain({1{1'b0}}),
	.portbwe(1'b0)
	`ifndef FORMAL_VERIFICATION
	// synopsys translate_on
	`endif
	// synopsys translate_off
	,
	.devclrn(1'b1),
	.devpor(1'b1)
	// synopsys translate_on
	);
	defparam
		ram_block11a_1.clk0_core_clock_enable = "ena0",
		ram_block11a_1.clk0_input_clock_enable = "none",
		ram_block11a_1.clk1_core_clock_enable = "none",
		ram_block11a_1.clk1_input_clock_enable = "none",
		ram_block11a_1.connectivity_checking = "OFF",
		ram_block11a_1.logical_ram_name = "ALTSYNCRAM",
		ram_block11a_1.mixed_port_feed_through_mode = "dont_care",
		ram_block11a_1.operation_mode = "dual_port",
		ram_block11a_1.port_a_address_width = 9,
		ram_block11a_1.port_a_data_width = 1,
		ram_block11a_1.port_a_first_address = 0,
		ram_block11a_1.port_a_first_bit_number = 1,
		ram_block11a_1.port_a_last_address = 511,
		ram_block11a_1.port_a_logical_ram_depth = 512,
		ram_block11a_1.port_a_logical_ram_width = 97,
		ram_block11a_1.port_b_address_clear = "clear1",
		ram_block11a_1.port_b_address_clock = "clock1",
		ram_block11a_1.port_b_address_width = 9,
		ram_block11a_1.port_b_data_out_clear = "none",
		ram_block11a_1.port_b_data_width = 1,
		ram_block11a_1.port_b_first_address = 0,
		ram_block11a_1.port_b_first_bit_number = 1,
		ram_block11a_1.port_b_last_address = 511,
		ram_block11a_1.port_b_logical_ram_depth = 512,
		ram_block11a_1.port_b_logical_ram_width = 97,
		ram_block11a_1.port_b_read_enable_clock = "clock1",
		ram_block11a_1.ram_block_type = "AUTO",
		ram_block11a_1.lpm_type = "cycloneive_ram_block";
	cycloneive_ram_block   ram_block11a_2
	( 
	.clk0(clock0),
	.clk1(clock1),
	.clr1(aclr1),
	.ena0(wren_a),
	.portaaddr({address_a_wire[8:0]}),
	.portadatain({data_a[2]}),
	.portadataout(),
	.portawe(wren_a),
	.portbaddr({address_b_wire[8:0]}),
	.portbaddrstall(addressstall_b),
	.portbdataout(wire_ram_block11a_2portbdataout[0:0]),
	.portbre(1'b1)
	`ifndef FORMAL_VERIFICATION
	// synopsys translate_off
	`endif
	,
	.clr0(1'b0),
	.ena1(1'b1),
	.ena2(1'b1),
	.ena3(1'b1),
	.portaaddrstall(1'b0),
	.portabyteenamasks({1{1'b1}}),
	.portare(1'b1),
	.portbbyteenamasks({1{1'b1}}),
	.portbdatain({1{1'b0}}),
	.portbwe(1'b0)
	`ifndef FORMAL_VERIFICATION
	// synopsys translate_on
	`endif
	// synopsys translate_off
	,
	.devclrn(1'b1),
	.devpor(1'b1)
	// synopsys translate_on
	);
	defparam
		ram_block11a_2.clk0_core_clock_enable = "ena0",
		ram_block11a_2.clk0_input_clock_enable = "none",
		ram_block11a_2.clk1_core_clock_enable = "none",
		ram_block11a_2.clk1_input_clock_enable = "none",
		ram_block11a_2.connectivity_checking = "OFF",
		ram_block11a_2.logical_ram_name = "ALTSYNCRAM",
		ram_block11a_2.mixed_port_feed_through_mode = "dont_care",
		ram_block11a_2.operation_mode = "dual_port",
		ram_block11a_2.port_a_address_width = 9,
		ram_block11a_2.port_a_data_width = 1,
		ram_block11a_2.port_a_first_address = 0,
		ram_block11a_2.port_a_first_bit_number = 2,
		ram_block11a_2.port_a_last_address = 511,
		ram_block11a_2.port_a_logical_ram_depth = 512,
		ram_block11a_2.port_a_logical_ram_width = 97,
		ram_block11a_2.port_b_address_clear = "clear1",
		ram_block11a_2.port_b_address_clock = "clock1",
		ram_block11a_2.port_b_address_width = 9,
		ram_block11a_2.port_b_data_out_clear = "none",
		ram_block11a_2.port_b_data_width = 1,
		ram_block11a_2.port_b_first_address = 0,
		ram_block11a_2.port_b_first_bit_number = 2,
		ram_block11a_2.port_b_last_address = 511,
		ram_block11a_2.port_b_logical_ram_depth = 512,
		ram_block11a_2.port_b_logical_ram_width = 97,
		ram_block11a_2.port_b_read_enable_clock = "clock1",
		ram_block11a_2.ram_block_type = "AUTO",
		ram_block11a_2.lpm_type = "cycloneive_ram_block";
	cycloneive_ram_block   ram_block11a_3
	( 
	.clk0(clock0),
	.clk1(clock1),
	.clr1(aclr1),
	.ena0(wren_a),
	.portaaddr({address_a_wire[8:0]}),
	.portadatain({data_a[3]}),
	.portadataout(),
	.portawe(wren_a),
	.portbaddr({address_b_wire[8:0]}),
	.portbaddrstall(addressstall_b),
	.portbdataout(wire_ram_block11a_3portbdataout[0:0]),
	.portbre(1'b1)
	`ifndef FORMAL_VERIFICATION
	// synopsys translate_off
	`endif
	,
	.clr0(1'b0),
	.ena1(1'b1),
	.ena2(1'b1),
	.ena3(1'b1),
	.portaaddrstall(1'b0),
	.portabyteenamasks({1{1'b1}}),
	.portare(1'b1),
	.portbbyteenamasks({1{1'b1}}),
	.portbdatain({1{1'b0}}),
	.portbwe(1'b0)
	`ifndef FORMAL_VERIFICATION
	// synopsys translate_on
	`endif
	// synopsys translate_off
	,
	.devclrn(1'b1),
	.devpor(1'b1)
	// synopsys translate_on
	);
	defparam
		ram_block11a_3.clk0_core_clock_enable = "ena0",
		ram_block11a_3.clk0_input_clock_enable = "none",
		ram_block11a_3.clk1_core_clock_enable = "none",
		ram_block11a_3.clk1_input_clock_enable = "none",
		ram_block11a_3.connectivity_checking = "OFF",
		ram_block11a_3.logical_ram_name = "ALTSYNCRAM",
		ram_block11a_3.mixed_port_feed_through_mode = "dont_care",
		ram_block11a_3.operation_mode = "dual_port",
		ram_block11a_3.port_a_address_width = 9,
		ram_block11a_3.port_a_data_width = 1,
		ram_block11a_3.port_a_first_address = 0,
		ram_block11a_3.port_a_first_bit_number = 3,
		ram_block11a_3.port_a_last_address = 511,
		ram_block11a_3.port_a_logical_ram_depth = 512,
		ram_block11a_3.port_a_logical_ram_width = 97,
		ram_block11a_3.port_b_address_clear = "clear1",
		ram_block11a_3.port_b_address_clock = "clock1",
		ram_block11a_3.port_b_address_width = 9,
		ram_block11a_3.port_b_data_out_clear = "none",
		ram_block11a_3.port_b_data_width = 1,
		ram_block11a_3.port_b_first_address = 0,
		ram_block11a_3.port_b_first_bit_number = 3,
		ram_block11a_3.port_b_last_address = 511,
		ram_block11a_3.port_b_logical_ram_depth = 512,
		ram_block11a_3.port_b_logical_ram_width = 97,
		ram_block11a_3.port_b_read_enable_clock = "clock1",
		ram_block11a_3.ram_block_type = "AUTO",
		ram_block11a_3.lpm_type = "cycloneive_ram_block";
	cycloneive_ram_block   ram_block11a_4
	( 
	.clk0(clock0),
	.clk1(clock1),
	.clr1(aclr1),
	.ena0(wren_a),
	.portaaddr({address_a_wire[8:0]}),
	.portadatain({data_a[4]}),
	.portadataout(),
	.portawe(wren_a),
	.portbaddr({address_b_wire[8:0]}),
	.portbaddrstall(addressstall_b),
	.portbdataout(wire_ram_block11a_4portbdataout[0:0]),
	.portbre(1'b1)
	`ifndef FORMAL_VERIFICATION
	// synopsys translate_off
	`endif
	,
	.clr0(1'b0),
	.ena1(1'b1),
	.ena2(1'b1),
	.ena3(1'b1),
	.portaaddrstall(1'b0),
	.portabyteenamasks({1{1'b1}}),
	.portare(1'b1),
	.portbbyteenamasks({1{1'b1}}),
	.portbdatain({1{1'b0}}),
	.portbwe(1'b0)
	`ifndef FORMAL_VERIFICATION
	// synopsys translate_on
	`endif
	// synopsys translate_off
	,
	.devclrn(1'b1),
	.devpor(1'b1)
	// synopsys translate_on
	);
	defparam
		ram_block11a_4.clk0_core_clock_enable = "ena0",
		ram_block11a_4.clk0_input_clock_enable = "none",
		ram_block11a_4.clk1_core_clock_enable = "none",
		ram_block11a_4.clk1_input_clock_enable = "none",
		ram_block11a_4.connectivity_checking = "OFF",
		ram_block11a_4.logical_ram_name = "ALTSYNCRAM",
		ram_block11a_4.mixed_port_feed_through_mode = "dont_care",
		ram_block11a_4.operation_mode = "dual_port",
		ram_block11a_4.port_a_address_width = 9,
		ram_block11a_4.port_a_data_width = 1,
		ram_block11a_4.port_a_first_address = 0,
		ram_block11a_4.port_a_first_bit_number = 4,
		ram_block11a_4.port_a_last_address = 511,
		ram_block11a_4.port_a_logical_ram_depth = 512,
		ram_block11a_4.port_a_logical_ram_width = 97,
		ram_block11a_4.port_b_address_clear = "clear1",
		ram_block11a_4.port_b_address_clock = "clock1",
		ram_block11a_4.port_b_address_width = 9,
		ram_block11a_4.port_b_data_out_clear = "none",
		ram_block11a_4.port_b_data_width = 1,
		ram_block11a_4.port_b_first_address = 0,
		ram_block11a_4.port_b_first_bit_number = 4,
		ram_block11a_4.port_b_last_address = 511,
		ram_block11a_4.port_b_logical_ram_depth = 512,
		ram_block11a_4.port_b_logical_ram_width = 97,
		ram_block11a_4.port_b_read_enable_clock = "clock1",
		ram_block11a_4.ram_block_type = "AUTO",
		ram_block11a_4.lpm_type = "cycloneive_ram_block";
	cycloneive_ram_block   ram_block11a_5
	( 
	.clk0(clock0),
	.clk1(clock1),
	.clr1(aclr1),
	.ena0(wren_a),
	.portaaddr({address_a_wire[8:0]}),
	.portadatain({data_a[5]}),
	.portadataout(),
	.portawe(wren_a),
	.portbaddr({address_b_wire[8:0]}),
	.portbaddrstall(addressstall_b),
	.portbdataout(wire_ram_block11a_5portbdataout[0:0]),
	.portbre(1'b1)
	`ifndef FORMAL_VERIFICATION
	// synopsys translate_off
	`endif
	,
	.clr0(1'b0),
	.ena1(1'b1),
	.ena2(1'b1),
	.ena3(1'b1),
	.portaaddrstall(1'b0),
	.portabyteenamasks({1{1'b1}}),
	.portare(1'b1),
	.portbbyteenamasks({1{1'b1}}),
	.portbdatain({1{1'b0}}),
	.portbwe(1'b0)
	`ifndef FORMAL_VERIFICATION
	// synopsys translate_on
	`endif
	// synopsys translate_off
	,
	.devclrn(1'b1),
	.devpor(1'b1)
	// synopsys translate_on
	);
	defparam
		ram_block11a_5.clk0_core_clock_enable = "ena0",
		ram_block11a_5.clk0_input_clock_enable = "none",
		ram_block11a_5.clk1_core_clock_enable = "none",
		ram_block11a_5.clk1_input_clock_enable = "none",
		ram_block11a_5.connectivity_checking = "OFF",
		ram_block11a_5.logical_ram_name = "ALTSYNCRAM",
		ram_block11a_5.mixed_port_feed_through_mode = "dont_care",
		ram_block11a_5.operation_mode = "dual_port",
		ram_block11a_5.port_a_address_width = 9,
		ram_block11a_5.port_a_data_width = 1,
		ram_block11a_5.port_a_first_address = 0,
		ram_block11a_5.port_a_first_bit_number = 5,
		ram_block11a_5.port_a_last_address = 511,
		ram_block11a_5.port_a_logical_ram_depth = 512,
		ram_block11a_5.port_a_logical_ram_width = 97,
		ram_block11a_5.port_b_address_clear = "clear1",
		ram_block11a_5.port_b_address_clock = "clock1",
		ram_block11a_5.port_b_address_width = 9,
		ram_block11a_5.port_b_data_out_clear = "none",
		ram_block11a_5.port_b_data_width = 1,
		ram_block11a_5.port_b_first_address = 0,
		ram_block11a_5.port_b_first_bit_number = 5,
		ram_block11a_5.port_b_last_address = 511,
		ram_block11a_5.port_b_logical_ram_depth = 512,
		ram_block11a_5.port_b_logical_ram_width = 97,
		ram_block11a_5.port_b_read_enable_clock = "clock1",
		ram_block11a_5.ram_block_type = "AUTO",
		ram_block11a_5.lpm_type = "cycloneive_ram_block";
	cycloneive_ram_block   ram_block11a_6
	( 
	.clk0(clock0),
	.clk1(clock1),
	.clr1(aclr1),
	.ena0(wren_a),
	.portaaddr({address_a_wire[8:0]}),
	.portadatain({data_a[6]}),
	.portadataout(),
	.portawe(wren_a),
	.portbaddr({address_b_wire[8:0]}),
	.portbaddrstall(addressstall_b),
	.portbdataout(wire_ram_block11a_6portbdataout[0:0]),
	.portbre(1'b1)
	`ifndef FORMAL_VERIFICATION
	// synopsys translate_off
	`endif
	,
	.clr0(1'b0),
	.ena1(1'b1),
	.ena2(1'b1),
	.ena3(1'b1),
	.portaaddrstall(1'b0),
	.portabyteenamasks({1{1'b1}}),
	.portare(1'b1),
	.portbbyteenamasks({1{1'b1}}),
	.portbdatain({1{1'b0}}),
	.portbwe(1'b0)
	`ifndef FORMAL_VERIFICATION
	// synopsys translate_on
	`endif
	// synopsys translate_off
	,
	.devclrn(1'b1),
	.devpor(1'b1)
	// synopsys translate_on
	);
	defparam
		ram_block11a_6.clk0_core_clock_enable = "ena0",
		ram_block11a_6.clk0_input_clock_enable = "none",
		ram_block11a_6.clk1_core_clock_enable = "none",
		ram_block11a_6.clk1_input_clock_enable = "none",
		ram_block11a_6.connectivity_checking = "OFF",
		ram_block11a_6.logical_ram_name = "ALTSYNCRAM",
		ram_block11a_6.mixed_port_feed_through_mode = "dont_care",
		ram_block11a_6.operation_mode = "dual_port",
		ram_block11a_6.port_a_address_width = 9,
		ram_block11a_6.port_a_data_width = 1,
		ram_block11a_6.port_a_first_address = 0,
		ram_block11a_6.port_a_first_bit_number = 6,
		ram_block11a_6.port_a_last_address = 511,
		ram_block11a_6.port_a_logical_ram_depth = 512,
		ram_block11a_6.port_a_logical_ram_width = 97,
		ram_block11a_6.port_b_address_clear = "clear1",
		ram_block11a_6.port_b_address_clock = "clock1",
		ram_block11a_6.port_b_address_width = 9,
		ram_block11a_6.port_b_data_out_clear = "none",
		ram_block11a_6.port_b_data_width = 1,
		ram_block11a_6.port_b_first_address = 0,
		ram_block11a_6.port_b_first_bit_number = 6,
		ram_block11a_6.port_b_last_address = 511,
		ram_block11a_6.port_b_logical_ram_depth = 512,
		ram_block11a_6.port_b_logical_ram_width = 97,
		ram_block11a_6.port_b_read_enable_clock = "clock1",
		ram_block11a_6.ram_block_type = "AUTO",
		ram_block11a_6.lpm_type = "cycloneive_ram_block";
	cycloneive_ram_block   ram_block11a_7
	( 
	.clk0(clock0),
	.clk1(clock1),
	.clr1(aclr1),
	.ena0(wren_a),
	.portaaddr({address_a_wire[8:0]}),
	.portadatain({data_a[7]}),
	.portadataout(),
	.portawe(wren_a),
	.portbaddr({address_b_wire[8:0]}),
	.portbaddrstall(addressstall_b),
	.portbdataout(wire_ram_block11a_7portbdataout[0:0]),
	.portbre(1'b1)
	`ifndef FORMAL_VERIFICATION
	// synopsys translate_off
	`endif
	,
	.clr0(1'b0),
	.ena1(1'b1),
	.ena2(1'b1),
	.ena3(1'b1),
	.portaaddrstall(1'b0),
	.portabyteenamasks({1{1'b1}}),
	.portare(1'b1),
	.portbbyteenamasks({1{1'b1}}),
	.portbdatain({1{1'b0}}),
	.portbwe(1'b0)
	`ifndef FORMAL_VERIFICATION
	// synopsys translate_on
	`endif
	// synopsys translate_off
	,
	.devclrn(1'b1),
	.devpor(1'b1)
	// synopsys translate_on
	);
	defparam
		ram_block11a_7.clk0_core_clock_enable = "ena0",
		ram_block11a_7.clk0_input_clock_enable = "none",
		ram_block11a_7.clk1_core_clock_enable = "none",
		ram_block11a_7.clk1_input_clock_enable = "none",
		ram_block11a_7.connectivity_checking = "OFF",
		ram_block11a_7.logical_ram_name = "ALTSYNCRAM",
		ram_block11a_7.mixed_port_feed_through_mode = "dont_care",
		ram_block11a_7.operation_mode = "dual_port",
		ram_block11a_7.port_a_address_width = 9,
		ram_block11a_7.port_a_data_width = 1,
		ram_block11a_7.port_a_first_address = 0,
		ram_block11a_7.port_a_first_bit_number = 7,
		ram_block11a_7.port_a_last_address = 511,
		ram_block11a_7.port_a_logical_ram_depth = 512,
		ram_block11a_7.port_a_logical_ram_width = 97,
		ram_block11a_7.port_b_address_clear = "clear1",
		ram_block11a_7.port_b_address_clock = "clock1",
		ram_block11a_7.port_b_address_width = 9,
		ram_block11a_7.port_b_data_out_clear = "none",
		ram_block11a_7.port_b_data_width = 1,
		ram_block11a_7.port_b_first_address = 0,
		ram_block11a_7.port_b_first_bit_number = 7,
		ram_block11a_7.port_b_last_address = 511,
		ram_block11a_7.port_b_logical_ram_depth = 512,
		ram_block11a_7.port_b_logical_ram_width = 97,
		ram_block11a_7.port_b_read_enable_clock = "clock1",
		ram_block11a_7.ram_block_type = "AUTO",
		ram_block11a_7.lpm_type = "cycloneive_ram_block";
	cycloneive_ram_block   ram_block11a_8
	( 
	.clk0(clock0),
	.clk1(clock1),
	.clr1(aclr1),
	.ena0(wren_a),
	.portaaddr({address_a_wire[8:0]}),
	.portadatain({data_a[8]}),
	.portadataout(),
	.portawe(wren_a),
	.portbaddr({address_b_wire[8:0]}),
	.portbaddrstall(addressstall_b),
	.portbdataout(wire_ram_block11a_8portbdataout[0:0]),
	.portbre(1'b1)
	`ifndef FORMAL_VERIFICATION
	// synopsys translate_off
	`endif
	,
	.clr0(1'b0),
	.ena1(1'b1),
	.ena2(1'b1),
	.ena3(1'b1),
	.portaaddrstall(1'b0),
	.portabyteenamasks({1{1'b1}}),
	.portare(1'b1),
	.portbbyteenamasks({1{1'b1}}),
	.portbdatain({1{1'b0}}),
	.portbwe(1'b0)
	`ifndef FORMAL_VERIFICATION
	// synopsys translate_on
	`endif
	// synopsys translate_off
	,
	.devclrn(1'b1),
	.devpor(1'b1)
	// synopsys translate_on
	);
	defparam
		ram_block11a_8.clk0_core_clock_enable = "ena0",
		ram_block11a_8.clk0_input_clock_enable = "none",
		ram_block11a_8.clk1_core_clock_enable = "none",
		ram_block11a_8.clk1_input_clock_enable = "none",
		ram_block11a_8.connectivity_checking = "OFF",
		ram_block11a_8.logical_ram_name = "ALTSYNCRAM",
		ram_block11a_8.mixed_port_feed_through_mode = "dont_care",
		ram_block11a_8.operation_mode = "dual_port",
		ram_block11a_8.port_a_address_width = 9,
		ram_block11a_8.port_a_data_width = 1,
		ram_block11a_8.port_a_first_address = 0,
		ram_block11a_8.port_a_first_bit_number = 8,
		ram_block11a_8.port_a_last_address = 511,
		ram_block11a_8.port_a_logical_ram_depth = 512,
		ram_block11a_8.port_a_logical_ram_width = 97,
		ram_block11a_8.port_b_address_clear = "clear1",
		ram_block11a_8.port_b_address_clock = "clock1",
		ram_block11a_8.port_b_address_width = 9,
		ram_block11a_8.port_b_data_out_clear = "none",
		ram_block11a_8.port_b_data_width = 1,
		ram_block11a_8.port_b_first_address = 0,
		ram_block11a_8.port_b_first_bit_number = 8,
		ram_block11a_8.port_b_last_address = 511,
		ram_block11a_8.port_b_logical_ram_depth = 512,
		ram_block11a_8.port_b_logical_ram_width = 97,
		ram_block11a_8.port_b_read_enable_clock = "clock1",
		ram_block11a_8.ram_block_type = "AUTO",
		ram_block11a_8.lpm_type = "cycloneive_ram_block";
	cycloneive_ram_block   ram_block11a_9
	( 
	.clk0(clock0),
	.clk1(clock1),
	.clr1(aclr1),
	.ena0(wren_a),
	.portaaddr({address_a_wire[8:0]}),
	.portadatain({data_a[9]}),
	.portadataout(),
	.portawe(wren_a),
	.portbaddr({address_b_wire[8:0]}),
	.portbaddrstall(addressstall_b),
	.portbdataout(wire_ram_block11a_9portbdataout[0:0]),
	.portbre(1'b1)
	`ifndef FORMAL_VERIFICATION
	// synopsys translate_off
	`endif
	,
	.clr0(1'b0),
	.ena1(1'b1),
	.ena2(1'b1),
	.ena3(1'b1),
	.portaaddrstall(1'b0),
	.portabyteenamasks({1{1'b1}}),
	.portare(1'b1),
	.portbbyteenamasks({1{1'b1}}),
	.portbdatain({1{1'b0}}),
	.portbwe(1'b0)
	`ifndef FORMAL_VERIFICATION
	// synopsys translate_on
	`endif
	// synopsys translate_off
	,
	.devclrn(1'b1),
	.devpor(1'b1)
	// synopsys translate_on
	);
	defparam
		ram_block11a_9.clk0_core_clock_enable = "ena0",
		ram_block11a_9.clk0_input_clock_enable = "none",
		ram_block11a_9.clk1_core_clock_enable = "none",
		ram_block11a_9.clk1_input_clock_enable = "none",
		ram_block11a_9.connectivity_checking = "OFF",
		ram_block11a_9.logical_ram_name = "ALTSYNCRAM",
		ram_block11a_9.mixed_port_feed_through_mode = "dont_care",
		ram_block11a_9.operation_mode = "dual_port",
		ram_block11a_9.port_a_address_width = 9,
		ram_block11a_9.port_a_data_width = 1,
		ram_block11a_9.port_a_first_address = 0,
		ram_block11a_9.port_a_first_bit_number = 9,
		ram_block11a_9.port_a_last_address = 511,
		ram_block11a_9.port_a_logical_ram_depth = 512,
		ram_block11a_9.port_a_logical_ram_width = 97,
		ram_block11a_9.port_b_address_clear = "clear1",
		ram_block11a_9.port_b_address_clock = "clock1",
		ram_block11a_9.port_b_address_width = 9,
		ram_block11a_9.port_b_data_out_clear = "none",
		ram_block11a_9.port_b_data_width = 1,
		ram_block11a_9.port_b_first_address = 0,
		ram_block11a_9.port_b_first_bit_number = 9,
		ram_block11a_9.port_b_last_address = 511,
		ram_block11a_9.port_b_logical_ram_depth = 512,
		ram_block11a_9.port_b_logical_ram_width = 97,
		ram_block11a_9.port_b_read_enable_clock = "clock1",
		ram_block11a_9.ram_block_type = "AUTO",
		ram_block11a_9.lpm_type = "cycloneive_ram_block";
	cycloneive_ram_block   ram_block11a_10
	( 
	.clk0(clock0),
	.clk1(clock1),
	.clr1(aclr1),
	.ena0(wren_a),
	.portaaddr({address_a_wire[8:0]}),
	.portadatain({data_a[10]}),
	.portadataout(),
	.portawe(wren_a),
	.portbaddr({address_b_wire[8:0]}),
	.portbaddrstall(addressstall_b),
	.portbdataout(wire_ram_block11a_10portbdataout[0:0]),
	.portbre(1'b1)
	`ifndef FORMAL_VERIFICATION
	// synopsys translate_off
	`endif
	,
	.clr0(1'b0),
	.ena1(1'b1),
	.ena2(1'b1),
	.ena3(1'b1),
	.portaaddrstall(1'b0),
	.portabyteenamasks({1{1'b1}}),
	.portare(1'b1),
	.portbbyteenamasks({1{1'b1}}),
	.portbdatain({1{1'b0}}),
	.portbwe(1'b0)
	`ifndef FORMAL_VERIFICATION
	// synopsys translate_on
	`endif
	// synopsys translate_off
	,
	.devclrn(1'b1),
	.devpor(1'b1)
	// synopsys translate_on
	);
	defparam
		ram_block11a_10.clk0_core_clock_enable = "ena0",
		ram_block11a_10.clk0_input_clock_enable = "none",
		ram_block11a_10.clk1_core_clock_enable = "none",
		ram_block11a_10.clk1_input_clock_enable = "none",
		ram_block11a_10.connectivity_checking = "OFF",
		ram_block11a_10.logical_ram_name = "ALTSYNCRAM",
		ram_block11a_10.mixed_port_feed_through_mode = "dont_care",
		ram_block11a_10.operation_mode = "dual_port",
		ram_block11a_10.port_a_address_width = 9,
		ram_block11a_10.port_a_data_width = 1,
		ram_block11a_10.port_a_first_address = 0,
		ram_block11a_10.port_a_first_bit_number = 10,
		ram_block11a_10.port_a_last_address = 511,
		ram_block11a_10.port_a_logical_ram_depth = 512,
		ram_block11a_10.port_a_logical_ram_width = 97,
		ram_block11a_10.port_b_address_clear = "clear1",
		ram_block11a_10.port_b_address_clock = "clock1",
		ram_block11a_10.port_b_address_width = 9,
		ram_block11a_10.port_b_data_out_clear = "none",
		ram_block11a_10.port_b_data_width = 1,
		ram_block11a_10.port_b_first_address = 0,
		ram_block11a_10.port_b_first_bit_number = 10,
		ram_block11a_10.port_b_last_address = 511,
		ram_block11a_10.port_b_logical_ram_depth = 512,
		ram_block11a_10.port_b_logical_ram_width = 97,
		ram_block11a_10.port_b_read_enable_clock = "clock1",
		ram_block11a_10.ram_block_type = "AUTO",
		ram_block11a_10.lpm_type = "cycloneive_ram_block";
	cycloneive_ram_block   ram_block11a_11
	( 
	.clk0(clock0),
	.clk1(clock1),
	.clr1(aclr1),
	.ena0(wren_a),
	.portaaddr({address_a_wire[8:0]}),
	.portadatain({data_a[11]}),
	.portadataout(),
	.portawe(wren_a),
	.portbaddr({address_b_wire[8:0]}),
	.portbaddrstall(addressstall_b),
	.portbdataout(wire_ram_block11a_11portbdataout[0:0]),
	.portbre(1'b1)
	`ifndef FORMAL_VERIFICATION
	// synopsys translate_off
	`endif
	,
	.clr0(1'b0),
	.ena1(1'b1),
	.ena2(1'b1),
	.ena3(1'b1),
	.portaaddrstall(1'b0),
	.portabyteenamasks({1{1'b1}}),
	.portare(1'b1),
	.portbbyteenamasks({1{1'b1}}),
	.portbdatain({1{1'b0}}),
	.portbwe(1'b0)
	`ifndef FORMAL_VERIFICATION
	// synopsys translate_on
	`endif
	// synopsys translate_off
	,
	.devclrn(1'b1),
	.devpor(1'b1)
	// synopsys translate_on
	);
	defparam
		ram_block11a_11.clk0_core_clock_enable = "ena0",
		ram_block11a_11.clk0_input_clock_enable = "none",
		ram_block11a_11.clk1_core_clock_enable = "none",
		ram_block11a_11.clk1_input_clock_enable = "none",
		ram_block11a_11.connectivity_checking = "OFF",
		ram_block11a_11.logical_ram_name = "ALTSYNCRAM",
		ram_block11a_11.mixed_port_feed_through_mode = "dont_care",
		ram_block11a_11.operation_mode = "dual_port",
		ram_block11a_11.port_a_address_width = 9,
		ram_block11a_11.port_a_data_width = 1,
		ram_block11a_11.port_a_first_address = 0,
		ram_block11a_11.port_a_first_bit_number = 11,
		ram_block11a_11.port_a_last_address = 511,
		ram_block11a_11.port_a_logical_ram_depth = 512,
		ram_block11a_11.port_a_logical_ram_width = 97,
		ram_block11a_11.port_b_address_clear = "clear1",
		ram_block11a_11.port_b_address_clock = "clock1",
		ram_block11a_11.port_b_address_width = 9,
		ram_block11a_11.port_b_data_out_clear = "none",
		ram_block11a_11.port_b_data_width = 1,
		ram_block11a_11.port_b_first_address = 0,
		ram_block11a_11.port_b_first_bit_number = 11,
		ram_block11a_11.port_b_last_address = 511,
		ram_block11a_11.port_b_logical_ram_depth = 512,
		ram_block11a_11.port_b_logical_ram_width = 97,
		ram_block11a_11.port_b_read_enable_clock = "clock1",
		ram_block11a_11.ram_block_type = "AUTO",
		ram_block11a_11.lpm_type = "cycloneive_ram_block";
	cycloneive_ram_block   ram_block11a_12
	( 
	.clk0(clock0),
	.clk1(clock1),
	.clr1(aclr1),
	.ena0(wren_a),
	.portaaddr({address_a_wire[8:0]}),
	.portadatain({data_a[12]}),
	.portadataout(),
	.portawe(wren_a),
	.portbaddr({address_b_wire[8:0]}),
	.portbaddrstall(addressstall_b),
	.portbdataout(wire_ram_block11a_12portbdataout[0:0]),
	.portbre(1'b1)
	`ifndef FORMAL_VERIFICATION
	// synopsys translate_off
	`endif
	,
	.clr0(1'b0),
	.ena1(1'b1),
	.ena2(1'b1),
	.ena3(1'b1),
	.portaaddrstall(1'b0),
	.portabyteenamasks({1{1'b1}}),
	.portare(1'b1),
	.portbbyteenamasks({1{1'b1}}),
	.portbdatain({1{1'b0}}),
	.portbwe(1'b0)
	`ifndef FORMAL_VERIFICATION
	// synopsys translate_on
	`endif
	// synopsys translate_off
	,
	.devclrn(1'b1),
	.devpor(1'b1)
	// synopsys translate_on
	);
	defparam
		ram_block11a_12.clk0_core_clock_enable = "ena0",
		ram_block11a_12.clk0_input_clock_enable = "none",
		ram_block11a_12.clk1_core_clock_enable = "none",
		ram_block11a_12.clk1_input_clock_enable = "none",
		ram_block11a_12.connectivity_checking = "OFF",
		ram_block11a_12.logical_ram_name = "ALTSYNCRAM",
		ram_block11a_12.mixed_port_feed_through_mode = "dont_care",
		ram_block11a_12.operation_mode = "dual_port",
		ram_block11a_12.port_a_address_width = 9,
		ram_block11a_12.port_a_data_width = 1,
		ram_block11a_12.port_a_first_address = 0,
		ram_block11a_12.port_a_first_bit_number = 12,
		ram_block11a_12.port_a_last_address = 511,
		ram_block11a_12.port_a_logical_ram_depth = 512,
		ram_block11a_12.port_a_logical_ram_width = 97,
		ram_block11a_12.port_b_address_clear = "clear1",
		ram_block11a_12.port_b_address_clock = "clock1",
		ram_block11a_12.port_b_address_width = 9,
		ram_block11a_12.port_b_data_out_clear = "none",
		ram_block11a_12.port_b_data_width = 1,
		ram_block11a_12.port_b_first_address = 0,
		ram_block11a_12.port_b_first_bit_number = 12,
		ram_block11a_12.port_b_last_address = 511,
		ram_block11a_12.port_b_logical_ram_depth = 512,
		ram_block11a_12.port_b_logical_ram_width = 97,
		ram_block11a_12.port_b_read_enable_clock = "clock1",
		ram_block11a_12.ram_block_type = "AUTO",
		ram_block11a_12.lpm_type = "cycloneive_ram_block";
	cycloneive_ram_block   ram_block11a_13
	( 
	.clk0(clock0),
	.clk1(clock1),
	.clr1(aclr1),
	.ena0(wren_a),
	.portaaddr({address_a_wire[8:0]}),
	.portadatain({data_a[13]}),
	.portadataout(),
	.portawe(wren_a),
	.portbaddr({address_b_wire[8:0]}),
	.portbaddrstall(addressstall_b),
	.portbdataout(wire_ram_block11a_13portbdataout[0:0]),
	.portbre(1'b1)
	`ifndef FORMAL_VERIFICATION
	// synopsys translate_off
	`endif
	,
	.clr0(1'b0),
	.ena1(1'b1),
	.ena2(1'b1),
	.ena3(1'b1),
	.portaaddrstall(1'b0),
	.portabyteenamasks({1{1'b1}}),
	.portare(1'b1),
	.portbbyteenamasks({1{1'b1}}),
	.portbdatain({1{1'b0}}),
	.portbwe(1'b0)
	`ifndef FORMAL_VERIFICATION
	// synopsys translate_on
	`endif
	// synopsys translate_off
	,
	.devclrn(1'b1),
	.devpor(1'b1)
	// synopsys translate_on
	);
	defparam
		ram_block11a_13.clk0_core_clock_enable = "ena0",
		ram_block11a_13.clk0_input_clock_enable = "none",
		ram_block11a_13.clk1_core_clock_enable = "none",
		ram_block11a_13.clk1_input_clock_enable = "none",
		ram_block11a_13.connectivity_checking = "OFF",
		ram_block11a_13.logical_ram_name = "ALTSYNCRAM",
		ram_block11a_13.mixed_port_feed_through_mode = "dont_care",
		ram_block11a_13.operation_mode = "dual_port",
		ram_block11a_13.port_a_address_width = 9,
		ram_block11a_13.port_a_data_width = 1,
		ram_block11a_13.port_a_first_address = 0,
		ram_block11a_13.port_a_first_bit_number = 13,
		ram_block11a_13.port_a_last_address = 511,
		ram_block11a_13.port_a_logical_ram_depth = 512,
		ram_block11a_13.port_a_logical_ram_width = 97,
		ram_block11a_13.port_b_address_clear = "clear1",
		ram_block11a_13.port_b_address_clock = "clock1",
		ram_block11a_13.port_b_address_width = 9,
		ram_block11a_13.port_b_data_out_clear = "none",
		ram_block11a_13.port_b_data_width = 1,
		ram_block11a_13.port_b_first_address = 0,
		ram_block11a_13.port_b_first_bit_number = 13,
		ram_block11a_13.port_b_last_address = 511,
		ram_block11a_13.port_b_logical_ram_depth = 512,
		ram_block11a_13.port_b_logical_ram_width = 97,
		ram_block11a_13.port_b_read_enable_clock = "clock1",
		ram_block11a_13.ram_block_type = "AUTO",
		ram_block11a_13.lpm_type = "cycloneive_ram_block";
	cycloneive_ram_block   ram_block11a_14
	( 
	.clk0(clock0),
	.clk1(clock1),
	.clr1(aclr1),
	.ena0(wren_a),
	.portaaddr({address_a_wire[8:0]}),
	.portadatain({data_a[14]}),
	.portadataout(),
	.portawe(wren_a),
	.portbaddr({address_b_wire[8:0]}),
	.portbaddrstall(addressstall_b),
	.portbdataout(wire_ram_block11a_14portbdataout[0:0]),
	.portbre(1'b1)
	`ifndef FORMAL_VERIFICATION
	// synopsys translate_off
	`endif
	,
	.clr0(1'b0),
	.ena1(1'b1),
	.ena2(1'b1),
	.ena3(1'b1),
	.portaaddrstall(1'b0),
	.portabyteenamasks({1{1'b1}}),
	.portare(1'b1),
	.portbbyteenamasks({1{1'b1}}),
	.portbdatain({1{1'b0}}),
	.portbwe(1'b0)
	`ifndef FORMAL_VERIFICATION
	// synopsys translate_on
	`endif
	// synopsys translate_off
	,
	.devclrn(1'b1),
	.devpor(1'b1)
	// synopsys translate_on
	);
	defparam
		ram_block11a_14.clk0_core_clock_enable = "ena0",
		ram_block11a_14.clk0_input_clock_enable = "none",
		ram_block11a_14.clk1_core_clock_enable = "none",
		ram_block11a_14.clk1_input_clock_enable = "none",
		ram_block11a_14.connectivity_checking = "OFF",
		ram_block11a_14.logical_ram_name = "ALTSYNCRAM",
		ram_block11a_14.mixed_port_feed_through_mode = "dont_care",
		ram_block11a_14.operation_mode = "dual_port",
		ram_block11a_14.port_a_address_width = 9,
		ram_block11a_14.port_a_data_width = 1,
		ram_block11a_14.port_a_first_address = 0,
		ram_block11a_14.port_a_first_bit_number = 14,
		ram_block11a_14.port_a_last_address = 511,
		ram_block11a_14.port_a_logical_ram_depth = 512,
		ram_block11a_14.port_a_logical_ram_width = 97,
		ram_block11a_14.port_b_address_clear = "clear1",
		ram_block11a_14.port_b_address_clock = "clock1",
		ram_block11a_14.port_b_address_width = 9,
		ram_block11a_14.port_b_data_out_clear = "none",
		ram_block11a_14.port_b_data_width = 1,
		ram_block11a_14.port_b_first_address = 0,
		ram_block11a_14.port_b_first_bit_number = 14,
		ram_block11a_14.port_b_last_address = 511,
		ram_block11a_14.port_b_logical_ram_depth = 512,
		ram_block11a_14.port_b_logical_ram_width = 97,
		ram_block11a_14.port_b_read_enable_clock = "clock1",
		ram_block11a_14.ram_block_type = "AUTO",
		ram_block11a_14.lpm_type = "cycloneive_ram_block";
	cycloneive_ram_block   ram_block11a_15
	( 
	.clk0(clock0),
	.clk1(clock1),
	.clr1(aclr1),
	.ena0(wren_a),
	.portaaddr({address_a_wire[8:0]}),
	.portadatain({data_a[15]}),
	.portadataout(),
	.portawe(wren_a),
	.portbaddr({address_b_wire[8:0]}),
	.portbaddrstall(addressstall_b),
	.portbdataout(wire_ram_block11a_15portbdataout[0:0]),
	.portbre(1'b1)
	`ifndef FORMAL_VERIFICATION
	// synopsys translate_off
	`endif
	,
	.clr0(1'b0),
	.ena1(1'b1),
	.ena2(1'b1),
	.ena3(1'b1),
	.portaaddrstall(1'b0),
	.portabyteenamasks({1{1'b1}}),
	.portare(1'b1),
	.portbbyteenamasks({1{1'b1}}),
	.portbdatain({1{1'b0}}),
	.portbwe(1'b0)
	`ifndef FORMAL_VERIFICATION
	// synopsys translate_on
	`endif
	// synopsys translate_off
	,
	.devclrn(1'b1),
	.devpor(1'b1)
	// synopsys translate_on
	);
	defparam
		ram_block11a_15.clk0_core_clock_enable = "ena0",
		ram_block11a_15.clk0_input_clock_enable = "none",
		ram_block11a_15.clk1_core_clock_enable = "none",
		ram_block11a_15.clk1_input_clock_enable = "none",
		ram_block11a_15.connectivity_checking = "OFF",
		ram_block11a_15.logical_ram_name = "ALTSYNCRAM",
		ram_block11a_15.mixed_port_feed_through_mode = "dont_care",
		ram_block11a_15.operation_mode = "dual_port",
		ram_block11a_15.port_a_address_width = 9,
		ram_block11a_15.port_a_data_width = 1,
		ram_block11a_15.port_a_first_address = 0,
		ram_block11a_15.port_a_first_bit_number = 15,
		ram_block11a_15.port_a_last_address = 511,
		ram_block11a_15.port_a_logical_ram_depth = 512,
		ram_block11a_15.port_a_logical_ram_width = 97,
		ram_block11a_15.port_b_address_clear = "clear1",
		ram_block11a_15.port_b_address_clock = "clock1",
		ram_block11a_15.port_b_address_width = 9,
		ram_block11a_15.port_b_data_out_clear = "none",
		ram_block11a_15.port_b_data_width = 1,
		ram_block11a_15.port_b_first_address = 0,
		ram_block11a_15.port_b_first_bit_number = 15,
		ram_block11a_15.port_b_last_address = 511,
		ram_block11a_15.port_b_logical_ram_depth = 512,
		ram_block11a_15.port_b_logical_ram_width = 97,
		ram_block11a_15.port_b_read_enable_clock = "clock1",
		ram_block11a_15.ram_block_type = "AUTO",
		ram_block11a_15.lpm_type = "cycloneive_ram_block";
	cycloneive_ram_block   ram_block11a_16
	( 
	.clk0(clock0),
	.clk1(clock1),
	.clr1(aclr1),
	.ena0(wren_a),
	.portaaddr({address_a_wire[8:0]}),
	.portadatain({data_a[16]}),
	.portadataout(),
	.portawe(wren_a),
	.portbaddr({address_b_wire[8:0]}),
	.portbaddrstall(addressstall_b),
	.portbdataout(wire_ram_block11a_16portbdataout[0:0]),
	.portbre(1'b1)
	`ifndef FORMAL_VERIFICATION
	// synopsys translate_off
	`endif
	,
	.clr0(1'b0),
	.ena1(1'b1),
	.ena2(1'b1),
	.ena3(1'b1),
	.portaaddrstall(1'b0),
	.portabyteenamasks({1{1'b1}}),
	.portare(1'b1),
	.portbbyteenamasks({1{1'b1}}),
	.portbdatain({1{1'b0}}),
	.portbwe(1'b0)
	`ifndef FORMAL_VERIFICATION
	// synopsys translate_on
	`endif
	// synopsys translate_off
	,
	.devclrn(1'b1),
	.devpor(1'b1)
	// synopsys translate_on
	);
	defparam
		ram_block11a_16.clk0_core_clock_enable = "ena0",
		ram_block11a_16.clk0_input_clock_enable = "none",
		ram_block11a_16.clk1_core_clock_enable = "none",
		ram_block11a_16.clk1_input_clock_enable = "none",
		ram_block11a_16.connectivity_checking = "OFF",
		ram_block11a_16.logical_ram_name = "ALTSYNCRAM",
		ram_block11a_16.mixed_port_feed_through_mode = "dont_care",
		ram_block11a_16.operation_mode = "dual_port",
		ram_block11a_16.port_a_address_width = 9,
		ram_block11a_16.port_a_data_width = 1,
		ram_block11a_16.port_a_first_address = 0,
		ram_block11a_16.port_a_first_bit_number = 16,
		ram_block11a_16.port_a_last_address = 511,
		ram_block11a_16.port_a_logical_ram_depth = 512,
		ram_block11a_16.port_a_logical_ram_width = 97,
		ram_block11a_16.port_b_address_clear = "clear1",
		ram_block11a_16.port_b_address_clock = "clock1",
		ram_block11a_16.port_b_address_width = 9,
		ram_block11a_16.port_b_data_out_clear = "none",
		ram_block11a_16.port_b_data_width = 1,
		ram_block11a_16.port_b_first_address = 0,
		ram_block11a_16.port_b_first_bit_number = 16,
		ram_block11a_16.port_b_last_address = 511,
		ram_block11a_16.port_b_logical_ram_depth = 512,
		ram_block11a_16.port_b_logical_ram_width = 97,
		ram_block11a_16.port_b_read_enable_clock = "clock1",
		ram_block11a_16.ram_block_type = "AUTO",
		ram_block11a_16.lpm_type = "cycloneive_ram_block";
	cycloneive_ram_block   ram_block11a_17
	( 
	.clk0(clock0),
	.clk1(clock1),
	.clr1(aclr1),
	.ena0(wren_a),
	.portaaddr({address_a_wire[8:0]}),
	.portadatain({data_a[17]}),
	.portadataout(),
	.portawe(wren_a),
	.portbaddr({address_b_wire[8:0]}),
	.portbaddrstall(addressstall_b),
	.portbdataout(wire_ram_block11a_17portbdataout[0:0]),
	.portbre(1'b1)
	`ifndef FORMAL_VERIFICATION
	// synopsys translate_off
	`endif
	,
	.clr0(1'b0),
	.ena1(1'b1),
	.ena2(1'b1),
	.ena3(1'b1),
	.portaaddrstall(1'b0),
	.portabyteenamasks({1{1'b1}}),
	.portare(1'b1),
	.portbbyteenamasks({1{1'b1}}),
	.portbdatain({1{1'b0}}),
	.portbwe(1'b0)
	`ifndef FORMAL_VERIFICATION
	// synopsys translate_on
	`endif
	// synopsys translate_off
	,
	.devclrn(1'b1),
	.devpor(1'b1)
	// synopsys translate_on
	);
	defparam
		ram_block11a_17.clk0_core_clock_enable = "ena0",
		ram_block11a_17.clk0_input_clock_enable = "none",
		ram_block11a_17.clk1_core_clock_enable = "none",
		ram_block11a_17.clk1_input_clock_enable = "none",
		ram_block11a_17.connectivity_checking = "OFF",
		ram_block11a_17.logical_ram_name = "ALTSYNCRAM",
		ram_block11a_17.mixed_port_feed_through_mode = "dont_care",
		ram_block11a_17.operation_mode = "dual_port",
		ram_block11a_17.port_a_address_width = 9,
		ram_block11a_17.port_a_data_width = 1,
		ram_block11a_17.port_a_first_address = 0,
		ram_block11a_17.port_a_first_bit_number = 17,
		ram_block11a_17.port_a_last_address = 511,
		ram_block11a_17.port_a_logical_ram_depth = 512,
		ram_block11a_17.port_a_logical_ram_width = 97,
		ram_block11a_17.port_b_address_clear = "clear1",
		ram_block11a_17.port_b_address_clock = "clock1",
		ram_block11a_17.port_b_address_width = 9,
		ram_block11a_17.port_b_data_out_clear = "none",
		ram_block11a_17.port_b_data_width = 1,
		ram_block11a_17.port_b_first_address = 0,
		ram_block11a_17.port_b_first_bit_number = 17,
		ram_block11a_17.port_b_last_address = 511,
		ram_block11a_17.port_b_logical_ram_depth = 512,
		ram_block11a_17.port_b_logical_ram_width = 97,
		ram_block11a_17.port_b_read_enable_clock = "clock1",
		ram_block11a_17.ram_block_type = "AUTO",
		ram_block11a_17.lpm_type = "cycloneive_ram_block";
	cycloneive_ram_block   ram_block11a_18
	( 
	.clk0(clock0),
	.clk1(clock1),
	.clr1(aclr1),
	.ena0(wren_a),
	.portaaddr({address_a_wire[8:0]}),
	.portadatain({data_a[18]}),
	.portadataout(),
	.portawe(wren_a),
	.portbaddr({address_b_wire[8:0]}),
	.portbaddrstall(addressstall_b),
	.portbdataout(wire_ram_block11a_18portbdataout[0:0]),
	.portbre(1'b1)
	`ifndef FORMAL_VERIFICATION
	// synopsys translate_off
	`endif
	,
	.clr0(1'b0),
	.ena1(1'b1),
	.ena2(1'b1),
	.ena3(1'b1),
	.portaaddrstall(1'b0),
	.portabyteenamasks({1{1'b1}}),
	.portare(1'b1),
	.portbbyteenamasks({1{1'b1}}),
	.portbdatain({1{1'b0}}),
	.portbwe(1'b0)
	`ifndef FORMAL_VERIFICATION
	// synopsys translate_on
	`endif
	// synopsys translate_off
	,
	.devclrn(1'b1),
	.devpor(1'b1)
	// synopsys translate_on
	);
	defparam
		ram_block11a_18.clk0_core_clock_enable = "ena0",
		ram_block11a_18.clk0_input_clock_enable = "none",
		ram_block11a_18.clk1_core_clock_enable = "none",
		ram_block11a_18.clk1_input_clock_enable = "none",
		ram_block11a_18.connectivity_checking = "OFF",
		ram_block11a_18.logical_ram_name = "ALTSYNCRAM",
		ram_block11a_18.mixed_port_feed_through_mode = "dont_care",
		ram_block11a_18.operation_mode = "dual_port",
		ram_block11a_18.port_a_address_width = 9,
		ram_block11a_18.port_a_data_width = 1,
		ram_block11a_18.port_a_first_address = 0,
		ram_block11a_18.port_a_first_bit_number = 18,
		ram_block11a_18.port_a_last_address = 511,
		ram_block11a_18.port_a_logical_ram_depth = 512,
		ram_block11a_18.port_a_logical_ram_width = 97,
		ram_block11a_18.port_b_address_clear = "clear1",
		ram_block11a_18.port_b_address_clock = "clock1",
		ram_block11a_18.port_b_address_width = 9,
		ram_block11a_18.port_b_data_out_clear = "none",
		ram_block11a_18.port_b_data_width = 1,
		ram_block11a_18.port_b_first_address = 0,
		ram_block11a_18.port_b_first_bit_number = 18,
		ram_block11a_18.port_b_last_address = 511,
		ram_block11a_18.port_b_logical_ram_depth = 512,
		ram_block11a_18.port_b_logical_ram_width = 97,
		ram_block11a_18.port_b_read_enable_clock = "clock1",
		ram_block11a_18.ram_block_type = "AUTO",
		ram_block11a_18.lpm_type = "cycloneive_ram_block";
	cycloneive_ram_block   ram_block11a_19
	( 
	.clk0(clock0),
	.clk1(clock1),
	.clr1(aclr1),
	.ena0(wren_a),
	.portaaddr({address_a_wire[8:0]}),
	.portadatain({data_a[19]}),
	.portadataout(),
	.portawe(wren_a),
	.portbaddr({address_b_wire[8:0]}),
	.portbaddrstall(addressstall_b),
	.portbdataout(wire_ram_block11a_19portbdataout[0:0]),
	.portbre(1'b1)
	`ifndef FORMAL_VERIFICATION
	// synopsys translate_off
	`endif
	,
	.clr0(1'b0),
	.ena1(1'b1),
	.ena2(1'b1),
	.ena3(1'b1),
	.portaaddrstall(1'b0),
	.portabyteenamasks({1{1'b1}}),
	.portare(1'b1),
	.portbbyteenamasks({1{1'b1}}),
	.portbdatain({1{1'b0}}),
	.portbwe(1'b0)
	`ifndef FORMAL_VERIFICATION
	// synopsys translate_on
	`endif
	// synopsys translate_off
	,
	.devclrn(1'b1),
	.devpor(1'b1)
	// synopsys translate_on
	);
	defparam
		ram_block11a_19.clk0_core_clock_enable = "ena0",
		ram_block11a_19.clk0_input_clock_enable = "none",
		ram_block11a_19.clk1_core_clock_enable = "none",
		ram_block11a_19.clk1_input_clock_enable = "none",
		ram_block11a_19.connectivity_checking = "OFF",
		ram_block11a_19.logical_ram_name = "ALTSYNCRAM",
		ram_block11a_19.mixed_port_feed_through_mode = "dont_care",
		ram_block11a_19.operation_mode = "dual_port",
		ram_block11a_19.port_a_address_width = 9,
		ram_block11a_19.port_a_data_width = 1,
		ram_block11a_19.port_a_first_address = 0,
		ram_block11a_19.port_a_first_bit_number = 19,
		ram_block11a_19.port_a_last_address = 511,
		ram_block11a_19.port_a_logical_ram_depth = 512,
		ram_block11a_19.port_a_logical_ram_width = 97,
		ram_block11a_19.port_b_address_clear = "clear1",
		ram_block11a_19.port_b_address_clock = "clock1",
		ram_block11a_19.port_b_address_width = 9,
		ram_block11a_19.port_b_data_out_clear = "none",
		ram_block11a_19.port_b_data_width = 1,
		ram_block11a_19.port_b_first_address = 0,
		ram_block11a_19.port_b_first_bit_number = 19,
		ram_block11a_19.port_b_last_address = 511,
		ram_block11a_19.port_b_logical_ram_depth = 512,
		ram_block11a_19.port_b_logical_ram_width = 97,
		ram_block11a_19.port_b_read_enable_clock = "clock1",
		ram_block11a_19.ram_block_type = "AUTO",
		ram_block11a_19.lpm_type = "cycloneive_ram_block";
	cycloneive_ram_block   ram_block11a_20
	( 
	.clk0(clock0),
	.clk1(clock1),
	.clr1(aclr1),
	.ena0(wren_a),
	.portaaddr({address_a_wire[8:0]}),
	.portadatain({data_a[20]}),
	.portadataout(),
	.portawe(wren_a),
	.portbaddr({address_b_wire[8:0]}),
	.portbaddrstall(addressstall_b),
	.portbdataout(wire_ram_block11a_20portbdataout[0:0]),
	.portbre(1'b1)
	`ifndef FORMAL_VERIFICATION
	// synopsys translate_off
	`endif
	,
	.clr0(1'b0),
	.ena1(1'b1),
	.ena2(1'b1),
	.ena3(1'b1),
	.portaaddrstall(1'b0),
	.portabyteenamasks({1{1'b1}}),
	.portare(1'b1),
	.portbbyteenamasks({1{1'b1}}),
	.portbdatain({1{1'b0}}),
	.portbwe(1'b0)
	`ifndef FORMAL_VERIFICATION
	// synopsys translate_on
	`endif
	// synopsys translate_off
	,
	.devclrn(1'b1),
	.devpor(1'b1)
	// synopsys translate_on
	);
	defparam
		ram_block11a_20.clk0_core_clock_enable = "ena0",
		ram_block11a_20.clk0_input_clock_enable = "none",
		ram_block11a_20.clk1_core_clock_enable = "none",
		ram_block11a_20.clk1_input_clock_enable = "none",
		ram_block11a_20.connectivity_checking = "OFF",
		ram_block11a_20.logical_ram_name = "ALTSYNCRAM",
		ram_block11a_20.mixed_port_feed_through_mode = "dont_care",
		ram_block11a_20.operation_mode = "dual_port",
		ram_block11a_20.port_a_address_width = 9,
		ram_block11a_20.port_a_data_width = 1,
		ram_block11a_20.port_a_first_address = 0,
		ram_block11a_20.port_a_first_bit_number = 20,
		ram_block11a_20.port_a_last_address = 511,
		ram_block11a_20.port_a_logical_ram_depth = 512,
		ram_block11a_20.port_a_logical_ram_width = 97,
		ram_block11a_20.port_b_address_clear = "clear1",
		ram_block11a_20.port_b_address_clock = "clock1",
		ram_block11a_20.port_b_address_width = 9,
		ram_block11a_20.port_b_data_out_clear = "none",
		ram_block11a_20.port_b_data_width = 1,
		ram_block11a_20.port_b_first_address = 0,
		ram_block11a_20.port_b_first_bit_number = 20,
		ram_block11a_20.port_b_last_address = 511,
		ram_block11a_20.port_b_logical_ram_depth = 512,
		ram_block11a_20.port_b_logical_ram_width = 97,
		ram_block11a_20.port_b_read_enable_clock = "clock1",
		ram_block11a_20.ram_block_type = "AUTO",
		ram_block11a_20.lpm_type = "cycloneive_ram_block";
	cycloneive_ram_block   ram_block11a_21
	( 
	.clk0(clock0),
	.clk1(clock1),
	.clr1(aclr1),
	.ena0(wren_a),
	.portaaddr({address_a_wire[8:0]}),
	.portadatain({data_a[21]}),
	.portadataout(),
	.portawe(wren_a),
	.portbaddr({address_b_wire[8:0]}),
	.portbaddrstall(addressstall_b),
	.portbdataout(wire_ram_block11a_21portbdataout[0:0]),
	.portbre(1'b1)
	`ifndef FORMAL_VERIFICATION
	// synopsys translate_off
	`endif
	,
	.clr0(1'b0),
	.ena1(1'b1),
	.ena2(1'b1),
	.ena3(1'b1),
	.portaaddrstall(1'b0),
	.portabyteenamasks({1{1'b1}}),
	.portare(1'b1),
	.portbbyteenamasks({1{1'b1}}),
	.portbdatain({1{1'b0}}),
	.portbwe(1'b0)
	`ifndef FORMAL_VERIFICATION
	// synopsys translate_on
	`endif
	// synopsys translate_off
	,
	.devclrn(1'b1),
	.devpor(1'b1)
	// synopsys translate_on
	);
	defparam
		ram_block11a_21.clk0_core_clock_enable = "ena0",
		ram_block11a_21.clk0_input_clock_enable = "none",
		ram_block11a_21.clk1_core_clock_enable = "none",
		ram_block11a_21.clk1_input_clock_enable = "none",
		ram_block11a_21.connectivity_checking = "OFF",
		ram_block11a_21.logical_ram_name = "ALTSYNCRAM",
		ram_block11a_21.mixed_port_feed_through_mode = "dont_care",
		ram_block11a_21.operation_mode = "dual_port",
		ram_block11a_21.port_a_address_width = 9,
		ram_block11a_21.port_a_data_width = 1,
		ram_block11a_21.port_a_first_address = 0,
		ram_block11a_21.port_a_first_bit_number = 21,
		ram_block11a_21.port_a_last_address = 511,
		ram_block11a_21.port_a_logical_ram_depth = 512,
		ram_block11a_21.port_a_logical_ram_width = 97,
		ram_block11a_21.port_b_address_clear = "clear1",
		ram_block11a_21.port_b_address_clock = "clock1",
		ram_block11a_21.port_b_address_width = 9,
		ram_block11a_21.port_b_data_out_clear = "none",
		ram_block11a_21.port_b_data_width = 1,
		ram_block11a_21.port_b_first_address = 0,
		ram_block11a_21.port_b_first_bit_number = 21,
		ram_block11a_21.port_b_last_address = 511,
		ram_block11a_21.port_b_logical_ram_depth = 512,
		ram_block11a_21.port_b_logical_ram_width = 97,
		ram_block11a_21.port_b_read_enable_clock = "clock1",
		ram_block11a_21.ram_block_type = "AUTO",
		ram_block11a_21.lpm_type = "cycloneive_ram_block";
	cycloneive_ram_block   ram_block11a_22
	( 
	.clk0(clock0),
	.clk1(clock1),
	.clr1(aclr1),
	.ena0(wren_a),
	.portaaddr({address_a_wire[8:0]}),
	.portadatain({data_a[22]}),
	.portadataout(),
	.portawe(wren_a),
	.portbaddr({address_b_wire[8:0]}),
	.portbaddrstall(addressstall_b),
	.portbdataout(wire_ram_block11a_22portbdataout[0:0]),
	.portbre(1'b1)
	`ifndef FORMAL_VERIFICATION
	// synopsys translate_off
	`endif
	,
	.clr0(1'b0),
	.ena1(1'b1),
	.ena2(1'b1),
	.ena3(1'b1),
	.portaaddrstall(1'b0),
	.portabyteenamasks({1{1'b1}}),
	.portare(1'b1),
	.portbbyteenamasks({1{1'b1}}),
	.portbdatain({1{1'b0}}),
	.portbwe(1'b0)
	`ifndef FORMAL_VERIFICATION
	// synopsys translate_on
	`endif
	// synopsys translate_off
	,
	.devclrn(1'b1),
	.devpor(1'b1)
	// synopsys translate_on
	);
	defparam
		ram_block11a_22.clk0_core_clock_enable = "ena0",
		ram_block11a_22.clk0_input_clock_enable = "none",
		ram_block11a_22.clk1_core_clock_enable = "none",
		ram_block11a_22.clk1_input_clock_enable = "none",
		ram_block11a_22.connectivity_checking = "OFF",
		ram_block11a_22.logical_ram_name = "ALTSYNCRAM",
		ram_block11a_22.mixed_port_feed_through_mode = "dont_care",
		ram_block11a_22.operation_mode = "dual_port",
		ram_block11a_22.port_a_address_width = 9,
		ram_block11a_22.port_a_data_width = 1,
		ram_block11a_22.port_a_first_address = 0,
		ram_block11a_22.port_a_first_bit_number = 22,
		ram_block11a_22.port_a_last_address = 511,
		ram_block11a_22.port_a_logical_ram_depth = 512,
		ram_block11a_22.port_a_logical_ram_width = 97,
		ram_block11a_22.port_b_address_clear = "clear1",
		ram_block11a_22.port_b_address_clock = "clock1",
		ram_block11a_22.port_b_address_width = 9,
		ram_block11a_22.port_b_data_out_clear = "none",
		ram_block11a_22.port_b_data_width = 1,
		ram_block11a_22.port_b_first_address = 0,
		ram_block11a_22.port_b_first_bit_number = 22,
		ram_block11a_22.port_b_last_address = 511,
		ram_block11a_22.port_b_logical_ram_depth = 512,
		ram_block11a_22.port_b_logical_ram_width = 97,
		ram_block11a_22.port_b_read_enable_clock = "clock1",
		ram_block11a_22.ram_block_type = "AUTO",
		ram_block11a_22.lpm_type = "cycloneive_ram_block";
	cycloneive_ram_block   ram_block11a_23
	( 
	.clk0(clock0),
	.clk1(clock1),
	.clr1(aclr1),
	.ena0(wren_a),
	.portaaddr({address_a_wire[8:0]}),
	.portadatain({data_a[23]}),
	.portadataout(),
	.portawe(wren_a),
	.portbaddr({address_b_wire[8:0]}),
	.portbaddrstall(addressstall_b),
	.portbdataout(wire_ram_block11a_23portbdataout[0:0]),
	.portbre(1'b1)
	`ifndef FORMAL_VERIFICATION
	// synopsys translate_off
	`endif
	,
	.clr0(1'b0),
	.ena1(1'b1),
	.ena2(1'b1),
	.ena3(1'b1),
	.portaaddrstall(1'b0),
	.portabyteenamasks({1{1'b1}}),
	.portare(1'b1),
	.portbbyteenamasks({1{1'b1}}),
	.portbdatain({1{1'b0}}),
	.portbwe(1'b0)
	`ifndef FORMAL_VERIFICATION
	// synopsys translate_on
	`endif
	// synopsys translate_off
	,
	.devclrn(1'b1),
	.devpor(1'b1)
	// synopsys translate_on
	);
	defparam
		ram_block11a_23.clk0_core_clock_enable = "ena0",
		ram_block11a_23.clk0_input_clock_enable = "none",
		ram_block11a_23.clk1_core_clock_enable = "none",
		ram_block11a_23.clk1_input_clock_enable = "none",
		ram_block11a_23.connectivity_checking = "OFF",
		ram_block11a_23.logical_ram_name = "ALTSYNCRAM",
		ram_block11a_23.mixed_port_feed_through_mode = "dont_care",
		ram_block11a_23.operation_mode = "dual_port",
		ram_block11a_23.port_a_address_width = 9,
		ram_block11a_23.port_a_data_width = 1,
		ram_block11a_23.port_a_first_address = 0,
		ram_block11a_23.port_a_first_bit_number = 23,
		ram_block11a_23.port_a_last_address = 511,
		ram_block11a_23.port_a_logical_ram_depth = 512,
		ram_block11a_23.port_a_logical_ram_width = 97,
		ram_block11a_23.port_b_address_clear = "clear1",
		ram_block11a_23.port_b_address_clock = "clock1",
		ram_block11a_23.port_b_address_width = 9,
		ram_block11a_23.port_b_data_out_clear = "none",
		ram_block11a_23.port_b_data_width = 1,
		ram_block11a_23.port_b_first_address = 0,
		ram_block11a_23.port_b_first_bit_number = 23,
		ram_block11a_23.port_b_last_address = 511,
		ram_block11a_23.port_b_logical_ram_depth = 512,
		ram_block11a_23.port_b_logical_ram_width = 97,
		ram_block11a_23.port_b_read_enable_clock = "clock1",
		ram_block11a_23.ram_block_type = "AUTO",
		ram_block11a_23.lpm_type = "cycloneive_ram_block";
	cycloneive_ram_block   ram_block11a_24
	( 
	.clk0(clock0),
	.clk1(clock1),
	.clr1(aclr1),
	.ena0(wren_a),
	.portaaddr({address_a_wire[8:0]}),
	.portadatain({data_a[24]}),
	.portadataout(),
	.portawe(wren_a),
	.portbaddr({address_b_wire[8:0]}),
	.portbaddrstall(addressstall_b),
	.portbdataout(wire_ram_block11a_24portbdataout[0:0]),
	.portbre(1'b1)
	`ifndef FORMAL_VERIFICATION
	// synopsys translate_off
	`endif
	,
	.clr0(1'b0),
	.ena1(1'b1),
	.ena2(1'b1),
	.ena3(1'b1),
	.portaaddrstall(1'b0),
	.portabyteenamasks({1{1'b1}}),
	.portare(1'b1),
	.portbbyteenamasks({1{1'b1}}),
	.portbdatain({1{1'b0}}),
	.portbwe(1'b0)
	`ifndef FORMAL_VERIFICATION
	// synopsys translate_on
	`endif
	// synopsys translate_off
	,
	.devclrn(1'b1),
	.devpor(1'b1)
	// synopsys translate_on
	);
	defparam
		ram_block11a_24.clk0_core_clock_enable = "ena0",
		ram_block11a_24.clk0_input_clock_enable = "none",
		ram_block11a_24.clk1_core_clock_enable = "none",
		ram_block11a_24.clk1_input_clock_enable = "none",
		ram_block11a_24.connectivity_checking = "OFF",
		ram_block11a_24.logical_ram_name = "ALTSYNCRAM",
		ram_block11a_24.mixed_port_feed_through_mode = "dont_care",
		ram_block11a_24.operation_mode = "dual_port",
		ram_block11a_24.port_a_address_width = 9,
		ram_block11a_24.port_a_data_width = 1,
		ram_block11a_24.port_a_first_address = 0,
		ram_block11a_24.port_a_first_bit_number = 24,
		ram_block11a_24.port_a_last_address = 511,
		ram_block11a_24.port_a_logical_ram_depth = 512,
		ram_block11a_24.port_a_logical_ram_width = 97,
		ram_block11a_24.port_b_address_clear = "clear1",
		ram_block11a_24.port_b_address_clock = "clock1",
		ram_block11a_24.port_b_address_width = 9,
		ram_block11a_24.port_b_data_out_clear = "none",
		ram_block11a_24.port_b_data_width = 1,
		ram_block11a_24.port_b_first_address = 0,
		ram_block11a_24.port_b_first_bit_number = 24,
		ram_block11a_24.port_b_last_address = 511,
		ram_block11a_24.port_b_logical_ram_depth = 512,
		ram_block11a_24.port_b_logical_ram_width = 97,
		ram_block11a_24.port_b_read_enable_clock = "clock1",
		ram_block11a_24.ram_block_type = "AUTO",
		ram_block11a_24.lpm_type = "cycloneive_ram_block";
	cycloneive_ram_block   ram_block11a_25
	( 
	.clk0(clock0),
	.clk1(clock1),
	.clr1(aclr1),
	.ena0(wren_a),
	.portaaddr({address_a_wire[8:0]}),
	.portadatain({data_a[25]}),
	.portadataout(),
	.portawe(wren_a),
	.portbaddr({address_b_wire[8:0]}),
	.portbaddrstall(addressstall_b),
	.portbdataout(wire_ram_block11a_25portbdataout[0:0]),
	.portbre(1'b1)
	`ifndef FORMAL_VERIFICATION
	// synopsys translate_off
	`endif
	,
	.clr0(1'b0),
	.ena1(1'b1),
	.ena2(1'b1),
	.ena3(1'b1),
	.portaaddrstall(1'b0),
	.portabyteenamasks({1{1'b1}}),
	.portare(1'b1),
	.portbbyteenamasks({1{1'b1}}),
	.portbdatain({1{1'b0}}),
	.portbwe(1'b0)
	`ifndef FORMAL_VERIFICATION
	// synopsys translate_on
	`endif
	// synopsys translate_off
	,
	.devclrn(1'b1),
	.devpor(1'b1)
	// synopsys translate_on
	);
	defparam
		ram_block11a_25.clk0_core_clock_enable = "ena0",
		ram_block11a_25.clk0_input_clock_enable = "none",
		ram_block11a_25.clk1_core_clock_enable = "none",
		ram_block11a_25.clk1_input_clock_enable = "none",
		ram_block11a_25.connectivity_checking = "OFF",
		ram_block11a_25.logical_ram_name = "ALTSYNCRAM",
		ram_block11a_25.mixed_port_feed_through_mode = "dont_care",
		ram_block11a_25.operation_mode = "dual_port",
		ram_block11a_25.port_a_address_width = 9,
		ram_block11a_25.port_a_data_width = 1,
		ram_block11a_25.port_a_first_address = 0,
		ram_block11a_25.port_a_first_bit_number = 25,
		ram_block11a_25.port_a_last_address = 511,
		ram_block11a_25.port_a_logical_ram_depth = 512,
		ram_block11a_25.port_a_logical_ram_width = 97,
		ram_block11a_25.port_b_address_clear = "clear1",
		ram_block11a_25.port_b_address_clock = "clock1",
		ram_block11a_25.port_b_address_width = 9,
		ram_block11a_25.port_b_data_out_clear = "none",
		ram_block11a_25.port_b_data_width = 1,
		ram_block11a_25.port_b_first_address = 0,
		ram_block11a_25.port_b_first_bit_number = 25,
		ram_block11a_25.port_b_last_address = 511,
		ram_block11a_25.port_b_logical_ram_depth = 512,
		ram_block11a_25.port_b_logical_ram_width = 97,
		ram_block11a_25.port_b_read_enable_clock = "clock1",
		ram_block11a_25.ram_block_type = "AUTO",
		ram_block11a_25.lpm_type = "cycloneive_ram_block";
	cycloneive_ram_block   ram_block11a_26
	( 
	.clk0(clock0),
	.clk1(clock1),
	.clr1(aclr1),
	.ena0(wren_a),
	.portaaddr({address_a_wire[8:0]}),
	.portadatain({data_a[26]}),
	.portadataout(),
	.portawe(wren_a),
	.portbaddr({address_b_wire[8:0]}),
	.portbaddrstall(addressstall_b),
	.portbdataout(wire_ram_block11a_26portbdataout[0:0]),
	.portbre(1'b1)
	`ifndef FORMAL_VERIFICATION
	// synopsys translate_off
	`endif
	,
	.clr0(1'b0),
	.ena1(1'b1),
	.ena2(1'b1),
	.ena3(1'b1),
	.portaaddrstall(1'b0),
	.portabyteenamasks({1{1'b1}}),
	.portare(1'b1),
	.portbbyteenamasks({1{1'b1}}),
	.portbdatain({1{1'b0}}),
	.portbwe(1'b0)
	`ifndef FORMAL_VERIFICATION
	// synopsys translate_on
	`endif
	// synopsys translate_off
	,
	.devclrn(1'b1),
	.devpor(1'b1)
	// synopsys translate_on
	);
	defparam
		ram_block11a_26.clk0_core_clock_enable = "ena0",
		ram_block11a_26.clk0_input_clock_enable = "none",
		ram_block11a_26.clk1_core_clock_enable = "none",
		ram_block11a_26.clk1_input_clock_enable = "none",
		ram_block11a_26.connectivity_checking = "OFF",
		ram_block11a_26.logical_ram_name = "ALTSYNCRAM",
		ram_block11a_26.mixed_port_feed_through_mode = "dont_care",
		ram_block11a_26.operation_mode = "dual_port",
		ram_block11a_26.port_a_address_width = 9,
		ram_block11a_26.port_a_data_width = 1,
		ram_block11a_26.port_a_first_address = 0,
		ram_block11a_26.port_a_first_bit_number = 26,
		ram_block11a_26.port_a_last_address = 511,
		ram_block11a_26.port_a_logical_ram_depth = 512,
		ram_block11a_26.port_a_logical_ram_width = 97,
		ram_block11a_26.port_b_address_clear = "clear1",
		ram_block11a_26.port_b_address_clock = "clock1",
		ram_block11a_26.port_b_address_width = 9,
		ram_block11a_26.port_b_data_out_clear = "none",
		ram_block11a_26.port_b_data_width = 1,
		ram_block11a_26.port_b_first_address = 0,
		ram_block11a_26.port_b_first_bit_number = 26,
		ram_block11a_26.port_b_last_address = 511,
		ram_block11a_26.port_b_logical_ram_depth = 512,
		ram_block11a_26.port_b_logical_ram_width = 97,
		ram_block11a_26.port_b_read_enable_clock = "clock1",
		ram_block11a_26.ram_block_type = "AUTO",
		ram_block11a_26.lpm_type = "cycloneive_ram_block";
	cycloneive_ram_block   ram_block11a_27
	( 
	.clk0(clock0),
	.clk1(clock1),
	.clr1(aclr1),
	.ena0(wren_a),
	.portaaddr({address_a_wire[8:0]}),
	.portadatain({data_a[27]}),
	.portadataout(),
	.portawe(wren_a),
	.portbaddr({address_b_wire[8:0]}),
	.portbaddrstall(addressstall_b),
	.portbdataout(wire_ram_block11a_27portbdataout[0:0]),
	.portbre(1'b1)
	`ifndef FORMAL_VERIFICATION
	// synopsys translate_off
	`endif
	,
	.clr0(1'b0),
	.ena1(1'b1),
	.ena2(1'b1),
	.ena3(1'b1),
	.portaaddrstall(1'b0),
	.portabyteenamasks({1{1'b1}}),
	.portare(1'b1),
	.portbbyteenamasks({1{1'b1}}),
	.portbdatain({1{1'b0}}),
	.portbwe(1'b0)
	`ifndef FORMAL_VERIFICATION
	// synopsys translate_on
	`endif
	// synopsys translate_off
	,
	.devclrn(1'b1),
	.devpor(1'b1)
	// synopsys translate_on
	);
	defparam
		ram_block11a_27.clk0_core_clock_enable = "ena0",
		ram_block11a_27.clk0_input_clock_enable = "none",
		ram_block11a_27.clk1_core_clock_enable = "none",
		ram_block11a_27.clk1_input_clock_enable = "none",
		ram_block11a_27.connectivity_checking = "OFF",
		ram_block11a_27.logical_ram_name = "ALTSYNCRAM",
		ram_block11a_27.mixed_port_feed_through_mode = "dont_care",
		ram_block11a_27.operation_mode = "dual_port",
		ram_block11a_27.port_a_address_width = 9,
		ram_block11a_27.port_a_data_width = 1,
		ram_block11a_27.port_a_first_address = 0,
		ram_block11a_27.port_a_first_bit_number = 27,
		ram_block11a_27.port_a_last_address = 511,
		ram_block11a_27.port_a_logical_ram_depth = 512,
		ram_block11a_27.port_a_logical_ram_width = 97,
		ram_block11a_27.port_b_address_clear = "clear1",
		ram_block11a_27.port_b_address_clock = "clock1",
		ram_block11a_27.port_b_address_width = 9,
		ram_block11a_27.port_b_data_out_clear = "none",
		ram_block11a_27.port_b_data_width = 1,
		ram_block11a_27.port_b_first_address = 0,
		ram_block11a_27.port_b_first_bit_number = 27,
		ram_block11a_27.port_b_last_address = 511,
		ram_block11a_27.port_b_logical_ram_depth = 512,
		ram_block11a_27.port_b_logical_ram_width = 97,
		ram_block11a_27.port_b_read_enable_clock = "clock1",
		ram_block11a_27.ram_block_type = "AUTO",
		ram_block11a_27.lpm_type = "cycloneive_ram_block";
	cycloneive_ram_block   ram_block11a_28
	( 
	.clk0(clock0),
	.clk1(clock1),
	.clr1(aclr1),
	.ena0(wren_a),
	.portaaddr({address_a_wire[8:0]}),
	.portadatain({data_a[28]}),
	.portadataout(),
	.portawe(wren_a),
	.portbaddr({address_b_wire[8:0]}),
	.portbaddrstall(addressstall_b),
	.portbdataout(wire_ram_block11a_28portbdataout[0:0]),
	.portbre(1'b1)
	`ifndef FORMAL_VERIFICATION
	// synopsys translate_off
	`endif
	,
	.clr0(1'b0),
	.ena1(1'b1),
	.ena2(1'b1),
	.ena3(1'b1),
	.portaaddrstall(1'b0),
	.portabyteenamasks({1{1'b1}}),
	.portare(1'b1),
	.portbbyteenamasks({1{1'b1}}),
	.portbdatain({1{1'b0}}),
	.portbwe(1'b0)
	`ifndef FORMAL_VERIFICATION
	// synopsys translate_on
	`endif
	// synopsys translate_off
	,
	.devclrn(1'b1),
	.devpor(1'b1)
	// synopsys translate_on
	);
	defparam
		ram_block11a_28.clk0_core_clock_enable = "ena0",
		ram_block11a_28.clk0_input_clock_enable = "none",
		ram_block11a_28.clk1_core_clock_enable = "none",
		ram_block11a_28.clk1_input_clock_enable = "none",
		ram_block11a_28.connectivity_checking = "OFF",
		ram_block11a_28.logical_ram_name = "ALTSYNCRAM",
		ram_block11a_28.mixed_port_feed_through_mode = "dont_care",
		ram_block11a_28.operation_mode = "dual_port",
		ram_block11a_28.port_a_address_width = 9,
		ram_block11a_28.port_a_data_width = 1,
		ram_block11a_28.port_a_first_address = 0,
		ram_block11a_28.port_a_first_bit_number = 28,
		ram_block11a_28.port_a_last_address = 511,
		ram_block11a_28.port_a_logical_ram_depth = 512,
		ram_block11a_28.port_a_logical_ram_width = 97,
		ram_block11a_28.port_b_address_clear = "clear1",
		ram_block11a_28.port_b_address_clock = "clock1",
		ram_block11a_28.port_b_address_width = 9,
		ram_block11a_28.port_b_data_out_clear = "none",
		ram_block11a_28.port_b_data_width = 1,
		ram_block11a_28.port_b_first_address = 0,
		ram_block11a_28.port_b_first_bit_number = 28,
		ram_block11a_28.port_b_last_address = 511,
		ram_block11a_28.port_b_logical_ram_depth = 512,
		ram_block11a_28.port_b_logical_ram_width = 97,
		ram_block11a_28.port_b_read_enable_clock = "clock1",
		ram_block11a_28.ram_block_type = "AUTO",
		ram_block11a_28.lpm_type = "cycloneive_ram_block";
	cycloneive_ram_block   ram_block11a_29
	( 
	.clk0(clock0),
	.clk1(clock1),
	.clr1(aclr1),
	.ena0(wren_a),
	.portaaddr({address_a_wire[8:0]}),
	.portadatain({data_a[29]}),
	.portadataout(),
	.portawe(wren_a),
	.portbaddr({address_b_wire[8:0]}),
	.portbaddrstall(addressstall_b),
	.portbdataout(wire_ram_block11a_29portbdataout[0:0]),
	.portbre(1'b1)
	`ifndef FORMAL_VERIFICATION
	// synopsys translate_off
	`endif
	,
	.clr0(1'b0),
	.ena1(1'b1),
	.ena2(1'b1),
	.ena3(1'b1),
	.portaaddrstall(1'b0),
	.portabyteenamasks({1{1'b1}}),
	.portare(1'b1),
	.portbbyteenamasks({1{1'b1}}),
	.portbdatain({1{1'b0}}),
	.portbwe(1'b0)
	`ifndef FORMAL_VERIFICATION
	// synopsys translate_on
	`endif
	// synopsys translate_off
	,
	.devclrn(1'b1),
	.devpor(1'b1)
	// synopsys translate_on
	);
	defparam
		ram_block11a_29.clk0_core_clock_enable = "ena0",
		ram_block11a_29.clk0_input_clock_enable = "none",
		ram_block11a_29.clk1_core_clock_enable = "none",
		ram_block11a_29.clk1_input_clock_enable = "none",
		ram_block11a_29.connectivity_checking = "OFF",
		ram_block11a_29.logical_ram_name = "ALTSYNCRAM",
		ram_block11a_29.mixed_port_feed_through_mode = "dont_care",
		ram_block11a_29.operation_mode = "dual_port",
		ram_block11a_29.port_a_address_width = 9,
		ram_block11a_29.port_a_data_width = 1,
		ram_block11a_29.port_a_first_address = 0,
		ram_block11a_29.port_a_first_bit_number = 29,
		ram_block11a_29.port_a_last_address = 511,
		ram_block11a_29.port_a_logical_ram_depth = 512,
		ram_block11a_29.port_a_logical_ram_width = 97,
		ram_block11a_29.port_b_address_clear = "clear1",
		ram_block11a_29.port_b_address_clock = "clock1",
		ram_block11a_29.port_b_address_width = 9,
		ram_block11a_29.port_b_data_out_clear = "none",
		ram_block11a_29.port_b_data_width = 1,
		ram_block11a_29.port_b_first_address = 0,
		ram_block11a_29.port_b_first_bit_number = 29,
		ram_block11a_29.port_b_last_address = 511,
		ram_block11a_29.port_b_logical_ram_depth = 512,
		ram_block11a_29.port_b_logical_ram_width = 97,
		ram_block11a_29.port_b_read_enable_clock = "clock1",
		ram_block11a_29.ram_block_type = "AUTO",
		ram_block11a_29.lpm_type = "cycloneive_ram_block";
	cycloneive_ram_block   ram_block11a_30
	( 
	.clk0(clock0),
	.clk1(clock1),
	.clr1(aclr1),
	.ena0(wren_a),
	.portaaddr({address_a_wire[8:0]}),
	.portadatain({data_a[30]}),
	.portadataout(),
	.portawe(wren_a),
	.portbaddr({address_b_wire[8:0]}),
	.portbaddrstall(addressstall_b),
	.portbdataout(wire_ram_block11a_30portbdataout[0:0]),
	.portbre(1'b1)
	`ifndef FORMAL_VERIFICATION
	// synopsys translate_off
	`endif
	,
	.clr0(1'b0),
	.ena1(1'b1),
	.ena2(1'b1),
	.ena3(1'b1),
	.portaaddrstall(1'b0),
	.portabyteenamasks({1{1'b1}}),
	.portare(1'b1),
	.portbbyteenamasks({1{1'b1}}),
	.portbdatain({1{1'b0}}),
	.portbwe(1'b0)
	`ifndef FORMAL_VERIFICATION
	// synopsys translate_on
	`endif
	// synopsys translate_off
	,
	.devclrn(1'b1),
	.devpor(1'b1)
	// synopsys translate_on
	);
	defparam
		ram_block11a_30.clk0_core_clock_enable = "ena0",
		ram_block11a_30.clk0_input_clock_enable = "none",
		ram_block11a_30.clk1_core_clock_enable = "none",
		ram_block11a_30.clk1_input_clock_enable = "none",
		ram_block11a_30.connectivity_checking = "OFF",
		ram_block11a_30.logical_ram_name = "ALTSYNCRAM",
		ram_block11a_30.mixed_port_feed_through_mode = "dont_care",
		ram_block11a_30.operation_mode = "dual_port",
		ram_block11a_30.port_a_address_width = 9,
		ram_block11a_30.port_a_data_width = 1,
		ram_block11a_30.port_a_first_address = 0,
		ram_block11a_30.port_a_first_bit_number = 30,
		ram_block11a_30.port_a_last_address = 511,
		ram_block11a_30.port_a_logical_ram_depth = 512,
		ram_block11a_30.port_a_logical_ram_width = 97,
		ram_block11a_30.port_b_address_clear = "clear1",
		ram_block11a_30.port_b_address_clock = "clock1",
		ram_block11a_30.port_b_address_width = 9,
		ram_block11a_30.port_b_data_out_clear = "none",
		ram_block11a_30.port_b_data_width = 1,
		ram_block11a_30.port_b_first_address = 0,
		ram_block11a_30.port_b_first_bit_number = 30,
		ram_block11a_30.port_b_last_address = 511,
		ram_block11a_30.port_b_logical_ram_depth = 512,
		ram_block11a_30.port_b_logical_ram_width = 97,
		ram_block11a_30.port_b_read_enable_clock = "clock1",
		ram_block11a_30.ram_block_type = "AUTO",
		ram_block11a_30.lpm_type = "cycloneive_ram_block";
	cycloneive_ram_block   ram_block11a_31
	( 
	.clk0(clock0),
	.clk1(clock1),
	.clr1(aclr1),
	.ena0(wren_a),
	.portaaddr({address_a_wire[8:0]}),
	.portadatain({data_a[31]}),
	.portadataout(),
	.portawe(wren_a),
	.portbaddr({address_b_wire[8:0]}),
	.portbaddrstall(addressstall_b),
	.portbdataout(wire_ram_block11a_31portbdataout[0:0]),
	.portbre(1'b1)
	`ifndef FORMAL_VERIFICATION
	// synopsys translate_off
	`endif
	,
	.clr0(1'b0),
	.ena1(1'b1),
	.ena2(1'b1),
	.ena3(1'b1),
	.portaaddrstall(1'b0),
	.portabyteenamasks({1{1'b1}}),
	.portare(1'b1),
	.portbbyteenamasks({1{1'b1}}),
	.portbdatain({1{1'b0}}),
	.portbwe(1'b0)
	`ifndef FORMAL_VERIFICATION
	// synopsys translate_on
	`endif
	// synopsys translate_off
	,
	.devclrn(1'b1),
	.devpor(1'b1)
	// synopsys translate_on
	);
	defparam
		ram_block11a_31.clk0_core_clock_enable = "ena0",
		ram_block11a_31.clk0_input_clock_enable = "none",
		ram_block11a_31.clk1_core_clock_enable = "none",
		ram_block11a_31.clk1_input_clock_enable = "none",
		ram_block11a_31.connectivity_checking = "OFF",
		ram_block11a_31.logical_ram_name = "ALTSYNCRAM",
		ram_block11a_31.mixed_port_feed_through_mode = "dont_care",
		ram_block11a_31.operation_mode = "dual_port",
		ram_block11a_31.port_a_address_width = 9,
		ram_block11a_31.port_a_data_width = 1,
		ram_block11a_31.port_a_first_address = 0,
		ram_block11a_31.port_a_first_bit_number = 31,
		ram_block11a_31.port_a_last_address = 511,
		ram_block11a_31.port_a_logical_ram_depth = 512,
		ram_block11a_31.port_a_logical_ram_width = 97,
		ram_block11a_31.port_b_address_clear = "clear1",
		ram_block11a_31.port_b_address_clock = "clock1",
		ram_block11a_31.port_b_address_width = 9,
		ram_block11a_31.port_b_data_out_clear = "none",
		ram_block11a_31.port_b_data_width = 1,
		ram_block11a_31.port_b_first_address = 0,
		ram_block11a_31.port_b_first_bit_number = 31,
		ram_block11a_31.port_b_last_address = 511,
		ram_block11a_31.port_b_logical_ram_depth = 512,
		ram_block11a_31.port_b_logical_ram_width = 97,
		ram_block11a_31.port_b_read_enable_clock = "clock1",
		ram_block11a_31.ram_block_type = "AUTO",
		ram_block11a_31.lpm_type = "cycloneive_ram_block";
	cycloneive_ram_block   ram_block11a_32
	( 
	.clk0(clock0),
	.clk1(clock1),
	.clr1(aclr1),
	.ena0(wren_a),
	.portaaddr({address_a_wire[8:0]}),
	.portadatain({data_a[32]}),
	.portadataout(),
	.portawe(wren_a),
	.portbaddr({address_b_wire[8:0]}),
	.portbaddrstall(addressstall_b),
	.portbdataout(wire_ram_block11a_32portbdataout[0:0]),
	.portbre(1'b1)
	`ifndef FORMAL_VERIFICATION
	// synopsys translate_off
	`endif
	,
	.clr0(1'b0),
	.ena1(1'b1),
	.ena2(1'b1),
	.ena3(1'b1),
	.portaaddrstall(1'b0),
	.portabyteenamasks({1{1'b1}}),
	.portare(1'b1),
	.portbbyteenamasks({1{1'b1}}),
	.portbdatain({1{1'b0}}),
	.portbwe(1'b0)
	`ifndef FORMAL_VERIFICATION
	// synopsys translate_on
	`endif
	// synopsys translate_off
	,
	.devclrn(1'b1),
	.devpor(1'b1)
	// synopsys translate_on
	);
	defparam
		ram_block11a_32.clk0_core_clock_enable = "ena0",
		ram_block11a_32.clk0_input_clock_enable = "none",
		ram_block11a_32.clk1_core_clock_enable = "none",
		ram_block11a_32.clk1_input_clock_enable = "none",
		ram_block11a_32.connectivity_checking = "OFF",
		ram_block11a_32.logical_ram_name = "ALTSYNCRAM",
		ram_block11a_32.mixed_port_feed_through_mode = "dont_care",
		ram_block11a_32.operation_mode = "dual_port",
		ram_block11a_32.port_a_address_width = 9,
		ram_block11a_32.port_a_data_width = 1,
		ram_block11a_32.port_a_first_address = 0,
		ram_block11a_32.port_a_first_bit_number = 32,
		ram_block11a_32.port_a_last_address = 511,
		ram_block11a_32.port_a_logical_ram_depth = 512,
		ram_block11a_32.port_a_logical_ram_width = 97,
		ram_block11a_32.port_b_address_clear = "clear1",
		ram_block11a_32.port_b_address_clock = "clock1",
		ram_block11a_32.port_b_address_width = 9,
		ram_block11a_32.port_b_data_out_clear = "none",
		ram_block11a_32.port_b_data_width = 1,
		ram_block11a_32.port_b_first_address = 0,
		ram_block11a_32.port_b_first_bit_number = 32,
		ram_block11a_32.port_b_last_address = 511,
		ram_block11a_32.port_b_logical_ram_depth = 512,
		ram_block11a_32.port_b_logical_ram_width = 97,
		ram_block11a_32.port_b_read_enable_clock = "clock1",
		ram_block11a_32.ram_block_type = "AUTO",
		ram_block11a_32.lpm_type = "cycloneive_ram_block";
	cycloneive_ram_block   ram_block11a_33
	( 
	.clk0(clock0),
	.clk1(clock1),
	.clr1(aclr1),
	.ena0(wren_a),
	.portaaddr({address_a_wire[8:0]}),
	.portadatain({data_a[33]}),
	.portadataout(),
	.portawe(wren_a),
	.portbaddr({address_b_wire[8:0]}),
	.portbaddrstall(addressstall_b),
	.portbdataout(wire_ram_block11a_33portbdataout[0:0]),
	.portbre(1'b1)
	`ifndef FORMAL_VERIFICATION
	// synopsys translate_off
	`endif
	,
	.clr0(1'b0),
	.ena1(1'b1),
	.ena2(1'b1),
	.ena3(1'b1),
	.portaaddrstall(1'b0),
	.portabyteenamasks({1{1'b1}}),
	.portare(1'b1),
	.portbbyteenamasks({1{1'b1}}),
	.portbdatain({1{1'b0}}),
	.portbwe(1'b0)
	`ifndef FORMAL_VERIFICATION
	// synopsys translate_on
	`endif
	// synopsys translate_off
	,
	.devclrn(1'b1),
	.devpor(1'b1)
	// synopsys translate_on
	);
	defparam
		ram_block11a_33.clk0_core_clock_enable = "ena0",
		ram_block11a_33.clk0_input_clock_enable = "none",
		ram_block11a_33.clk1_core_clock_enable = "none",
		ram_block11a_33.clk1_input_clock_enable = "none",
		ram_block11a_33.connectivity_checking = "OFF",
		ram_block11a_33.logical_ram_name = "ALTSYNCRAM",
		ram_block11a_33.mixed_port_feed_through_mode = "dont_care",
		ram_block11a_33.operation_mode = "dual_port",
		ram_block11a_33.port_a_address_width = 9,
		ram_block11a_33.port_a_data_width = 1,
		ram_block11a_33.port_a_first_address = 0,
		ram_block11a_33.port_a_first_bit_number = 33,
		ram_block11a_33.port_a_last_address = 511,
		ram_block11a_33.port_a_logical_ram_depth = 512,
		ram_block11a_33.port_a_logical_ram_width = 97,
		ram_block11a_33.port_b_address_clear = "clear1",
		ram_block11a_33.port_b_address_clock = "clock1",
		ram_block11a_33.port_b_address_width = 9,
		ram_block11a_33.port_b_data_out_clear = "none",
		ram_block11a_33.port_b_data_width = 1,
		ram_block11a_33.port_b_first_address = 0,
		ram_block11a_33.port_b_first_bit_number = 33,
		ram_block11a_33.port_b_last_address = 511,
		ram_block11a_33.port_b_logical_ram_depth = 512,
		ram_block11a_33.port_b_logical_ram_width = 97,
		ram_block11a_33.port_b_read_enable_clock = "clock1",
		ram_block11a_33.ram_block_type = "AUTO",
		ram_block11a_33.lpm_type = "cycloneive_ram_block";
	cycloneive_ram_block   ram_block11a_34
	( 
	.clk0(clock0),
	.clk1(clock1),
	.clr1(aclr1),
	.ena0(wren_a),
	.portaaddr({address_a_wire[8:0]}),
	.portadatain({data_a[34]}),
	.portadataout(),
	.portawe(wren_a),
	.portbaddr({address_b_wire[8:0]}),
	.portbaddrstall(addressstall_b),
	.portbdataout(wire_ram_block11a_34portbdataout[0:0]),
	.portbre(1'b1)
	`ifndef FORMAL_VERIFICATION
	// synopsys translate_off
	`endif
	,
	.clr0(1'b0),
	.ena1(1'b1),
	.ena2(1'b1),
	.ena3(1'b1),
	.portaaddrstall(1'b0),
	.portabyteenamasks({1{1'b1}}),
	.portare(1'b1),
	.portbbyteenamasks({1{1'b1}}),
	.portbdatain({1{1'b0}}),
	.portbwe(1'b0)
	`ifndef FORMAL_VERIFICATION
	// synopsys translate_on
	`endif
	// synopsys translate_off
	,
	.devclrn(1'b1),
	.devpor(1'b1)
	// synopsys translate_on
	);
	defparam
		ram_block11a_34.clk0_core_clock_enable = "ena0",
		ram_block11a_34.clk0_input_clock_enable = "none",
		ram_block11a_34.clk1_core_clock_enable = "none",
		ram_block11a_34.clk1_input_clock_enable = "none",
		ram_block11a_34.connectivity_checking = "OFF",
		ram_block11a_34.logical_ram_name = "ALTSYNCRAM",
		ram_block11a_34.mixed_port_feed_through_mode = "dont_care",
		ram_block11a_34.operation_mode = "dual_port",
		ram_block11a_34.port_a_address_width = 9,
		ram_block11a_34.port_a_data_width = 1,
		ram_block11a_34.port_a_first_address = 0,
		ram_block11a_34.port_a_first_bit_number = 34,
		ram_block11a_34.port_a_last_address = 511,
		ram_block11a_34.port_a_logical_ram_depth = 512,
		ram_block11a_34.port_a_logical_ram_width = 97,
		ram_block11a_34.port_b_address_clear = "clear1",
		ram_block11a_34.port_b_address_clock = "clock1",
		ram_block11a_34.port_b_address_width = 9,
		ram_block11a_34.port_b_data_out_clear = "none",
		ram_block11a_34.port_b_data_width = 1,
		ram_block11a_34.port_b_first_address = 0,
		ram_block11a_34.port_b_first_bit_number = 34,
		ram_block11a_34.port_b_last_address = 511,
		ram_block11a_34.port_b_logical_ram_depth = 512,
		ram_block11a_34.port_b_logical_ram_width = 97,
		ram_block11a_34.port_b_read_enable_clock = "clock1",
		ram_block11a_34.ram_block_type = "AUTO",
		ram_block11a_34.lpm_type = "cycloneive_ram_block";
	cycloneive_ram_block   ram_block11a_35
	( 
	.clk0(clock0),
	.clk1(clock1),
	.clr1(aclr1),
	.ena0(wren_a),
	.portaaddr({address_a_wire[8:0]}),
	.portadatain({data_a[35]}),
	.portadataout(),
	.portawe(wren_a),
	.portbaddr({address_b_wire[8:0]}),
	.portbaddrstall(addressstall_b),
	.portbdataout(wire_ram_block11a_35portbdataout[0:0]),
	.portbre(1'b1)
	`ifndef FORMAL_VERIFICATION
	// synopsys translate_off
	`endif
	,
	.clr0(1'b0),
	.ena1(1'b1),
	.ena2(1'b1),
	.ena3(1'b1),
	.portaaddrstall(1'b0),
	.portabyteenamasks({1{1'b1}}),
	.portare(1'b1),
	.portbbyteenamasks({1{1'b1}}),
	.portbdatain({1{1'b0}}),
	.portbwe(1'b0)
	`ifndef FORMAL_VERIFICATION
	// synopsys translate_on
	`endif
	// synopsys translate_off
	,
	.devclrn(1'b1),
	.devpor(1'b1)
	// synopsys translate_on
	);
	defparam
		ram_block11a_35.clk0_core_clock_enable = "ena0",
		ram_block11a_35.clk0_input_clock_enable = "none",
		ram_block11a_35.clk1_core_clock_enable = "none",
		ram_block11a_35.clk1_input_clock_enable = "none",
		ram_block11a_35.connectivity_checking = "OFF",
		ram_block11a_35.logical_ram_name = "ALTSYNCRAM",
		ram_block11a_35.mixed_port_feed_through_mode = "dont_care",
		ram_block11a_35.operation_mode = "dual_port",
		ram_block11a_35.port_a_address_width = 9,
		ram_block11a_35.port_a_data_width = 1,
		ram_block11a_35.port_a_first_address = 0,
		ram_block11a_35.port_a_first_bit_number = 35,
		ram_block11a_35.port_a_last_address = 511,
		ram_block11a_35.port_a_logical_ram_depth = 512,
		ram_block11a_35.port_a_logical_ram_width = 97,
		ram_block11a_35.port_b_address_clear = "clear1",
		ram_block11a_35.port_b_address_clock = "clock1",
		ram_block11a_35.port_b_address_width = 9,
		ram_block11a_35.port_b_data_out_clear = "none",
		ram_block11a_35.port_b_data_width = 1,
		ram_block11a_35.port_b_first_address = 0,
		ram_block11a_35.port_b_first_bit_number = 35,
		ram_block11a_35.port_b_last_address = 511,
		ram_block11a_35.port_b_logical_ram_depth = 512,
		ram_block11a_35.port_b_logical_ram_width = 97,
		ram_block11a_35.port_b_read_enable_clock = "clock1",
		ram_block11a_35.ram_block_type = "AUTO",
		ram_block11a_35.lpm_type = "cycloneive_ram_block";
	cycloneive_ram_block   ram_block11a_36
	( 
	.clk0(clock0),
	.clk1(clock1),
	.clr1(aclr1),
	.ena0(wren_a),
	.portaaddr({address_a_wire[8:0]}),
	.portadatain({data_a[36]}),
	.portadataout(),
	.portawe(wren_a),
	.portbaddr({address_b_wire[8:0]}),
	.portbaddrstall(addressstall_b),
	.portbdataout(wire_ram_block11a_36portbdataout[0:0]),
	.portbre(1'b1)
	`ifndef FORMAL_VERIFICATION
	// synopsys translate_off
	`endif
	,
	.clr0(1'b0),
	.ena1(1'b1),
	.ena2(1'b1),
	.ena3(1'b1),
	.portaaddrstall(1'b0),
	.portabyteenamasks({1{1'b1}}),
	.portare(1'b1),
	.portbbyteenamasks({1{1'b1}}),
	.portbdatain({1{1'b0}}),
	.portbwe(1'b0)
	`ifndef FORMAL_VERIFICATION
	// synopsys translate_on
	`endif
	// synopsys translate_off
	,
	.devclrn(1'b1),
	.devpor(1'b1)
	// synopsys translate_on
	);
	defparam
		ram_block11a_36.clk0_core_clock_enable = "ena0",
		ram_block11a_36.clk0_input_clock_enable = "none",
		ram_block11a_36.clk1_core_clock_enable = "none",
		ram_block11a_36.clk1_input_clock_enable = "none",
		ram_block11a_36.connectivity_checking = "OFF",
		ram_block11a_36.logical_ram_name = "ALTSYNCRAM",
		ram_block11a_36.mixed_port_feed_through_mode = "dont_care",
		ram_block11a_36.operation_mode = "dual_port",
		ram_block11a_36.port_a_address_width = 9,
		ram_block11a_36.port_a_data_width = 1,
		ram_block11a_36.port_a_first_address = 0,
		ram_block11a_36.port_a_first_bit_number = 36,
		ram_block11a_36.port_a_last_address = 511,
		ram_block11a_36.port_a_logical_ram_depth = 512,
		ram_block11a_36.port_a_logical_ram_width = 97,
		ram_block11a_36.port_b_address_clear = "clear1",
		ram_block11a_36.port_b_address_clock = "clock1",
		ram_block11a_36.port_b_address_width = 9,
		ram_block11a_36.port_b_data_out_clear = "none",
		ram_block11a_36.port_b_data_width = 1,
		ram_block11a_36.port_b_first_address = 0,
		ram_block11a_36.port_b_first_bit_number = 36,
		ram_block11a_36.port_b_last_address = 511,
		ram_block11a_36.port_b_logical_ram_depth = 512,
		ram_block11a_36.port_b_logical_ram_width = 97,
		ram_block11a_36.port_b_read_enable_clock = "clock1",
		ram_block11a_36.ram_block_type = "AUTO",
		ram_block11a_36.lpm_type = "cycloneive_ram_block";
	cycloneive_ram_block   ram_block11a_37
	( 
	.clk0(clock0),
	.clk1(clock1),
	.clr1(aclr1),
	.ena0(wren_a),
	.portaaddr({address_a_wire[8:0]}),
	.portadatain({data_a[37]}),
	.portadataout(),
	.portawe(wren_a),
	.portbaddr({address_b_wire[8:0]}),
	.portbaddrstall(addressstall_b),
	.portbdataout(wire_ram_block11a_37portbdataout[0:0]),
	.portbre(1'b1)
	`ifndef FORMAL_VERIFICATION
	// synopsys translate_off
	`endif
	,
	.clr0(1'b0),
	.ena1(1'b1),
	.ena2(1'b1),
	.ena3(1'b1),
	.portaaddrstall(1'b0),
	.portabyteenamasks({1{1'b1}}),
	.portare(1'b1),
	.portbbyteenamasks({1{1'b1}}),
	.portbdatain({1{1'b0}}),
	.portbwe(1'b0)
	`ifndef FORMAL_VERIFICATION
	// synopsys translate_on
	`endif
	// synopsys translate_off
	,
	.devclrn(1'b1),
	.devpor(1'b1)
	// synopsys translate_on
	);
	defparam
		ram_block11a_37.clk0_core_clock_enable = "ena0",
		ram_block11a_37.clk0_input_clock_enable = "none",
		ram_block11a_37.clk1_core_clock_enable = "none",
		ram_block11a_37.clk1_input_clock_enable = "none",
		ram_block11a_37.connectivity_checking = "OFF",
		ram_block11a_37.logical_ram_name = "ALTSYNCRAM",
		ram_block11a_37.mixed_port_feed_through_mode = "dont_care",
		ram_block11a_37.operation_mode = "dual_port",
		ram_block11a_37.port_a_address_width = 9,
		ram_block11a_37.port_a_data_width = 1,
		ram_block11a_37.port_a_first_address = 0,
		ram_block11a_37.port_a_first_bit_number = 37,
		ram_block11a_37.port_a_last_address = 511,
		ram_block11a_37.port_a_logical_ram_depth = 512,
		ram_block11a_37.port_a_logical_ram_width = 97,
		ram_block11a_37.port_b_address_clear = "clear1",
		ram_block11a_37.port_b_address_clock = "clock1",
		ram_block11a_37.port_b_address_width = 9,
		ram_block11a_37.port_b_data_out_clear = "none",
		ram_block11a_37.port_b_data_width = 1,
		ram_block11a_37.port_b_first_address = 0,
		ram_block11a_37.port_b_first_bit_number = 37,
		ram_block11a_37.port_b_last_address = 511,
		ram_block11a_37.port_b_logical_ram_depth = 512,
		ram_block11a_37.port_b_logical_ram_width = 97,
		ram_block11a_37.port_b_read_enable_clock = "clock1",
		ram_block11a_37.ram_block_type = "AUTO",
		ram_block11a_37.lpm_type = "cycloneive_ram_block";
	cycloneive_ram_block   ram_block11a_38
	( 
	.clk0(clock0),
	.clk1(clock1),
	.clr1(aclr1),
	.ena0(wren_a),
	.portaaddr({address_a_wire[8:0]}),
	.portadatain({data_a[38]}),
	.portadataout(),
	.portawe(wren_a),
	.portbaddr({address_b_wire[8:0]}),
	.portbaddrstall(addressstall_b),
	.portbdataout(wire_ram_block11a_38portbdataout[0:0]),
	.portbre(1'b1)
	`ifndef FORMAL_VERIFICATION
	// synopsys translate_off
	`endif
	,
	.clr0(1'b0),
	.ena1(1'b1),
	.ena2(1'b1),
	.ena3(1'b1),
	.portaaddrstall(1'b0),
	.portabyteenamasks({1{1'b1}}),
	.portare(1'b1),
	.portbbyteenamasks({1{1'b1}}),
	.portbdatain({1{1'b0}}),
	.portbwe(1'b0)
	`ifndef FORMAL_VERIFICATION
	// synopsys translate_on
	`endif
	// synopsys translate_off
	,
	.devclrn(1'b1),
	.devpor(1'b1)
	// synopsys translate_on
	);
	defparam
		ram_block11a_38.clk0_core_clock_enable = "ena0",
		ram_block11a_38.clk0_input_clock_enable = "none",
		ram_block11a_38.clk1_core_clock_enable = "none",
		ram_block11a_38.clk1_input_clock_enable = "none",
		ram_block11a_38.connectivity_checking = "OFF",
		ram_block11a_38.logical_ram_name = "ALTSYNCRAM",
		ram_block11a_38.mixed_port_feed_through_mode = "dont_care",
		ram_block11a_38.operation_mode = "dual_port",
		ram_block11a_38.port_a_address_width = 9,
		ram_block11a_38.port_a_data_width = 1,
		ram_block11a_38.port_a_first_address = 0,
		ram_block11a_38.port_a_first_bit_number = 38,
		ram_block11a_38.port_a_last_address = 511,
		ram_block11a_38.port_a_logical_ram_depth = 512,
		ram_block11a_38.port_a_logical_ram_width = 97,
		ram_block11a_38.port_b_address_clear = "clear1",
		ram_block11a_38.port_b_address_clock = "clock1",
		ram_block11a_38.port_b_address_width = 9,
		ram_block11a_38.port_b_data_out_clear = "none",
		ram_block11a_38.port_b_data_width = 1,
		ram_block11a_38.port_b_first_address = 0,
		ram_block11a_38.port_b_first_bit_number = 38,
		ram_block11a_38.port_b_last_address = 511,
		ram_block11a_38.port_b_logical_ram_depth = 512,
		ram_block11a_38.port_b_logical_ram_width = 97,
		ram_block11a_38.port_b_read_enable_clock = "clock1",
		ram_block11a_38.ram_block_type = "AUTO",
		ram_block11a_38.lpm_type = "cycloneive_ram_block";
	cycloneive_ram_block   ram_block11a_39
	( 
	.clk0(clock0),
	.clk1(clock1),
	.clr1(aclr1),
	.ena0(wren_a),
	.portaaddr({address_a_wire[8:0]}),
	.portadatain({data_a[39]}),
	.portadataout(),
	.portawe(wren_a),
	.portbaddr({address_b_wire[8:0]}),
	.portbaddrstall(addressstall_b),
	.portbdataout(wire_ram_block11a_39portbdataout[0:0]),
	.portbre(1'b1)
	`ifndef FORMAL_VERIFICATION
	// synopsys translate_off
	`endif
	,
	.clr0(1'b0),
	.ena1(1'b1),
	.ena2(1'b1),
	.ena3(1'b1),
	.portaaddrstall(1'b0),
	.portabyteenamasks({1{1'b1}}),
	.portare(1'b1),
	.portbbyteenamasks({1{1'b1}}),
	.portbdatain({1{1'b0}}),
	.portbwe(1'b0)
	`ifndef FORMAL_VERIFICATION
	// synopsys translate_on
	`endif
	// synopsys translate_off
	,
	.devclrn(1'b1),
	.devpor(1'b1)
	// synopsys translate_on
	);
	defparam
		ram_block11a_39.clk0_core_clock_enable = "ena0",
		ram_block11a_39.clk0_input_clock_enable = "none",
		ram_block11a_39.clk1_core_clock_enable = "none",
		ram_block11a_39.clk1_input_clock_enable = "none",
		ram_block11a_39.connectivity_checking = "OFF",
		ram_block11a_39.logical_ram_name = "ALTSYNCRAM",
		ram_block11a_39.mixed_port_feed_through_mode = "dont_care",
		ram_block11a_39.operation_mode = "dual_port",
		ram_block11a_39.port_a_address_width = 9,
		ram_block11a_39.port_a_data_width = 1,
		ram_block11a_39.port_a_first_address = 0,
		ram_block11a_39.port_a_first_bit_number = 39,
		ram_block11a_39.port_a_last_address = 511,
		ram_block11a_39.port_a_logical_ram_depth = 512,
		ram_block11a_39.port_a_logical_ram_width = 97,
		ram_block11a_39.port_b_address_clear = "clear1",
		ram_block11a_39.port_b_address_clock = "clock1",
		ram_block11a_39.port_b_address_width = 9,
		ram_block11a_39.port_b_data_out_clear = "none",
		ram_block11a_39.port_b_data_width = 1,
		ram_block11a_39.port_b_first_address = 0,
		ram_block11a_39.port_b_first_bit_number = 39,
		ram_block11a_39.port_b_last_address = 511,
		ram_block11a_39.port_b_logical_ram_depth = 512,
		ram_block11a_39.port_b_logical_ram_width = 97,
		ram_block11a_39.port_b_read_enable_clock = "clock1",
		ram_block11a_39.ram_block_type = "AUTO",
		ram_block11a_39.lpm_type = "cycloneive_ram_block";
	cycloneive_ram_block   ram_block11a_40
	( 
	.clk0(clock0),
	.clk1(clock1),
	.clr1(aclr1),
	.ena0(wren_a),
	.portaaddr({address_a_wire[8:0]}),
	.portadatain({data_a[40]}),
	.portadataout(),
	.portawe(wren_a),
	.portbaddr({address_b_wire[8:0]}),
	.portbaddrstall(addressstall_b),
	.portbdataout(wire_ram_block11a_40portbdataout[0:0]),
	.portbre(1'b1)
	`ifndef FORMAL_VERIFICATION
	// synopsys translate_off
	`endif
	,
	.clr0(1'b0),
	.ena1(1'b1),
	.ena2(1'b1),
	.ena3(1'b1),
	.portaaddrstall(1'b0),
	.portabyteenamasks({1{1'b1}}),
	.portare(1'b1),
	.portbbyteenamasks({1{1'b1}}),
	.portbdatain({1{1'b0}}),
	.portbwe(1'b0)
	`ifndef FORMAL_VERIFICATION
	// synopsys translate_on
	`endif
	// synopsys translate_off
	,
	.devclrn(1'b1),
	.devpor(1'b1)
	// synopsys translate_on
	);
	defparam
		ram_block11a_40.clk0_core_clock_enable = "ena0",
		ram_block11a_40.clk0_input_clock_enable = "none",
		ram_block11a_40.clk1_core_clock_enable = "none",
		ram_block11a_40.clk1_input_clock_enable = "none",
		ram_block11a_40.connectivity_checking = "OFF",
		ram_block11a_40.logical_ram_name = "ALTSYNCRAM",
		ram_block11a_40.mixed_port_feed_through_mode = "dont_care",
		ram_block11a_40.operation_mode = "dual_port",
		ram_block11a_40.port_a_address_width = 9,
		ram_block11a_40.port_a_data_width = 1,
		ram_block11a_40.port_a_first_address = 0,
		ram_block11a_40.port_a_first_bit_number = 40,
		ram_block11a_40.port_a_last_address = 511,
		ram_block11a_40.port_a_logical_ram_depth = 512,
		ram_block11a_40.port_a_logical_ram_width = 97,
		ram_block11a_40.port_b_address_clear = "clear1",
		ram_block11a_40.port_b_address_clock = "clock1",
		ram_block11a_40.port_b_address_width = 9,
		ram_block11a_40.port_b_data_out_clear = "none",
		ram_block11a_40.port_b_data_width = 1,
		ram_block11a_40.port_b_first_address = 0,
		ram_block11a_40.port_b_first_bit_number = 40,
		ram_block11a_40.port_b_last_address = 511,
		ram_block11a_40.port_b_logical_ram_depth = 512,
		ram_block11a_40.port_b_logical_ram_width = 97,
		ram_block11a_40.port_b_read_enable_clock = "clock1",
		ram_block11a_40.ram_block_type = "AUTO",
		ram_block11a_40.lpm_type = "cycloneive_ram_block";
	cycloneive_ram_block   ram_block11a_41
	( 
	.clk0(clock0),
	.clk1(clock1),
	.clr1(aclr1),
	.ena0(wren_a),
	.portaaddr({address_a_wire[8:0]}),
	.portadatain({data_a[41]}),
	.portadataout(),
	.portawe(wren_a),
	.portbaddr({address_b_wire[8:0]}),
	.portbaddrstall(addressstall_b),
	.portbdataout(wire_ram_block11a_41portbdataout[0:0]),
	.portbre(1'b1)
	`ifndef FORMAL_VERIFICATION
	// synopsys translate_off
	`endif
	,
	.clr0(1'b0),
	.ena1(1'b1),
	.ena2(1'b1),
	.ena3(1'b1),
	.portaaddrstall(1'b0),
	.portabyteenamasks({1{1'b1}}),
	.portare(1'b1),
	.portbbyteenamasks({1{1'b1}}),
	.portbdatain({1{1'b0}}),
	.portbwe(1'b0)
	`ifndef FORMAL_VERIFICATION
	// synopsys translate_on
	`endif
	// synopsys translate_off
	,
	.devclrn(1'b1),
	.devpor(1'b1)
	// synopsys translate_on
	);
	defparam
		ram_block11a_41.clk0_core_clock_enable = "ena0",
		ram_block11a_41.clk0_input_clock_enable = "none",
		ram_block11a_41.clk1_core_clock_enable = "none",
		ram_block11a_41.clk1_input_clock_enable = "none",
		ram_block11a_41.connectivity_checking = "OFF",
		ram_block11a_41.logical_ram_name = "ALTSYNCRAM",
		ram_block11a_41.mixed_port_feed_through_mode = "dont_care",
		ram_block11a_41.operation_mode = "dual_port",
		ram_block11a_41.port_a_address_width = 9,
		ram_block11a_41.port_a_data_width = 1,
		ram_block11a_41.port_a_first_address = 0,
		ram_block11a_41.port_a_first_bit_number = 41,
		ram_block11a_41.port_a_last_address = 511,
		ram_block11a_41.port_a_logical_ram_depth = 512,
		ram_block11a_41.port_a_logical_ram_width = 97,
		ram_block11a_41.port_b_address_clear = "clear1",
		ram_block11a_41.port_b_address_clock = "clock1",
		ram_block11a_41.port_b_address_width = 9,
		ram_block11a_41.port_b_data_out_clear = "none",
		ram_block11a_41.port_b_data_width = 1,
		ram_block11a_41.port_b_first_address = 0,
		ram_block11a_41.port_b_first_bit_number = 41,
		ram_block11a_41.port_b_last_address = 511,
		ram_block11a_41.port_b_logical_ram_depth = 512,
		ram_block11a_41.port_b_logical_ram_width = 97,
		ram_block11a_41.port_b_read_enable_clock = "clock1",
		ram_block11a_41.ram_block_type = "AUTO",
		ram_block11a_41.lpm_type = "cycloneive_ram_block";
	cycloneive_ram_block   ram_block11a_42
	( 
	.clk0(clock0),
	.clk1(clock1),
	.clr1(aclr1),
	.ena0(wren_a),
	.portaaddr({address_a_wire[8:0]}),
	.portadatain({data_a[42]}),
	.portadataout(),
	.portawe(wren_a),
	.portbaddr({address_b_wire[8:0]}),
	.portbaddrstall(addressstall_b),
	.portbdataout(wire_ram_block11a_42portbdataout[0:0]),
	.portbre(1'b1)
	`ifndef FORMAL_VERIFICATION
	// synopsys translate_off
	`endif
	,
	.clr0(1'b0),
	.ena1(1'b1),
	.ena2(1'b1),
	.ena3(1'b1),
	.portaaddrstall(1'b0),
	.portabyteenamasks({1{1'b1}}),
	.portare(1'b1),
	.portbbyteenamasks({1{1'b1}}),
	.portbdatain({1{1'b0}}),
	.portbwe(1'b0)
	`ifndef FORMAL_VERIFICATION
	// synopsys translate_on
	`endif
	// synopsys translate_off
	,
	.devclrn(1'b1),
	.devpor(1'b1)
	// synopsys translate_on
	);
	defparam
		ram_block11a_42.clk0_core_clock_enable = "ena0",
		ram_block11a_42.clk0_input_clock_enable = "none",
		ram_block11a_42.clk1_core_clock_enable = "none",
		ram_block11a_42.clk1_input_clock_enable = "none",
		ram_block11a_42.connectivity_checking = "OFF",
		ram_block11a_42.logical_ram_name = "ALTSYNCRAM",
		ram_block11a_42.mixed_port_feed_through_mode = "dont_care",
		ram_block11a_42.operation_mode = "dual_port",
		ram_block11a_42.port_a_address_width = 9,
		ram_block11a_42.port_a_data_width = 1,
		ram_block11a_42.port_a_first_address = 0,
		ram_block11a_42.port_a_first_bit_number = 42,
		ram_block11a_42.port_a_last_address = 511,
		ram_block11a_42.port_a_logical_ram_depth = 512,
		ram_block11a_42.port_a_logical_ram_width = 97,
		ram_block11a_42.port_b_address_clear = "clear1",
		ram_block11a_42.port_b_address_clock = "clock1",
		ram_block11a_42.port_b_address_width = 9,
		ram_block11a_42.port_b_data_out_clear = "none",
		ram_block11a_42.port_b_data_width = 1,
		ram_block11a_42.port_b_first_address = 0,
		ram_block11a_42.port_b_first_bit_number = 42,
		ram_block11a_42.port_b_last_address = 511,
		ram_block11a_42.port_b_logical_ram_depth = 512,
		ram_block11a_42.port_b_logical_ram_width = 97,
		ram_block11a_42.port_b_read_enable_clock = "clock1",
		ram_block11a_42.ram_block_type = "AUTO",
		ram_block11a_42.lpm_type = "cycloneive_ram_block";
	cycloneive_ram_block   ram_block11a_43
	( 
	.clk0(clock0),
	.clk1(clock1),
	.clr1(aclr1),
	.ena0(wren_a),
	.portaaddr({address_a_wire[8:0]}),
	.portadatain({data_a[43]}),
	.portadataout(),
	.portawe(wren_a),
	.portbaddr({address_b_wire[8:0]}),
	.portbaddrstall(addressstall_b),
	.portbdataout(wire_ram_block11a_43portbdataout[0:0]),
	.portbre(1'b1)
	`ifndef FORMAL_VERIFICATION
	// synopsys translate_off
	`endif
	,
	.clr0(1'b0),
	.ena1(1'b1),
	.ena2(1'b1),
	.ena3(1'b1),
	.portaaddrstall(1'b0),
	.portabyteenamasks({1{1'b1}}),
	.portare(1'b1),
	.portbbyteenamasks({1{1'b1}}),
	.portbdatain({1{1'b0}}),
	.portbwe(1'b0)
	`ifndef FORMAL_VERIFICATION
	// synopsys translate_on
	`endif
	// synopsys translate_off
	,
	.devclrn(1'b1),
	.devpor(1'b1)
	// synopsys translate_on
	);
	defparam
		ram_block11a_43.clk0_core_clock_enable = "ena0",
		ram_block11a_43.clk0_input_clock_enable = "none",
		ram_block11a_43.clk1_core_clock_enable = "none",
		ram_block11a_43.clk1_input_clock_enable = "none",
		ram_block11a_43.connectivity_checking = "OFF",
		ram_block11a_43.logical_ram_name = "ALTSYNCRAM",
		ram_block11a_43.mixed_port_feed_through_mode = "dont_care",
		ram_block11a_43.operation_mode = "dual_port",
		ram_block11a_43.port_a_address_width = 9,
		ram_block11a_43.port_a_data_width = 1,
		ram_block11a_43.port_a_first_address = 0,
		ram_block11a_43.port_a_first_bit_number = 43,
		ram_block11a_43.port_a_last_address = 511,
		ram_block11a_43.port_a_logical_ram_depth = 512,
		ram_block11a_43.port_a_logical_ram_width = 97,
		ram_block11a_43.port_b_address_clear = "clear1",
		ram_block11a_43.port_b_address_clock = "clock1",
		ram_block11a_43.port_b_address_width = 9,
		ram_block11a_43.port_b_data_out_clear = "none",
		ram_block11a_43.port_b_data_width = 1,
		ram_block11a_43.port_b_first_address = 0,
		ram_block11a_43.port_b_first_bit_number = 43,
		ram_block11a_43.port_b_last_address = 511,
		ram_block11a_43.port_b_logical_ram_depth = 512,
		ram_block11a_43.port_b_logical_ram_width = 97,
		ram_block11a_43.port_b_read_enable_clock = "clock1",
		ram_block11a_43.ram_block_type = "AUTO",
		ram_block11a_43.lpm_type = "cycloneive_ram_block";
	cycloneive_ram_block   ram_block11a_44
	( 
	.clk0(clock0),
	.clk1(clock1),
	.clr1(aclr1),
	.ena0(wren_a),
	.portaaddr({address_a_wire[8:0]}),
	.portadatain({data_a[44]}),
	.portadataout(),
	.portawe(wren_a),
	.portbaddr({address_b_wire[8:0]}),
	.portbaddrstall(addressstall_b),
	.portbdataout(wire_ram_block11a_44portbdataout[0:0]),
	.portbre(1'b1)
	`ifndef FORMAL_VERIFICATION
	// synopsys translate_off
	`endif
	,
	.clr0(1'b0),
	.ena1(1'b1),
	.ena2(1'b1),
	.ena3(1'b1),
	.portaaddrstall(1'b0),
	.portabyteenamasks({1{1'b1}}),
	.portare(1'b1),
	.portbbyteenamasks({1{1'b1}}),
	.portbdatain({1{1'b0}}),
	.portbwe(1'b0)
	`ifndef FORMAL_VERIFICATION
	// synopsys translate_on
	`endif
	// synopsys translate_off
	,
	.devclrn(1'b1),
	.devpor(1'b1)
	// synopsys translate_on
	);
	defparam
		ram_block11a_44.clk0_core_clock_enable = "ena0",
		ram_block11a_44.clk0_input_clock_enable = "none",
		ram_block11a_44.clk1_core_clock_enable = "none",
		ram_block11a_44.clk1_input_clock_enable = "none",
		ram_block11a_44.connectivity_checking = "OFF",
		ram_block11a_44.logical_ram_name = "ALTSYNCRAM",
		ram_block11a_44.mixed_port_feed_through_mode = "dont_care",
		ram_block11a_44.operation_mode = "dual_port",
		ram_block11a_44.port_a_address_width = 9,
		ram_block11a_44.port_a_data_width = 1,
		ram_block11a_44.port_a_first_address = 0,
		ram_block11a_44.port_a_first_bit_number = 44,
		ram_block11a_44.port_a_last_address = 511,
		ram_block11a_44.port_a_logical_ram_depth = 512,
		ram_block11a_44.port_a_logical_ram_width = 97,
		ram_block11a_44.port_b_address_clear = "clear1",
		ram_block11a_44.port_b_address_clock = "clock1",
		ram_block11a_44.port_b_address_width = 9,
		ram_block11a_44.port_b_data_out_clear = "none",
		ram_block11a_44.port_b_data_width = 1,
		ram_block11a_44.port_b_first_address = 0,
		ram_block11a_44.port_b_first_bit_number = 44,
		ram_block11a_44.port_b_last_address = 511,
		ram_block11a_44.port_b_logical_ram_depth = 512,
		ram_block11a_44.port_b_logical_ram_width = 97,
		ram_block11a_44.port_b_read_enable_clock = "clock1",
		ram_block11a_44.ram_block_type = "AUTO",
		ram_block11a_44.lpm_type = "cycloneive_ram_block";
	cycloneive_ram_block   ram_block11a_45
	( 
	.clk0(clock0),
	.clk1(clock1),
	.clr1(aclr1),
	.ena0(wren_a),
	.portaaddr({address_a_wire[8:0]}),
	.portadatain({data_a[45]}),
	.portadataout(),
	.portawe(wren_a),
	.portbaddr({address_b_wire[8:0]}),
	.portbaddrstall(addressstall_b),
	.portbdataout(wire_ram_block11a_45portbdataout[0:0]),
	.portbre(1'b1)
	`ifndef FORMAL_VERIFICATION
	// synopsys translate_off
	`endif
	,
	.clr0(1'b0),
	.ena1(1'b1),
	.ena2(1'b1),
	.ena3(1'b1),
	.portaaddrstall(1'b0),
	.portabyteenamasks({1{1'b1}}),
	.portare(1'b1),
	.portbbyteenamasks({1{1'b1}}),
	.portbdatain({1{1'b0}}),
	.portbwe(1'b0)
	`ifndef FORMAL_VERIFICATION
	// synopsys translate_on
	`endif
	// synopsys translate_off
	,
	.devclrn(1'b1),
	.devpor(1'b1)
	// synopsys translate_on
	);
	defparam
		ram_block11a_45.clk0_core_clock_enable = "ena0",
		ram_block11a_45.clk0_input_clock_enable = "none",
		ram_block11a_45.clk1_core_clock_enable = "none",
		ram_block11a_45.clk1_input_clock_enable = "none",
		ram_block11a_45.connectivity_checking = "OFF",
		ram_block11a_45.logical_ram_name = "ALTSYNCRAM",
		ram_block11a_45.mixed_port_feed_through_mode = "dont_care",
		ram_block11a_45.operation_mode = "dual_port",
		ram_block11a_45.port_a_address_width = 9,
		ram_block11a_45.port_a_data_width = 1,
		ram_block11a_45.port_a_first_address = 0,
		ram_block11a_45.port_a_first_bit_number = 45,
		ram_block11a_45.port_a_last_address = 511,
		ram_block11a_45.port_a_logical_ram_depth = 512,
		ram_block11a_45.port_a_logical_ram_width = 97,
		ram_block11a_45.port_b_address_clear = "clear1",
		ram_block11a_45.port_b_address_clock = "clock1",
		ram_block11a_45.port_b_address_width = 9,
		ram_block11a_45.port_b_data_out_clear = "none",
		ram_block11a_45.port_b_data_width = 1,
		ram_block11a_45.port_b_first_address = 0,
		ram_block11a_45.port_b_first_bit_number = 45,
		ram_block11a_45.port_b_last_address = 511,
		ram_block11a_45.port_b_logical_ram_depth = 512,
		ram_block11a_45.port_b_logical_ram_width = 97,
		ram_block11a_45.port_b_read_enable_clock = "clock1",
		ram_block11a_45.ram_block_type = "AUTO",
		ram_block11a_45.lpm_type = "cycloneive_ram_block";
	cycloneive_ram_block   ram_block11a_46
	( 
	.clk0(clock0),
	.clk1(clock1),
	.clr1(aclr1),
	.ena0(wren_a),
	.portaaddr({address_a_wire[8:0]}),
	.portadatain({data_a[46]}),
	.portadataout(),
	.portawe(wren_a),
	.portbaddr({address_b_wire[8:0]}),
	.portbaddrstall(addressstall_b),
	.portbdataout(wire_ram_block11a_46portbdataout[0:0]),
	.portbre(1'b1)
	`ifndef FORMAL_VERIFICATION
	// synopsys translate_off
	`endif
	,
	.clr0(1'b0),
	.ena1(1'b1),
	.ena2(1'b1),
	.ena3(1'b1),
	.portaaddrstall(1'b0),
	.portabyteenamasks({1{1'b1}}),
	.portare(1'b1),
	.portbbyteenamasks({1{1'b1}}),
	.portbdatain({1{1'b0}}),
	.portbwe(1'b0)
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
